alphaonex86/FPGAmotherboard/i386/fpga-ep4ce22/3dmodels/Intel_PQFP-100_19.05x19.05mm_P0.635mm.step

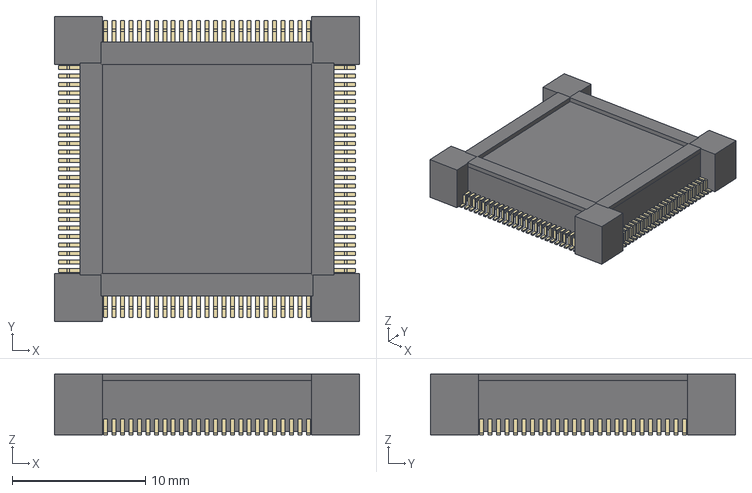
[picture p1: CAD file, 2026-10-18]
i386/fpga-ep4ce22/3dmodels/Intel_PQFP-100_19.05x19.05mm_P0.635mm.step
22.9 x 22.9 x 4.57 mm
