alphaonex86/FPGAmotherboard/i386/fpga-gw2ar18/hw/3dmodels/Oscillator_SMD_Abracon_ASE-4Pin_3.2x2.5mm.step

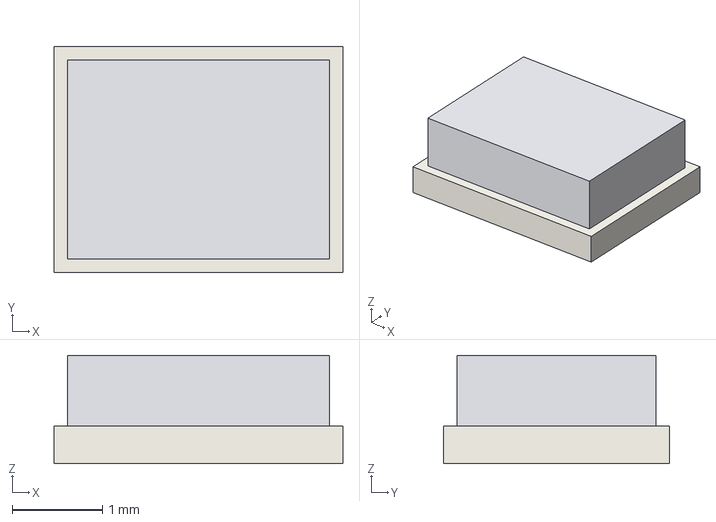
[picture p2: CAD file, 2026-10-18]
i386/fpga-gw2ar18/hw/3dmodels/Oscillator_SMD_Abracon_ASE-4Pin_3.2x2.5mm.step
3.20 x 2.50 x 1.20 mm
