alphaonex86/FPGAmotherboard/socket3/fpga-xc7a50t-csg324/hw/3dmodels/L_7.3x7.3_H4.5.step

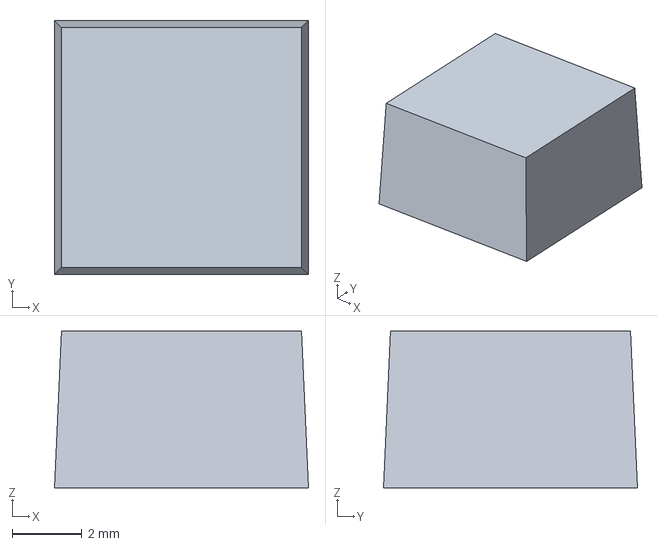
[picture p3: CAD file, 2026-10-29]
socket3/fpga-xc7a50t-csg324/hw/3dmodels/L_7.3x7.3_H4.5.step
7.30 x 7.30 x 4.50 mm
