alphaonex86/FPGAmotherboard/socket3/hw/3dmodels/Socket3_Am5x86_237.step

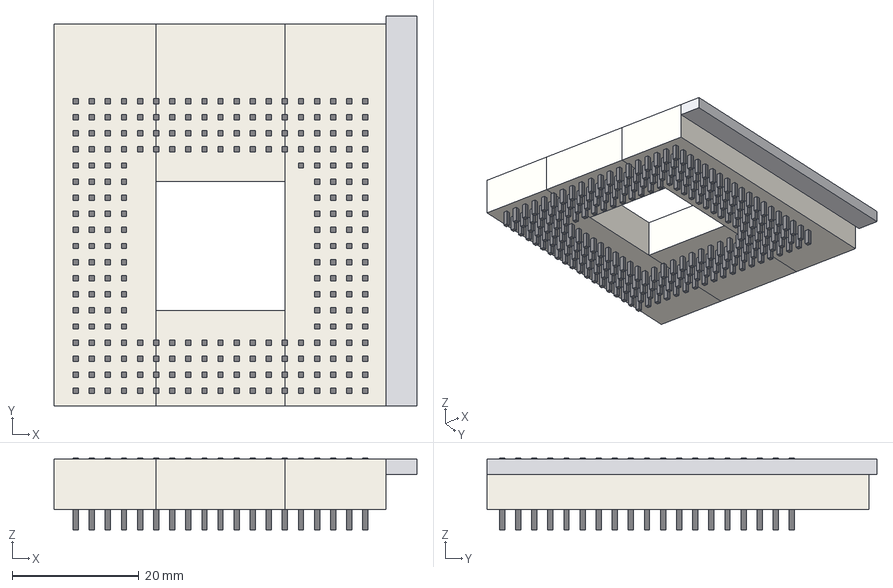
[picture p4: CAD file, 2026-10-29]
socket3/hw/3dmodels/Socket3_Am5x86_237.step
57.3 x 61.5 x 11.3 mm
