alphaonex86/FPGAmotherboard/socket370/fpga-ti180/hw/3dmodels/PGA370_Socket_ZIF.step

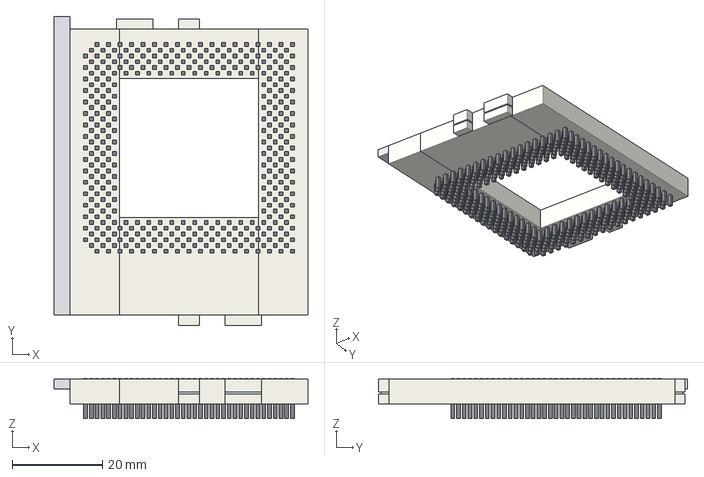
[picture p5: CAD file, 2026-10-18]
socket370/fpga-ti180/hw/3dmodels/PGA370_Socket_ZIF.step
56.1 x 68.3 x 8.89 mm
