alphaonex86/FPGAmotherboard/socket7/fpga-ti180/hw/3dmodels/Texas_RVF0040A_LQFN-CLIP-40_5x7mm_P0.5mm.step

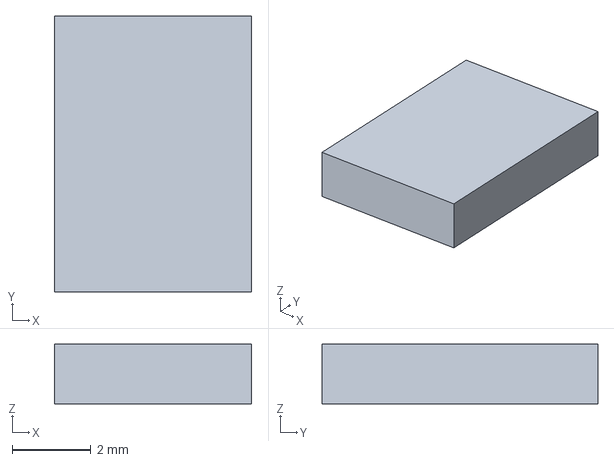
[picture p6: CAD file, 2026-10-18]
socket7/fpga-ti180/hw/3dmodels/Texas_RVF0040A_LQFN-CLIP-40_5x7mm_P0.5mm.step
5.00 x 7.00 x 1.52 mm
