alphaonex86/FPGAmotherboard/socket7/fpga-xc7a100t/3dmodels/Texas_RWW0021A_VQFN-HR-21_3x4mm.step

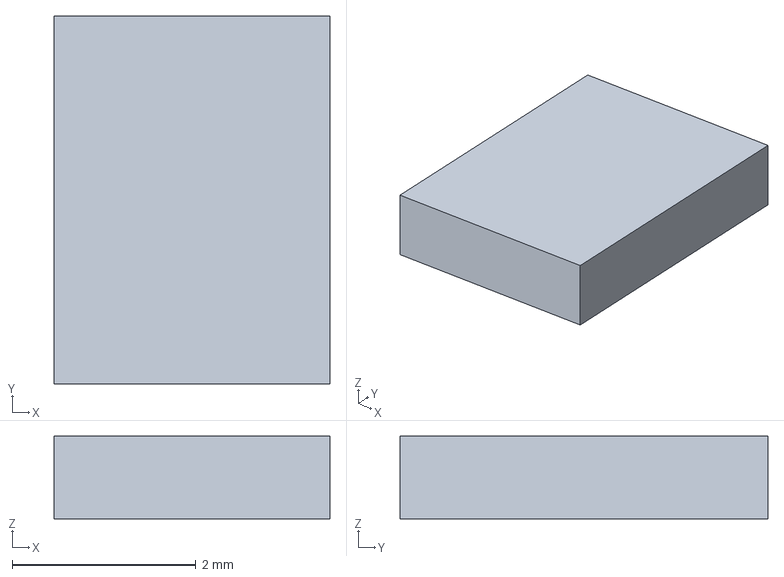
[picture p7: CAD file, 2026-10-18]
socket7/fpga-xc7a100t/3dmodels/Texas_RWW0021A_VQFN-HR-21_3x4mm.step
3.00 x 4.00 x 0.9 mm
