alphaonex86/FPGAmotherboard/i386/fpga-ep4ce22/3dmodels/L_6.3x6.3_H3.step

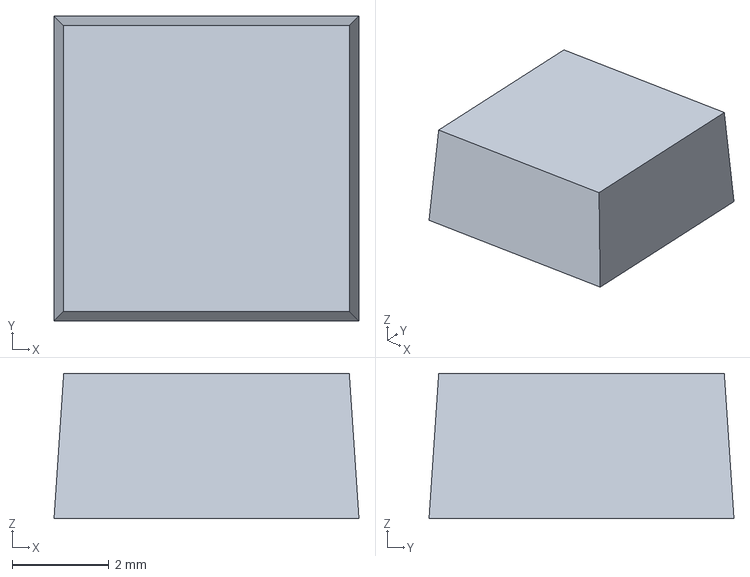
[picture p8: CAD file, 2026-10-18]
i386/fpga-ep4ce22/3dmodels/L_6.3x6.3_H3.step
6.30 x 6.30 x 3.00 mm
