alphaonex86/FPGAmotherboard/socket370/fpga-ti180/hw/3dmodels/Efinix_Ti180_J484_15x15mm.step

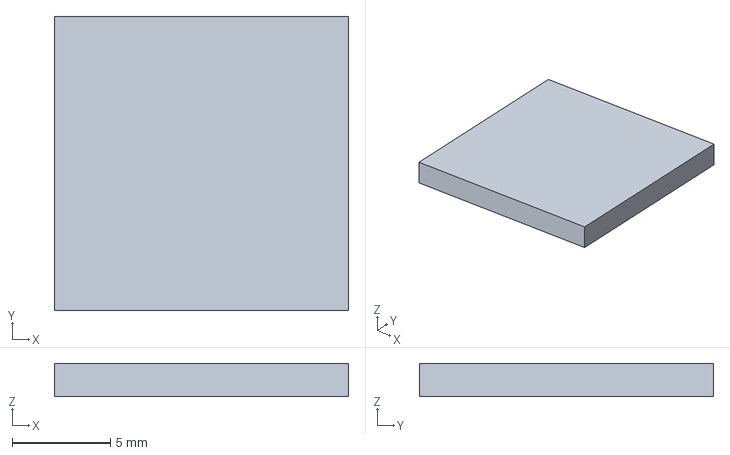
[picture p9: CAD file, 2026-10-18]
socket370/fpga-ti180/hw/3dmodels/Efinix_Ti180_J484_15x15mm.step
15.0 x 15.0 x 1.70 mm
