alphaonex86/FPGAmotherboard/socket7/fpga-ti180/hw/3dmodels/Socket7_P55C_296.step

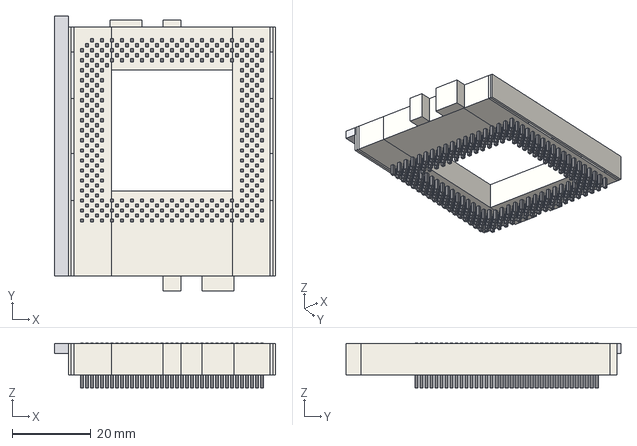
[picture p10: CAD file, 2026-10-18]
socket7/fpga-ti180/hw/3dmodels/Socket7_P55C_296.step
56.1 x 69.8 x 11.3 mm
