alphaonex86/FPGAmotherboard/socket3/fpga-xc7a50t-csg324/hw/3dmodels/RJ45_Hanrun_HR911105A_Horizontal.step

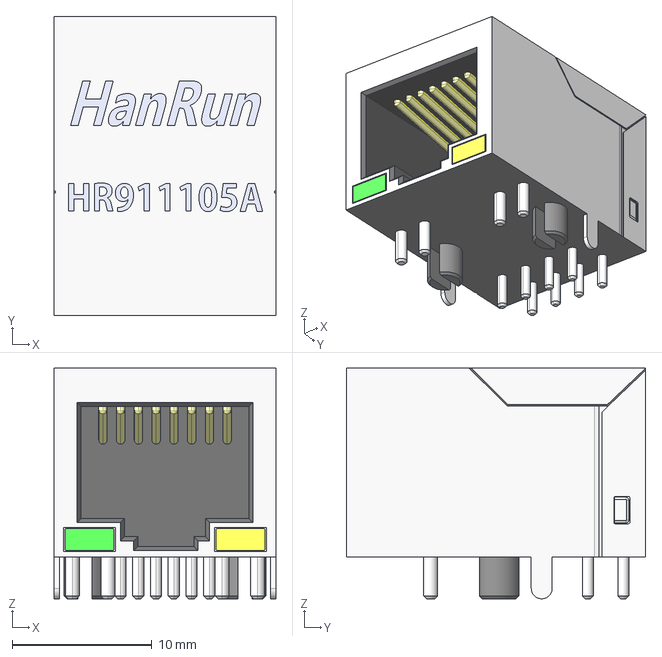
[picture p11: CAD file, 2026-10-18]
socket3/fpga-xc7a50t-csg324/hw/3dmodels/RJ45_Hanrun_HR911105A_Horizontal.step
15.9 x 21.4 x 16.5 mm
