alphaonex86/FPGAmotherboard/(list of files, cad)

Other CAD files:
socket370/fpga-xc7a100t/3dmodels/L_7.3x7.3_H4.5.step
i386/fpga-gw2ar18/hw/3dmodels/Intel_PQFP-100_19.05x19.05mm_P0.635mm.step
socket3/fpga-xc7a50t-csg324/hw/3dmodels/L_6.3x6.3_H3.step
socket3/hw/3dmodels/L_6.3x6.3_H3.step
i386/fpga-ep4ce22/3dmodels/Oscillator_SMD_Abracon_ASE-4Pin_3.2x2.5mm.step
i386/fpga-gw2ar18/hw/3dmodels/L_6.3x6.3_H3.step
socket3/hw/3dmodels/L_7.3x7.3_H4.5.step
socket370/fpga-xc7a100t/3dmodels/Texas_RVF0040A_LQFN-CLIP-40_5x7mm_P0.5mm.step
socket7/fpga-xc7a100t/3dmodels/L_7.3x7.3_H4.5.step
socket3/fpga-xc7a50t-csg324/hw/3dmodels/Texas_RVF0040A_LQFN-CLIP-40_5x7mm_P0.5mm.step
socket3/hw/3dmodels/Texas_RVF0040A_LQFN-CLIP-40_5x7mm_P0.5mm.step
socket370/fpga-ti180/hw/3dmodels/L_7.3x7.3_H4.5.step
socket370/fpga-xc7a100t/3dmodels/PGA370_Socket_ZIF.step
socket7/fpga-ti180/hw/3dmodels/L_7.3x7.3_H4.5.step
socket7/fpga-xc7a100t/3dmodels/Texas_RVF0040A_LQFN-CLIP-40_5x7mm_P0.5mm.step
socket370/fpga-ti180/hw/3dmodels/L_6.3x6.3_H3.step
socket7/fpga-ti180/hw/3dmodels/L_6.3x6.3_H3.step
socket7/fpga-xc7a100t/3dmodels/Socket7_P55C_296.step
