alphaonex86/FPGAmotherboard/socket3/fpga-xc7a50t-csg324/hw/socket3-csg324.kicad_pcb

## KiCad design socket3/fpga-xc7a50t-csg324/hw/socket3-csg324.kicad_pcb (2026-10-29)

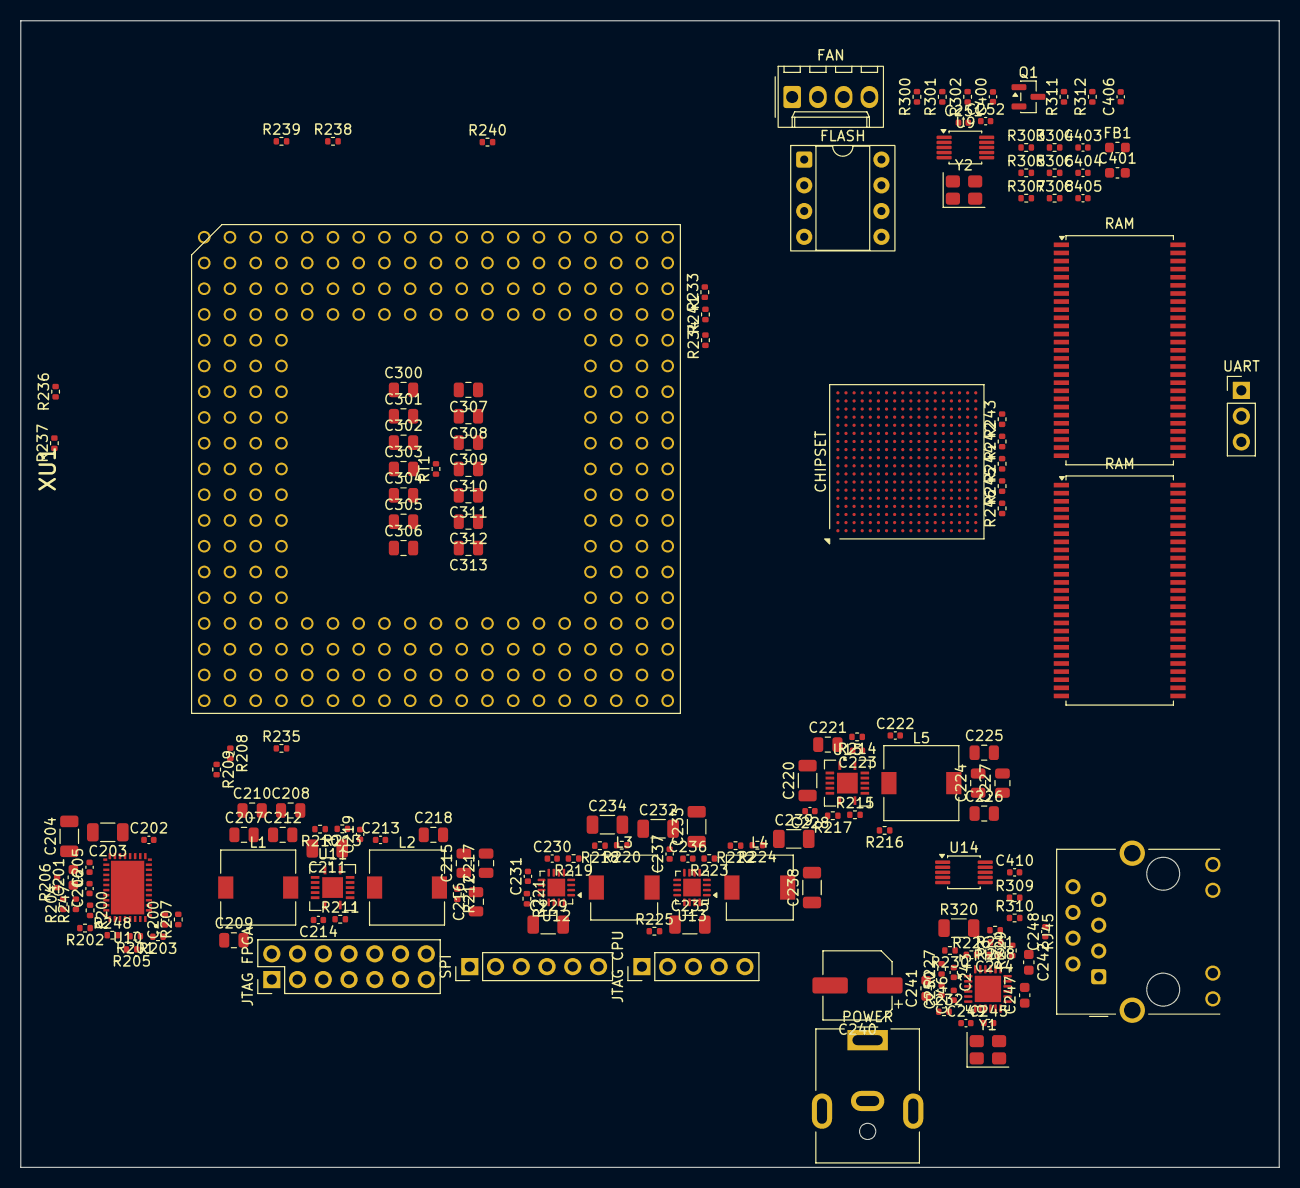
[picture p12: board socket3-csg324.kicad_pcb from above]

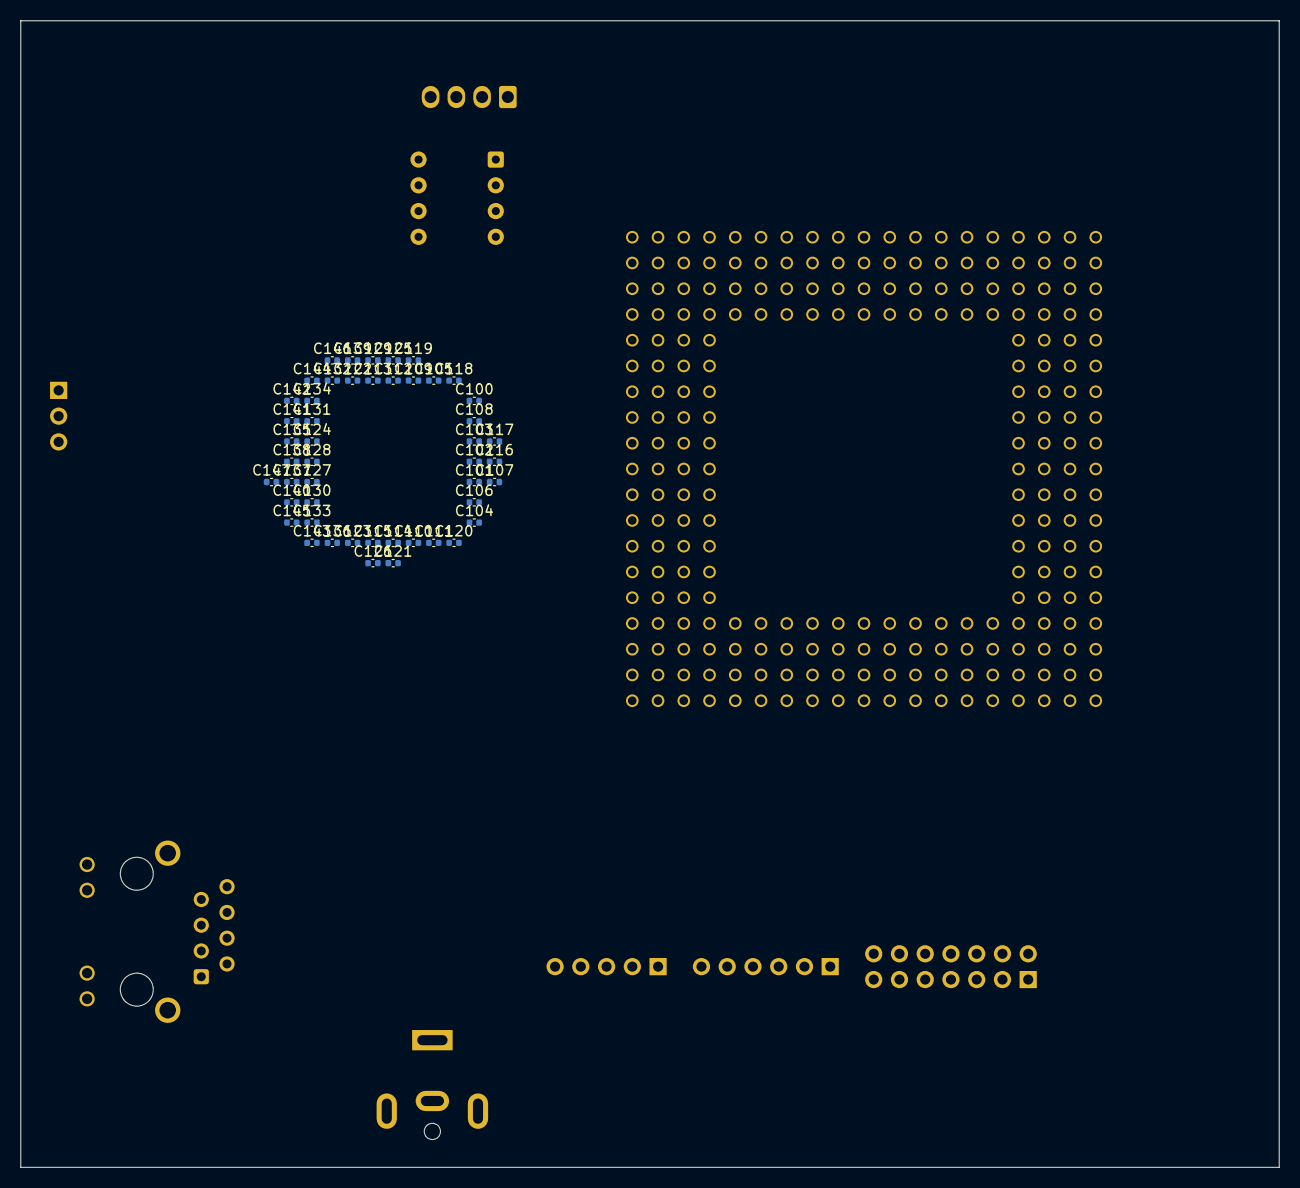
[picture p13: board socket3-csg324.kicad_pcb from below]

Board: 6 copper layers, 124.1 x 113.1 mm, 215 parts (48 on the bottom side), 267 nets, no tracks yet.

Parts:
C100, C101, C102, C103, C104, C105, C106, C107, C108, C109, C110, C111, C112, C113, C114, C115, C116, C117, C118, C119, C120, C121, C122, C123, C124, C125, C126, C127, C128, C129, C130, C131, C132, C133, C134, C135, C136, C137, C138, C139, C140, C141, C142, C143, C144, C145, C146, C147: 470nF; C_0402_1005Metric
C200: 1uF 16V X6S; C_0402_1005Metric
C201: 4.7uF 16V X5R; C_0603_1608Metric
C202: 100nF 16V X5R; C_0402_1005Metric
C203, C204, C211, C220, C229, C232, C233, C234, C235, C238, C239: 22uF 25V X5R; C_1206_3216Metric
C205, C214, C223, C403, C404, C405, C406: 10nF 50V X7R; C_0402_1005Metric
C206: 1uF 25V X5R; C_0402_1005Metric
C207, C208, C209, C210, C215, C216, C217, C218: 47uF 6.3V X5R; C_0805_2012Metric
C212, C221: 4.7uF 25V X7R; C_0805_2012Metric
C213, C222, C230, C236, C243, C244, C245, C248, C410: 100nF 16V X7R; C_0402_1005Metric
C219, C228: 8.2nF 50V X7R; C_0402_1005Metric
C224, C225, C226, C227: 47uF 10V X5R; C_0805_2012Metric
C231, C237: 3.3nF 50V X7R; C_0402_1005Metric
C240: 100uF 25V; CP_Elec_6.3x7.7
C241: 600R@100MHz bead; L_0603_1608Metric
C242: 10uF 10V X5R; C_0603_1608Metric
C246: 470pF 50V C0G; C_0402_1005Metric
C247: 1uF 16V X7R; C_0603_1608Metric
C249, C250: 15pF 50V C0G; C_0402_1005Metric
C251, C252: 4pF 50V C0G; C_0402_1005Metric
C300, C301, C302, C303, C304, C305, C306, C307, C308, C309, C310, C311, C312, C313: 22uF; C_0805_2012Metric
C400: 1nF 50V C0G; C_0402_1005Metric
C401: 470nF 50V X7R; C_0603_1608Metric
FB1: 600R@100MHz bead; L_0603_1608Metric
J1: HR911105A; RJ45_Hanrun_HR911105A_Horizontal
J2: SPI ISP; PinHeader_1x06_P2.54mm_Vertical
J3: PJ-063AH 12V; BarrelJack_CUI_PJ-063AH_Horizontal
J4: UART; PinHeader_1x03_P2.54mm_Vertical
J5: FPGA JTAG; PinHeader_2x07_P2.54mm_Vertical
J6: CPU JTAG; PinHeader_1x05_P2.54mm_Vertical
J7: fan 4-pin 1GND 2+12V 3TACH 4PWM; Molex_KK-254_AE-6410-04A_1x04_P2.54mm_Vertical
L1: VCORE out; L_7.3x7.3_H4.5
L2: 3V3 out; L_7.3x7.3_H4.5
L3: 1V0 out; L_6.3x6.3_H3
L4: 1V8 out; L_6.3x6.3_H3
L5: 5V out; L_7.3x7.3_H4.5
Q1: BSS138; SOT-23
R200: 10R 1%; R_0402_1005Metric
R201, R202, R205: 21.5k 1%; R_0402_1005Metric
R203: 90.9k 1%; R_0402_1005Metric
R204: 46.4k 1%; R_0402_1005Metric
R206: 4.64k 1%; R_0402_1005Metric
R207, R213, R217, R219, R223, R227, R233, R234, R235, R236, R237, R238, R239, R240, R301, R302, R303, R305, R309, R310, R311: 10k 1%; R_0402_1005Metric
R208: 1.33k 1%; R_0402_1005Metric
R209: 0R; R_0402_1005Metric
R210, R214, R220, R221, R224, R225: 100k 1%; R_0402_1005Metric
R211, R215, R300: 1.69k 1%; R_0402_1005Metric
R212: 31.6k 1%; R_0402_1005Metric
R216: 52.3k 1%; R_0402_1005Metric
R218, R308: 2.49k 1%; R_0402_1005Metric
R222: 12.4k 1%; R_0402_1005Metric
R226: 12.1k 1%; R_0402_1005Metric
R228, R229, R230, R231: 49.9 1%; R_0402_1005Metric
R232, R247: 500R 1%; R_0402_1005Metric
R241: 8.2k 1%; R_0402_1005Metric
R242, R243, R244, R248: 1k 1%; R_0402_1005Metric
R245, R246, R304, R306, R312: 4.02k 1%; R_0402_1005Metric
R307: 30.9k 1%; R_0402_1005Metric
R320: 10mR 1% 1W; R_1206_3216Metric
RT1: 10k NTC 1% B3380; R_0402_1005Metric
U2: XC7A50T-2CSG324I; Xilinx_CSG324
U3, U4: W9825G6KH-6I; TSOP-II-54_22.2x10.16mm_P0.8mm
U7: LAN8720A-CP-TR; QFN-24-1EP_4x4mm_P0.5mm_EP2.6x2.6mm
U8: W25Q64JVDAIQ (DIP-8, socketed); DIP-8_W7.62mm_Socket
U9: SI5351A-B-GTR; MSOP-10_3x3mm_P0.5mm
U10: TPS546B24ARVFR VCORE; Texas_RVF0040A_LQFN-CLIP-40_5x7mm_P0.5mm
U11: TPS54620RGYR 3V3; Texas_S-PVQFN-N14
U12: TPS62130RGTR 1V0; QFN-16-1EP_3x3mm_P0.5mm_EP1.75x1.75mm
U13: TPS62130RGTR 1V8; QFN-16-1EP_3x3mm_P0.5mm_EP1.75x1.75mm
U14: INA226AIDGSR; MSOP-10_3x3mm_P0.5mm
U15: TPS54620RGYR 5V; Texas_S-PVQFN-N14
XU1: Socket 3 ZIF 237p; Socket3_Am5x86_237
Y1, Y2: 25MHz; Crystal_SMD_3225-4Pin_3.2x2.5mm

Connections:
+1V0: C108.1, C111.1, C112.1, C115.1, C116.1, C120.1, C122.1, C123.1, C127.1, C128.1, C130.1, C131.1, C133.1, C134.1, C137.1, C138.1, C232.1, C233.1, C234.1, L3.2, R218.1, R220.1, U2.F8, U2.F10, U2.G7, U2.G9, U2.G11, U2.H8, U2.J7, U2.J11, U2.K8, U2.L7, U2.L11, U2.M8, U2.M10, U2.N7, U2.N9, U2.N11, U12.14
+1V8: C107.1, C109.1, C118.1, C124.1, C132.1, C238.1, C239.1, FB1.1, L4.2, R222.1, R224.1, U2.E8, U2.F12, U2.H12, U2.K12, U2.M12, U13.14
+1V8_ADC: C117.1, C401.1, FB1.2, U2.H10
+3V3: C100.1, C101.1, C102.1, C103.1, C104.1, C105.1, C106.1, C110.1, C113.1, C114.1, C119.1, C121.1, C125.1, C126.1, C129.1, C135.1, C136.1, C139.1, C140.1, C141.1, C142.1, C143.1, C144.1, C145.1, C146.1, C147.1, C215.1, C216.1, C217.1, C218.1, C241.1, C245.1, C410.1, J2.1, J5.2, L2.2, R207.1, R212.1, R242.2, R245.2, R246.2, R301.2, R305.1, R309.2, R310.2, R311.1, U2.A7, U2.A17, U2.B10, U2.C3, U2.C13, U2.D6, U2.D16, U2.F2, U2.G5, U2.G15, U2.H18, U2.J1, U2.K4, U2.K14, U2.L15, U2.L17, U2.N3, U2.N13, U2.P6, U2.P8, U2.P16, U2.R9, U2.T2, U2.T12, U2.U5, U2.U15, U2.V8, U2.V18, U3.1, U3.3, U3.9, U3.14, U3.27, U3.43, U3.49, U4.1, U4.3, U4.9, U4.14, U4.27, U4.43, U4.49, U7.9, U8.8, U9.1, U9.7, U14.6
+5V: C224.1, C225.1, C226.1, C227.1, C229.1, C230.1, C235.1, C236.1, L5.2, R216.1, R221.1, R225.1, U12.10, U12.11, U12.12, U13.10, U13.11, U13.12
+12V: C203.1, C204.1, C205.1, C211.1, C212.1, C220.1, C221.1, C240.1, J7.2, R200.1, R307.1, R320.2, U10.22, U10.23, U10.24, U10.25, U11.4, U11.5, U11.6, U14.8, U14.9, U15.4, U15.5, U15.6
+12V_IN: J3.1, R320.1, U14.10
GND: C100.2, C101.2, C102.2, C103.2, C104.2, C105.2, C106.2, C107.2, C108.2, C109.2, C110.2, C111.2, C112.2, C113.2, C114.2, C115.2, C116.2, C117.2, C118.2, C119.2, C120.2, C121.2, C122.2, C123.2, C124.2, C125.2, C126.2, C127.2, C128.2, C129.2, C130.2, C131.2, C132.2, C133.2, C134.2, C135.2, C136.2, C137.2, C138.2, C139.2, C140.2, C141.2, C142.2, C143.2, C144.2, C145.2, C146.2, C147.2, C201.2, C203.2, C204.2, C205.2, C206.2, C207.2, C208.2, C209.2, C210.2, C211.2, C212.2, C214.2, C215.2, C216.2, C217.2, C218.2, C219.2, C220.2, C221.2, C223.2, C224.2, C225.2, C226.2, C227.2, C228.2, C229.2, C230.2, C231.2, C232.2, C233.2, C234.2, C235.2, C236.2, C237.2, C238.2, C239.2, C240.2, C242.2, C243.2, C244.2, C245.2, C246.2, C247.2, C248.2, C249.2, C250.2, C251.2, C252.2, C300.2, C301.2, C302.2, C303.2, C304.2, C305.2, C306.2, C307.2, C308.2, C309.2, C310.2, C311.2, C312.2, C313.2, C400.2, C401.2, C403.2, C404.2, C405.2, C406.2, C410.2, J1.8, J1.SH, J2.2, J3.2, J4.1, J5.1, J5.3, J5.5, J5.7, J5.9, J5.11, J5.13, J6.5, J7.1, Q1.2, R202.2, R204.2, R206.2, R209.1, R210.2, R213.2, R214.2, R217.2, R219.2, R223.2, R226.2, R227.2, R239.2, R243.2, R244.2, R247.2, R302.2, R304.2, R306.2, R308.2, R312.2, RT1.2, U2.A2, U2.A12, U2.A18, U2.B5, U2.B12, U2.B14, U2.B15, U2.C8, U2.C14, U2.C18, U2.D1, U2.D11, U2.E4, U2.E14, U2.F7, U2.F9, U2.F11, U2.F17, U2.G8, U2.G10, U2.G12, U2.H3, U2.H7, U2.H9, U2.H11, U2.H13, U2.J6, U2.J8, U2.J9, U2.J10, U2.J12, U2.J16, U2.K7, U2.K9, U2.K10, U2.K11, U2.L2, U2.L8, U2.L12, U2.M5, U2.M7, U2.M9, U2.M11, U2.M15, U2.N8, U2.N10, U2.N12, U2.N18, U2.P1, U2.R4, U2.R14, U2.T7, U2.T17, U2.U10, U2.V3, U2.V13, U3.6, U3.12, U3.28, U3.41, U3.46, U3.52, U3.54, U4.6, U4.12, U4.28, U4.41, U4.46, U4.52, U4.54, U7.25, U8.4, U9.8, U10.6, U10.13, U10.14, U10.15, U10.16, U10.17, U10.18, U10.19, U10.20, U10.21, U10.36, U10.37, U10.41, U11.2, U11.3, U11.15, U12.6, U12.15, U12.16, U12.17, U13.6, U13.15, U13.16, U13.17, U14.1, U14.2, U14.7, U15.2, U15.3, U15.15, XU1.A7 (VSS), XU1.A9 (VSS), XU1.A11 (VSS), XU1.B3 (VSS), XU1.B4 (VSS), XU1.B5 (VSS), XU1.E1 (VSS), XU1.E17 (VSS), XU1.G1 (VSS), XU1.G17 (VSS), XU1.H1 (VSS), XU1.H17 (VSS), XU1.K1 (VSS), XU1.K17 (VSS), XU1.L1 (VSS), XU1.L17 (VSS), XU1.M1 (VSS), XU1.M17 (VSS), XU1.P17 (VSS), XU1.Q2 (VSS), XU1.R4 (VSS), XU1.R17 (CLKMUL), XU1.S6 (VSS), XU1.S8 (VSS), XU1.S9 (VSS), XU1.S10 (VSS), XU1.S11 (VSS), XU1.S12 (VSS), XU1.S14 (VSS), Y1.2, Y1.4, Y2.2, Y2.4
VCORE: C207.1, C208.1, C209.1, C210.1, C300.1, C301.1, C302.1, C303.1, C304.1, C305.1, C306.1, C307.1, C308.1, C309.1, C310.1, C311.1, C312.1, C313.1, L1.2, R208.1, R233.2, R234.2, R235.2, R236.2, R237.2, R238.2, R240.2, R241.2, R303.1, XU1.B7 (VCC), XU1.B9 (VCC), XU1.B11 (VCC), XU1.C4 (VCC), XU1.C5 (VCC), XU1.E2 (VCC), XU1.E16 (VCC), XU1.G2 (VCC), XU1.G16 (VCC), XU1.H16 (VCC), XU1.K2 (VCC), XU1.K16 (VCC), XU1.L16 (VCC), XU1.M2 (VCC), XU1.M16 (VCC), XU1.P16 (VCC), XU1.R3 (VCC), XU1.R6 (VCC), XU1.R8 (VCC), XU1.R9 (VCC), XU1.R10 (VCC), XU1.R11 (VCC), XU1.R14 (VCC)
cpu_a20m_n: U2.A13, XU1.D15 (A20M)
cpu_a[2]: U2.A3, XU1.Q14 (A2)
cpu_a[3]: U2.D2, XU1.R15 (A3)
cpu_a[4]: U2.H1, XU1.S16 (A4)
cpu_a[5]: U2.H4, XU1.Q12 (A5)
cpu_a[6]: U2.G1, XU1.S15 (A6)
cpu_a[7]: U2.J4, XU1.Q13 (A7)
cpu_a[8]: U2.C2, XU1.R13 (A8)
cpu_a[9]: U2.G4, XU1.Q11 (A9)
cpu_a[10]: U2.F1, XU1.S13 (A10)
cpu_a[11]: U2.B2, XU1.R12 (A11)
cpu_a[12]: U2.E1, XU1.S7 (A12)
cpu_a[13]: U2.F4, XU1.Q10 (A13)
cpu_a[14]: U2.C1, XU1.S5 (A14)
cpu_a[15]: U2.J3, XU1.R7 (A15)
cpu_a[16]: U2.D4, XU1.Q9 (A16)
cpu_a[17]: U2.F5, XU1.Q3 (A17)
cpu_a[18]: U2.G3, XU1.R5 (A18)
cpu_a[19]: U2.H5, XU1.Q4 (A19)
cpu_a[20]: U2.C4, XU1.Q8 (A20)
cpu_a[21]: U2.J5, XU1.Q5 (A21)
cpu_a[22]: U2.B4, XU1.Q7 (A22)
cpu_a[23]: U2.J2, XU1.S3 (A23)
cpu_a[24]: U2.A4, XU1.Q6 (A24)
cpu_a[25]: U2.F3, XU1.R2 (A25)
cpu_a[26]: U2.H2, XU1.S2 (A26)
cpu_a[27]: U2.G2, XU1.S1 (A27)
cpu_a[28]: U2.E3, XU1.R1 (A28)
cpu_a[29]: U2.A5, XU1.P2 (A29)
cpu_a[30]: U2.C5, XU1.P3 (A30)
cpu_a[31]: U2.E5, XU1.Q1 (A31)
cpu_ads_n: U2.K1, XU1.S17 (ADS)
cpu_ahold: U2.G17, XU1.A17 (AHOLD)
cpu_be_n[0]: U2.D8, XU1.K15 (BE0)
cpu_be_n[1]: U2.D9, XU1.J16 (BE1)
cpu_be_n[2]: U2.C9, XU1.J15 (BE2)
cpu_be_n[3]: U2.B11, XU1.F17 (BE3)
cpu_blast_n: U2.E2, XU1.R16 (BLAST)
cpu_boff_n: U2.D13, XU1.D17 (BOFF)
cpu_brdy_n: U2.D10, XU1.H15 (BRDY)
cpu_breq: U2.B3, XU1.Q15 (BREQ)
cpu_bs8_n: R234.1, XU1.D16 (BS8)
cpu_bs16_n: R233.1, XU1.C17 (BS16)
cpu_cache_n: U2.E16, XU1.B12 (CACHE)
cpu_clk: U9.10, XU1.C3 (CLK)
cpu_d[0]: U2.H6, XU1.P1 (D0)
cpu_d[1]: U2.C6, XU1.N2 (D1)
cpu_d[2]: U2.B6, XU1.N1 (D2)
cpu_d[3]: U2.C10, XU1.H2 (D3)
cpu_d[4]: U2.E7, XU1.M3 (D4)
cpu_d[5]: U2.A9, XU1.J2 (D5)
cpu_d[6]: U2.B7, XU1.L2 (D6)
cpu_d[7]: U2.C7, XU1.L3 (D7)
cpu_d[8]: U2.J13, XU1.F2 (D8)
cpu_d[9]: U2.G14, XU1.D1 (D9)
cpu_d[10]: U2.F13, XU1.E3 (D10)
cpu_d[11]: U2.K16, XU1.C1 (D11)
cpu_d[12]: U2.C11, XU1.G3 (D12)
cpu_d[13]: U2.H14, XU1.D2 (D13)
cpu_d[14]: U2.B8, XU1.K3 (D14)
cpu_d[15]: U2.K13, XU1.F3 (D15)
cpu_d[16]: U2.B9, XU1.J3 (D16)
cpu_d[17]: U2.J14, XU1.D3 (D17)
cpu_d[18]: U2.A15, XU1.C2 (D18)
cpu_d[19]: U2.H17, XU1.B1 (D19)
cpu_d[20]: U2.D18, XU1.A1 (D20)
cpu_d[21]: U2.J17, XU1.B2 (D21)
cpu_d[22]: U2.E18, XU1.A2 (D22)
cpu_d[23]: U2.F18, XU1.A4 (D23)
cpu_d[24]: U2.G18, XU1.A6 (D24)
cpu_d[25]: U2.A16, XU1.B6 (D25)
cpu_d[26]: U2.D15, XU1.C7 (D26)
cpu_d[27]: U2.C15, XU1.C6 (D27)
cpu_d[28]: U2.E15, XU1.C8 (D28)
cpu_d[29]: U2.J18, XU1.A8 (D29)
cpu_d[30]: U2.F15, XU1.C9 (D30)
cpu_d[31]: U2.B16, XU1.B8 (D31)
cpu_dc_n: U2.A6, XU1.M15 (D_C)
cpu_dp[0]: R235.1, XU1.N3 (DP0)
cpu_dp[1]: R236.1, XU1.F1 (DP1)
cpu_dp[2]: R237.1, XU1.H3 (DP2)
cpu_dp[3]: R238.1, XU1.A5 (DP3)
cpu_eads_n: U2.H16, XU1.B17 (EADS)
cpu_ferr_n: U2.K15, XU1.C14 (FERR)
cpu_flush_n: U2.A14, XU1.C15 (FLUSH)
cpu_hitm_n: U2.C17, XU1.A12 (HITM)
cpu_hlda: U2.D5, XU1.P15 (HLDA)
cpu_hold: U2.G13, XU1.E15 (HOLD)
cpu_ignne_n: U2.D17, XU1.A15 (IGNNE)
cpu_intr: U2.E17, XU1.A16 (INTR)
cpu_inv: U2.B17, XU1.A10 (INV)
cpu_ken_n: U2.D12, XU1.F15 (KEN)
cpu_lock_n: U2.E6, XU1.N15 (LOCK)
cpu_mio_n: U2.F6, XU1.N16 (M_IO)
cpu_nmi: U2.G16, XU1.B15 (NMI)
cpu_pcd: U2.A8, XU1.J17 (PCD)
cpu_plock_n: U2.D3, XU1.Q16 (PLOCK)
cpu_pwt: U2.D7, XU1.L15 (PWT)
cpu_rdy_n: U2.A11, XU1.F16 (RDY)
cpu_reset: R241.1, U2.F14, XU1.C16 (RESET)
cpu_smi_n: U2.C16, XU1.B10 (SMI)
cpu_smiact_n: U2.J15, XU1.C12 (SMIACT)
cpu_sreset: U2.H15, XU1.C10 (SRESET)
cpu_stpclk_n: U2.A10, XU1.G15 (STPCLK)
cpu_tck: J6.1, R239.1, XU1.A3 (TCK)
cpu_tdi: J6.3, XU1.A14 (TDI)
cpu_tdo: J6.4, XU1.B16 (TDO)
cpu_tms: J6.2, XU1.B14 (TMS)
cpu_up_n: R240.1, XU1.C11 (UP)
cpu_voldet: U2.B1, XU1.S4 (VOLDET)
cpu_wbwt_n: U2.F16, XU1.B13 (WB_WT)
cpu_wr_n: U2.G6, XU1.N17 (W_R)
en_vcore: R247.1, U2.A1, U10.27
eth_mdc: U2.L4, U7.13
eth_mdi_rxn: J1.6, R231.1, U7.22
eth_mdi_rxp: J1.3, R230.1, U7.23
eth_mdi_txn: J1.2, R229.1, U7.20
eth_mdi_txp: J1.1, R228.1, U7.21
eth_mdio: U2.L1, U7.12
eth_nintsel: R227.1, U7.2
eth_rbias: R226.1, U7.24
eth_ref_clk: U2.N5, U7.14
eth_rmii_crs_dv: U2.M3, U7.11
eth_rmii_rx_er: U2.L3, U7.10
eth_rmii_rxd[0]: U2.K3, U7.8
eth_rmii_rxd[1]: U2.M4, U7.7
eth_rmii_tx_en: U2.M6, U7.16
eth_rmii_txd[0]: U2.L6, U7.17
eth_rmii_txd[1]: U2.K6, U7.18
eth_rst_n: U2.K5, U7.15
eth_vdda: C241.2, C242.1, C243.1, C244.1, C248.1, J1.4, J1.5, R228.2, R229.2, R230.2, R231.2, U7.1, U7.19
eth_vddcr: C246.1, C247.1, U7.6
eth_xtal1: C249.1, U7.5, Y1.1
eth_xtal2: C250.1, R232.1, Y1.3
eth_xtal2_drv: R232.2, U7.4
fan_pwm: J7.4, Q1.3
fan_pwm_g: Q1.1, R302.1, U2.V17
fan_tach: J7.3, R300.1, R301.1
fan_tach_f: C400.1, R300.2, U2.V16
fpga_init_b: R246.1, U2.P7
fpga_m0: R242.1, U2.P12
fpga_m1: R243.1, U2.P13
fpga_m2: R244.1, U2.P11
fpga_program_b: R245.1, U2.P9
fpga_refclk: U2.P15, U9.9
i2c_scl: R309.1, U2.V14, U9.4, U10.3, U14.5
i2c_sda: R310.1, U2.V12, U9.5, U10.2, U14.4
jtag_tck: J5.6, U2.E10
jtag_tdi: J5.10, U2.E11
jtag_tdo: J5.8, U2.E13
jtag_tms: J5.4, U2.E12
sdram_a[0]: U2.R3, U3.23, U4.23
sdram_a[1]: U2.N2, U3.24, U4.24
sdram_a[2]: U2.R2, U3.25, U4.25
sdram_a[3]: U2.R1, U3.26, U4.26
sdram_a[4]: U2.T1, U3.29, U4.29
sdram_a[5]: U2.N1, U3.30, U4.30
sdram_a[6]: U2.P2, U3.31, U4.31
sdram_a[7]: U2.T3, U3.32, U4.32
sdram_a[8]: U2.P3, U3.33, U4.33
sdram_a[9]: U2.P4, U3.34, U4.34
sdram_a[10]: U2.T4, U3.22, U4.22
sdram_a[11]: U2.T5, U3.35, U4.35
sdram_a[12]: U2.P5, U3.36, U4.36
sdram_ba[0]: U2.R5, U3.20, U4.20
sdram_ba[1]: U2.N4, U3.21, U4.21
sdram_cas_n: U2.T8, U3.17, U4.17
sdram_cke: U2.T6, U3.37, U4.37
sdram_clk: U2.R7, U3.38, U4.38
sdram_cs_n: U2.L5, U3.19, U4.19
sdram_dq[0]: U2.R18, U3.2
sdram_dq[1]: U2.U18, U3.4
sdram_dq[2]: U2.T16, U3.5
sdram_dq[3]: U2.T15, U3.7
sdram_dq[4]: U2.U14, U3.8
sdram_dq[5]: U2.U13, U3.10
sdram_dq[6]: U2.T11, U3.11
sdram_dq[7]: U2.V11, U3.13
sdram_dq[8]: U2.T10, U3.42
sdram_dq[9]: U2.U11, U3.44
sdram_dq[10]: U2.U12, U3.45
sdram_dq[11]: U2.T13, U3.47
sdram_dq[12]: U2.T14, U3.48
sdram_dq[13]: U2.U16, U3.50
sdram_dq[14]: U2.U17, U3.51
sdram_dq[15]: U2.T18, U3.53
sdram_dq[16]: U2.U9, U4.2
sdram_dq[17]: U2.U8, U4.4
sdram_dq[18]: U2.V7, U4.5
sdram_dq[19]: U2.U6, U4.7
sdram_dq[20]: U2.V5, U4.8
sdram_dq[21]: U2.V4, U4.10
sdram_dq[22]: U2.M2, U4.11
sdram_dq[23]: U2.V2, U4.13
sdram_dq[24]: U2.M1, U4.42
sdram_dq[25]: U2.U2, U4.44
sdram_dq[26]: U2.U3, U4.45
sdram_dq[27]: U2.U4, U4.47
sdram_dq[28]: U2.V6, U4.48
sdram_dq[29]: U2.N6, U4.50
sdram_dq[30]: U2.U7, U4.51
sdram_dq[31]: U2.V9, U4.53
sdram_dqm[0]: U2.V10, U3.15
sdram_dqm[1]: U2.T9, U3.39
sdram_dqm[2]: U2.U1, U4.15
sdram_dqm[3]: U2.V1, U4.39
sdram_ras_n: U2.R6, U3.18, U4.18
sdram_we_n: U2.R8, U3.16, U4.16
spi_clk: J2.4, U2.E9, U8.6
spi_cs_n: J2.3, U2.L13, U8.1
spi_dq0: J2.6, U2.K17, U8.5
spi_dq1: J2.5, U2.K18, U8.2
spi_dq2: U2.L14, U8.3
spi_dq3: U2.M14, U8.7
sw_1v0: L3.1, U12.1, U12.2, U12.3
sw_1v8: L4.1, U13.1, U13.2, U13.3
sw_3v3: C213.2, L2.1, U11.11, U11.12
sw_5v: C222.2, L5.1, U15.11, U15.12
sw_vcore: C202.2, L1.1, U10.8, U10.9, U10.10, U10.11, U10.12
tsen_socket: C406.1, R311.2, R312.1, RT1.1, U2.B13
u9_xa: C251.1, U9.2, Y2.1
u9_xb: C252.1, U9.3, Y2.3
u10_avin: C206.1, R200.2, U10.26
u10_boot: C202.1, U10.7
u10_bp1v5: C200.1, R201.1, R203.1, R205.1, U10.4
u10_drtn: C200.2, U10.5
u10_msel1: R201.2, R202.1, U10.32
u10_msel2: R203.2, R204.1, U10.29
u10_pgood: R207.2, U10.1
u10_vdd5: C201.1, U10.28
u10_vsel: R205.2, R206.1, U10.30
u11_boot: C213.1, U11.13
u11_comp: R211.1, U11.8
u11_compz: C219.1, R211.2
u11_fb: R212.2, R213.1, U11.7
u11_rt: R210.1, U11.1
u11_ss: C214.1, U11.9
u12_en: R221.2, U12.13
u12_fb: R218.2, R219.1, U12.5
u12_pg: R220.2, U12.4
u12_ss: C231.1, U12.9
u13_en: R225.2, U13.13
u13_fb: R222.2, R223.1, U13.5
u13_pg: R224.2, U13.4
u13_ss: C237.1, U13.9
u15_boot: C222.1, U15.13
u15_comp: R215.1, U15.8
u15_compz: C228.1, R215.2
u15_fb: R216.2, R217.1, U15.7
u15_rt: R214.1, U15.1
u15_ss: C223.1, U15.9
uart_rx: J4.2, U2.R15
uart_tx: J4.3, U2.R13
vcore_gsense: R209.2, R248.2, U10.34
vcore_sense: R208.2, R248.1, U10.33
vsen_3v3: C404.1, R305.2, R306.1, U2.C12
vsen_12v: C405.1, R307.2, R308.1, U2.B18
vsen_vcore: C403.1, R303.2, R304.1, U2.D14
