alphaonex86/FPGAmotherboard/socket7/fpga-xc7a100t/socket7-motherboard.kicad_pcb

## KiCad design socket7/fpga-xc7a100t/socket7-motherboard.kicad_pcb (2026-10-29)

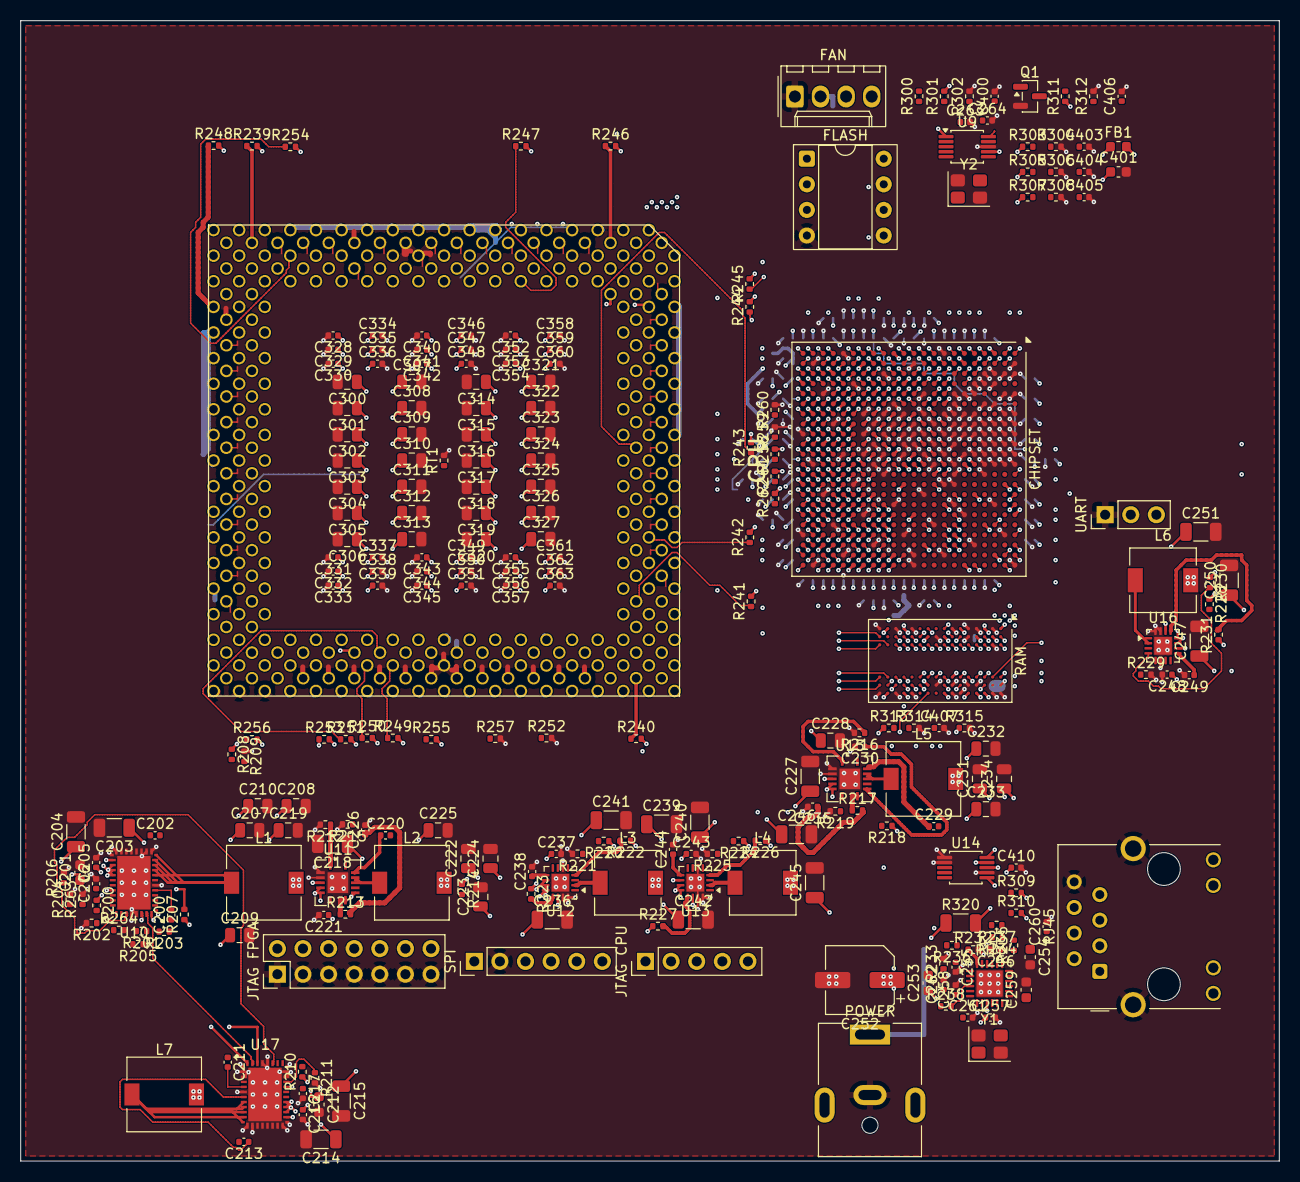
[picture p14: board socket7-motherboard.kicad_pcb from above]

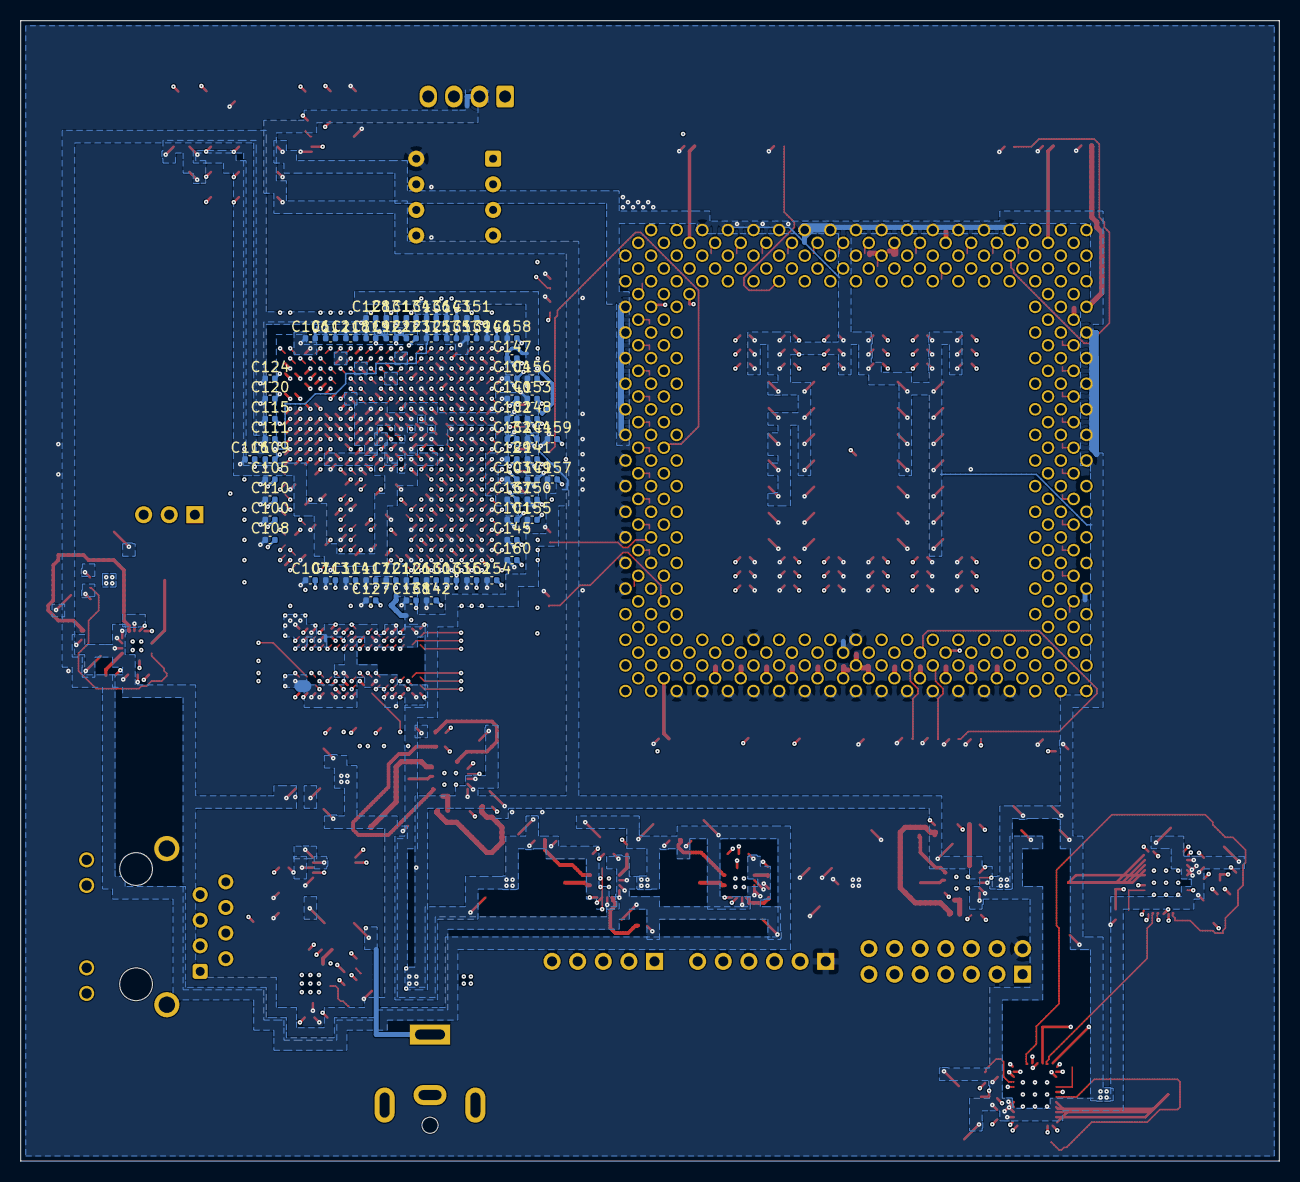
[picture p15: board socket7-motherboard.kicad_pcb from below]

Board: 8 copper layers, 124.8 x 113.1 mm, 313 parts (61 on the bottom side), 311 nets.

Parts:
C100, C101, C102, C103, C104, C105, C106, C107, C108, C109, C110, C111, C112, C113, C114, C115, C116, C117, C118, C119, C120, C121, C122, C123, C124, C125, C126, C127, C128, C129, C130, C131, C132, C133, C134, C135, C136, C137, C138, C139, C140, C141, C142, C143, C144, C145, C146, C147, C148, C149, C150, C151, C152, C153, C154, C155, C156, C157, C158, C159, C160: 470nF; C_0402_1005Metric
C200, C211: 1uF 16V X6S; C_0402_1005Metric
C201, C212: 4.7uF 16V X5R; C_0603_1608Metric
C202, C213: 100nF 16V X5R; C_0402_1005Metric
C203, C204, C214, C215, C218, C227, C236, C239, C240, C241, C242, C245, C246, C247, C250, C251: 22uF 25V X5R; C_1206_3216Metric
C205, C216, C221, C230, C403, C404, C405, C406: 10nF 50V X7R; C_0402_1005Metric
C206, C217: 1uF 25V X5R; C_0402_1005Metric
C207, C208, C209, C210, C222, C223, C224, C225: 47uF 6.3V X5R; C_0805_2012Metric
C219, C228: 4.7uF 25V X7R; C_0805_2012Metric
C220, C229, C237, C243, C248, C255, C256, C257, C260, C407, C410: 100nF 16V X7R; C_0402_1005Metric
C226, C235: 8.2nF 50V X7R; C_0402_1005Metric
C231, C232, C233, C234: 47uF 10V X5R; C_0805_2012Metric
C238, C244, C249: 3.3nF 50V X7R; C_0402_1005Metric
C252: 100uF 25V; CP_Elec_6.3x7.7
C253: 600R@100MHz bead; L_0603_1608Metric
C254: 10uF 10V X5R; C_0603_1608Metric
C258: 470pF 50V C0G; C_0402_1005Metric
C259: 1uF 16V X7R; C_0603_1608Metric
C261, C262: 15pF 50V C0G; C_0402_1005Metric
C263, C264: 4pF 50V C0G; C_0402_1005Metric
C300, C301, C302, C303, C304, C305, C306, C307, C308, C309, C310, C311, C312, C313, C314, C315, C316, C317, C318, C319, C320, C321, C322, C323, C324, C325, C326, C327: 22uF; C_0805_2012Metric
C328, C329, C330, C331, C332, C333, C334, C335, C336, C337, C338, C339, C340, C341, C342, C343, C344, C345, C346, C347, C348, C349, C350, C351, C352, C353, C354, C355, C356, C357, C358, C359, C360, C361, C362, C363: 100nF; C_0402_1005Metric
C400: 1nF 50V C0G; C_0402_1005Metric
C401: 470nF 50V X7R; C_0603_1608Metric
FB1: 600R@100MHz bead; L_0603_1608Metric
J1: HR911105A; RJ45_Hanrun_HR911105A_Horizontal
J2: SPI ISP; PinHeader_1x06_P2.54mm_Vertical
J3: PJ-063AH 12V; BarrelJack_CUI_PJ-063AH_Horizontal
J4: UART; PinHeader_1x03_P2.54mm_Vertical
J5: FPGA JTAG; PinHeader_2x07_P2.54mm_Vertical
J6: CPU JTAG; PinHeader_1x05_P2.54mm_Vertical
J7: fan 4-pin 1GND 2+12V 3TACH 4PWM; Molex_KK-254_AE-6410-04A_1x04_P2.54mm_Vertical
L1: VCC2 out; L_7.3x7.3_H4.5
L2: 3V3 out; L_7.3x7.3_H4.5
L3: 1V0 out; L_6.3x6.3_H3
L4: 1V8 out; L_6.3x6.3_H3
L5: 5V out; L_7.3x7.3_H4.5
L6: 1V35 out; L_6.3x6.3_H3
L7: VCC2 ph2 out; L_7.3x7.3_H4.5
Q1: BSS138; SOT-23
R200, R210: 10R 1%; R_0402_1005Metric
R201, R202, R205: 21.5k 1%; R_0402_1005Metric
R203: 110k 1%; R_0402_1005Metric
R204: 56.2k 1%; R_0402_1005Metric
R206: 4.64k 1%; R_0402_1005Metric
R207, R215, R219, R221, R225, R229, R233, R252, R257, R301, R302, R303, R305, R309, R310, R311: 10k 1%; R_0402_1005Metric
R208: 866R 1%; R_0402_1005Metric
R209: 0R; R_0402_1005Metric
R211: 17.8k 1%; R_0402_1005Metric
R212, R216, R222, R223, R226, R227, R230, R231: 100k 1%; R_0402_1005Metric
R213, R217, R300: 1.69k 1%; R_0402_1005Metric
R214: 31.6k 1%; R_0402_1005Metric
R218: 52.3k 1%; R_0402_1005Metric
R220, R308: 2.49k 1%; R_0402_1005Metric
R224: 12.4k 1%; R_0402_1005Metric
R228: 6.81k 1%; R_0402_1005Metric
R232: 12.1k 1%; R_0402_1005Metric
R234, R235, R236, R237: 49.9 1%; R_0402_1005Metric
R238, R263: 500R 1%; R_0402_1005Metric
R239, R248, R249, R251, R256: 8.2k 1%; R_0402_1005Metric
R240, R241, R242, R243, R244, R245, R246, R247, R250, R253, R254, R255: 4.7k 1%; R_0402_1005Metric
R258, R259, R260, R264, R313, R314: 1k 1%; R_0402_1005Metric
R261, R262, R304, R306, R312: 4.02k 1%; R_0402_1005Metric
R307: 30.9k 1%; R_0402_1005Metric
R315: 240R 1%; R_0402_1005Metric
R320: 10mR 1% 1W; R_1206_3216Metric
RT1: 10k NTC 1% B3380; R_0402_1005Metric
U2: XC7A100T-2FGG484I; Xilinx_FGG484
U3: MT41K128M16JT-125; FBGA-96_8x14mm_Layout9x16_P0.8mm
U7: LAN8720A-CP-TR; QFN-24-1EP_4x4mm_P0.5mm_EP2.6x2.6mm
U8: W25Q64JVDAIQ (DIP-8, socketed); DIP-8_W7.62mm_Socket
U9: SI5351A-B-GTR; MSOP-10_3x3mm_P0.5mm
U10: TPS546B24ARVFR VCC2; Texas_RVF0040A_LQFN-CLIP-40_5x7mm_P0.5mm
U11: TPS54620RGYR 3V3; Texas_S-PVQFN-N14
U12: TPS62130RGTR 1V0; QFN-16-1EP_3x3mm_P0.5mm_EP1.75x1.75mm
U13: TPS62130RGTR 1V8; QFN-16-1EP_3x3mm_P0.5mm_EP1.75x1.75mm
U14: INA226AIDGSR; MSOP-10_3x3mm_P0.5mm
U15: TPS54620RGYR 5V; Texas_S-PVQFN-N14
U16: TPS62130RGTR 1V35; QFN-16-1EP_3x3mm_P0.5mm_EP1.75x1.75mm
U17: TPS546B24ARVFR VCC2 ph2; Texas_RVF0040A_LQFN-CLIP-40_5x7mm_P0.5mm
XU1: Socket 7 ZIF 321p; Socket7_P55C_296
Y1, Y2: 25MHz; Crystal_SMD_3225-4Pin_3.2x2.5mm

Connections:
+1V0: C115.1, C119.1, C120.1, C123.1, C124.1, C128.1, C129.1, C131.1, C135.1, C137.1, C139.1, C140.1, C143.1, C147.1, C148.1, C149.1, C153.1, C239.1, C240.1, C241.1, L3.2, R220.1, R222.1, U2.H8, U2.H10, U2.J7, U2.J9, U2.J11, U2.K8, U2.L7, U2.L11, U2.M8, U2.N7, U2.N11, U2.P8, U2.P10, U2.R7, U2.R9, U2.T8, U2.T10, U12.14
+1V8: C109.1, C116.1, C126.1, C132.1, C141.1, C144.1, C245.1, C246.1, FB1.1, L4.2, R224.1, R226.1, U2.E12, U2.H12, U2.K12, U2.M12, U2.P12, U2.R11, U13.14
+1V8_ADC: C125.1, C401.1, FB1.2, U2.K10
+1V35: C106.1, C112.1, C118.1, C122.1, C134.1, C136.1, C250.1, C251.1, L6.2, R228.1, R230.1, R313.1, U2.C1, U2.F2, U2.H6, U2.J3, U2.M4, U2.N1, U3.A1, U3.A8, U3.B2, U3.C1, U3.C9, U3.D2, U3.D9, U3.E9, U3.F1, U3.G7, U3.H2, U3.H9, U3.K2, U3.K8, U3.N1, U3.N9, U3.R1, U3.R9, U16.14
+3V3: C100.1, C101.1, C102.1, C103.1, C104.1, C105.1, C107.1, C108.1, C110.1, C111.1, C113.1, C114.1, C117.1, C121.1, C127.1, C130.1, C133.1, C138.1, C142.1, C145.1, C146.1, C150.1, C151.1, C152.1, C154.1, C155.1, C156.1, C157.1, C158.1, C159.1, C160.1, C222.1, C223.1, C224.1, C225.1, C253.1, C257.1, C311.1, C312.1, C313.1, C318.1, C319.1, C320.1, C326.1, C327.1, C331.1, C332.1, C333.1, C337.1, C338.1, C339.1, C343.1, C344.1, C345.1, C349.1, C350.1, C351.1, C355.1, C356.1, C357.1, C361.1, C362.1, C363.1, C410.1, J2.1, J5.2, L2.2, R207.1, R214.1, R239.2, R240.2, R241.2, R242.2, R243.2, R244.2, R245.2, R246.2, R247.2, R248.2, R249.2, R250.2, R251.2, R253.2, R254.2, R255.2, R256.2, R258.2, R261.2, R262.2, R301.2, R305.1, R309.2, R310.2, R311.1, U2.A17, U2.AA7, U2.AA17, U2.AB4, U2.AB14, U2.B14, U2.C21, U2.D18, U2.E15, U2.F12, U2.F22, U2.G19, U2.H16, U2.J13, U2.K20, U2.L17, U2.M14, U2.N21, U2.P18, U2.R5, U2.R15, U2.T2, U2.T12, U2.T22, U2.U8, U2.U19, U2.U22, U2.V6, U2.V16, U2.W3, U2.W13, U2.Y10, U2.Y20, U7.9, U8.8, U9.1, U9.7, U14.6, XU1.A19 (VCC3), XU1.A21 (VCC3), XU1.A23 (VCC3), XU1.A25 (VCC3), XU1.A27 (VCC3), XU1.A29 (VCC3), XU1.AA37 (VCC3), XU1.AC37 (VCC3), XU1.AE37 (VCC3), XU1.AG37 (VCC3), XU1.AN21 (VCC3), XU1.AN23 (VCC3), XU1.AN25 (VCC3), XU1.AN27 (VCC3), XU1.AN29 (VCC3), XU1.E37 (VCC3), XU1.G37 (VCC3), XU1.J37 (VCC3), XU1.L33 (VCC3), XU1.L37 (VCC3), XU1.N37 (VCC3), XU1.Q37 (VCC3), XU1.S37 (VCC3), XU1.T34 (VCC3), XU1.U33 (VCC3), XU1.U37 (VCC3), XU1.W37 (VCC3), XU1.Y37 (VCC3)
+5V: C231.1, C232.1, C233.1, C234.1, C236.1, C237.1, C242.1, C243.1, C247.1, C248.1, L5.2, R218.1, R223.1, R227.1, R231.1, U12.10, U12.11, U12.12, U13.10, U13.11, U13.12, U16.10, U16.11, U16.12
+12V: C203.1, C204.1, C205.1, C214.1, C215.1, C216.1, C218.1, C219.1, C227.1, C228.1, C252.1, J7.2, R200.1, R210.1, R307.1, R320.2, U10.22, U10.23, U10.24, U10.25, U11.4, U11.5, U11.6, U14.8, U14.9, U15.4, U15.5, U15.6, U17.22, U17.23, U17.24, U17.25
+12V_IN: J3.1, R320.1, U14.10
GND: C100.2, C101.2, C102.2, C103.2, C104.2, C105.2, C106.2, C107.2, C108.2, C109.2, C110.2, C111.2, C112.2, C113.2, C114.2, C115.2, C116.2, C117.2, C118.2, C119.2, C120.2, C121.2, C122.2, C123.2, C124.2, C125.2, C126.2, C127.2, C128.2, C129.2, C130.2, C131.2, C132.2, C133.2, C134.2, C135.2, C136.2, C137.2, C138.2, C139.2, C140.2, C141.2, C142.2, C143.2, C144.2, C145.2, C146.2, C147.2, C148.2, C149.2, C150.2, C151.2, C152.2, C153.2, C154.2, C155.2, C156.2, C157.2, C158.2, C159.2, C160.2, C201.2, C203.2, C204.2, C205.2, C206.2, C207.2, C208.2, C209.2, C210.2, C212.2, C214.2, C215.2, C216.2, C217.2, C218.2, C219.2, C221.2, C222.2, C223.2, C224.2, C225.2, C226.2, C227.2, C228.2, C230.2, C231.2, C232.2, C233.2, C234.2, C235.2, C236.2, C237.2, C238.2, C239.2, C240.2, C241.2, C242.2, C243.2, C244.2, C245.2, C246.2, C247.2, C248.2, C249.2, C250.2, C251.2, C252.2, C254.2, C255.2, C256.2, C257.2, C258.2, C259.2, C260.2, C261.2, C262.2, C263.2, C264.2, C300.2, C301.2, C302.2, C303.2, C304.2, C305.2, C306.2, C307.2, C308.2, C309.2, C310.2, C311.2, C312.2, C313.2, C314.2, C315.2, C316.2, C317.2, C318.2, C319.2, C320.2, C321.2, C322.2, C323.2, C324.2, C325.2, C326.2, C327.2, C328.2, C329.2, C330.2, C331.2, C332.2, C333.2, C334.2, C335.2, C336.2, C337.2, C338.2, C339.2, C340.2, C341.2, C342.2, C343.2, C344.2, C345.2, C346.2, C347.2, C348.2, C349.2, C350.2, C351.2, C352.2, C353.2, C354.2, C355.2, C356.2, C357.2, C358.2, C359.2, C360.2, C361.2, C362.2, C363.2, C400.2, C401.2, C403.2, C404.2, C405.2, C406.2, C407.2, C410.2, J1.8, J1.SH, J2.2, J3.2, J4.1, J5.1, J5.3, J5.5, J5.7, J5.9, J5.11, J5.13, J7.1, Q1.2, R202.2, R204.2, R206.2, R209.1, R211.2, R212.2, R215.2, R216.2, R219.2, R221.2, R225.2, R229.2, R232.2, R233.2, R252.2, R257.2, R259.2, R260.2, R263.2, R302.2, R304.2, R306.2, R308.2, R312.2, R314.2, R315.2, RT1.2, U2.A2, U2.A3, U2.A5, U2.A7, U2.A8, U2.A9, U2.A10, U2.A11, U2.A12, U2.A22, U2.AA2, U2.AA12, U2.AA22, U2.AB9, U2.AB19, U2.B3, U2.B5, U2.B7, U2.B8, U2.B9, U2.B10, U2.B11, U2.B12, U2.B19, U2.C3, U2.C4, U2.C6, U2.C8, U2.C9, U2.C10, U2.C11, U2.C12, U2.C16, U2.D3, U2.D4, U2.D6, U2.D8, U2.D9, U2.D10, U2.D11, U2.D12, U2.D13, U2.E4, U2.E5, U2.E7, U2.E8, U2.E9, U2.E11, U2.E20, U2.F5, U2.F7, U2.F8, U2.F9, U2.F11, U2.F17, U2.G5, U2.G6, U2.G7, U2.G8, U2.G9, U2.G10, U2.G12, U2.G13, U2.G14, U2.G16, U2.H1, U2.H7, U2.H9, U2.H11, U2.H14, U2.H21, U2.J8, U2.J10, U2.J12, U2.J18, U2.K5, U2.K7, U2.K9, U2.K11, U2.K15, U2.L2, U2.L8, U2.L9, U2.L10, U2.L21, U2.L22, U2.M7, U2.M9, U2.M10, U2.M11, U2.M19, U2.N6, U2.N8, U2.N16, U2.P3, U2.P7, U2.P9, U2.P11, U2.P13, U2.R8, U2.R10, U2.R12, U2.R20, U2.T7, U2.T9, U2.T11, U2.T17, U2.U4, U2.U14, U2.V1, U2.V11, U2.V21, U2.W8, U2.W18, U2.Y5, U2.Y15, U3.A9, U3.B1, U3.B3, U3.B9, U3.D1, U3.D8, U3.E1, U3.E2, U3.E8, U3.F9, U3.G1, U3.G8, U3.G9, U3.J2, U3.J8, U3.M1, U3.M9, U3.P1, U3.P9, U3.T1, U3.T9, U7.25, U8.4, U9.8, U10.6, U10.13, U10.14, U10.15, U10.16, U10.17, U10.18, U10.19, U10.20, U10.21, U10.36, U10.37, U10.41, U11.2, U11.3, U11.15, U12.6, U12.15, U12.16, U12.17, U13.6, U13.15, U13.16, U13.17, U14.1, U14.2, U14.7, U15.2, U15.3, U15.15, U16.6, U16.15, U16.16, U16.17, U17.1, U17.2, U17.3, U17.6, U17.13, U17.14, U17.15, U17.16, U17.17, U17.18, U17.19, U17.20, U17.21, U17.30, U17.31, U17.32, U17.36, U17.37, U17.41, XU1.AB02 (VSS), XU1.AB04 (HOLD), XU1.AB36 (VSS), XU1.AD02 (VSS), XU1.AD36 (VSS), XU1.AF02 (VSS), XU1.AF36 (VSS), XU1.AH02 (VSS), XU1.AJ37 (VSS), XU1.AL37 (VSS), XU1.AM08 (VSS), XU1.AM10 (VSS), XU1.AM12 (VSS), XU1.AM14 (VSS), XU1.AM16 (VSS), XU1.AM18 (VSS), XU1.AM20 (VSS), XU1.AM22 (VSS), XU1.AM24 (VSS), XU1.AM26 (VSS), XU1.AM28 (VSS), XU1.AM30 (VSS), XU1.AN37 (VSS), XU1.B06 (VSS), XU1.B08 (VSS), XU1.B10 (VSS), XU1.B12 (VSS), XU1.B14 (VSS), XU1.B16 (VSS), XU1.B18 (VSS), XU1.B20 (VSS), XU1.B22 (VSS), XU1.B24 (VSS), XU1.B26 (VSS), XU1.B28 (VSS), XU1.H02 (VSS), XU1.H36 (VSS), XU1.K02 (VSS), XU1.K36 (VSS), XU1.M02 (VSS), XU1.M36 (VSS), XU1.P02 (VSS), XU1.P36 (VSS), XU1.R02 (VSS), XU1.R36 (VSS), XU1.T02 (VSS), XU1.T36 (VSS), XU1.U35 (VSS), XU1.V02 (VSS), XU1.V36 (VSS), XU1.W03 (EWBE#), XU1.X02 (VSS), XU1.X36 (VSS), XU1.Z02 (VSS), XU1.Z36 (VSS), Y1.2, Y1.4, Y2.2, Y2.4
VCC2: C207.1, C208.1, C209.1, C210.1, C300.1, C301.1, C302.1, C303.1, C304.1, C305.1, C306.1, C307.1, C308.1, C309.1, C310.1, C314.1, C315.1, C316.1, C317.1, C321.1, C322.1, C323.1, C324.1, C325.1, C328.1, C329.1, C330.1, C334.1, C335.1, C336.1, C340.1, C341.1, C342.1, C346.1, C347.1, C348.1, C352.1, C353.1, C354.1, C358.1, C359.1, C360.1, L1.2, L7.2, R208.1, R303.1, XU1.A07 (VCC2), XU1.A09 (VCC2), XU1.A11 (VCC2), XU1.A13 (VCC2), XU1.A15 (VCC2), XU1.A17 (VCC2), XU1.AA01 (VCC2), XU1.AC01 (VCC2), XU1.AE01 (VCC2), XU1.AG01 (VCC2), XU1.AN09 (VCC2), XU1.AN11 (VCC2), XU1.AN13 (VCC2), XU1.AN15 (VCC2), XU1.AN17 (VCC2), XU1.AN19 (VCC2), XU1.G01 (VCC2), XU1.J01 (VCC2), XU1.L01 (VCC2), XU1.N01 (VCC2), XU1.Q01 (VCC2), XU1.S01 (VCC2), XU1.U01 (VCC2), XU1.W01 (VCC2), XU1.Y01 (VCC2)
cpu_a20m_n: U2.U6, XU1.AK08 (A20M#)
cpu_a[3]: U2.W19, XU1.AL35 (A3)
cpu_a[4]: U2.Y18, XU1.AM34 (A4)
cpu_a[5]: U2.T16, XU1.AK32 (A5)
cpu_a[6]: U2.AB17, XU1.AN33 (A6)
cpu_a[7]: U2.Y17, XU1.AL33 (A7)
cpu_a[8]: U2.U16, XU1.AM32 (A8)
cpu_a[9]: U2.T15, XU1.AK30 (A9)
cpu_a[10]: U2.AA16, XU1.AN31 (A10)
cpu_a[11]: U2.Y16, XU1.AL31 (A11)
cpu_a[12]: U2.V15, XU1.AL29 (A12)
cpu_a[13]: U2.AA15, XU1.AK28 (A13)
cpu_a[14]: U2.V14, XU1.AL27 (A14)
cpu_a[15]: U2.W14, XU1.AK26 (A15)
cpu_a[16]: U2.AA14, XU1.AL25 (A16)
cpu_a[17]: U2.Y13, XU1.AK24 (A17)
cpu_a[18]: U2.AB13, XU1.AL23 (A18)
cpu_a[19]: U2.Y12, XU1.AK22 (A19)
cpu_a[20]: U2.W11, XU1.AL21 (A20)
cpu_a[21]: U2.T18, XU1.AF34 (A21)
cpu_a[22]: U2.AA21, XU1.AH36 (A22)
cpu_a[23]: U2.U17, XU1.AE33 (A23)
cpu_a[24]: U2.AA20, XU1.AG35 (A24)
cpu_a[25]: U2.AB20, XU1.AJ35 (A25)
cpu_a[26]: U2.U18, XU1.AH34 (A26)
cpu_a[27]: U2.V17, XU1.AG33 (A27)
cpu_a[28]: U2.AB21, XU1.AK36 (A28)
cpu_a[29]: U2.V18, XU1.AK34 (A29)
cpu_a[30]: U2.AB11, XU1.AM36 (A30)
cpu_a[31]: U2.W17, XU1.AJ33 (A31)
cpu_ads_n: U2.AB12, XU1.AJ05 (ADS#)
cpu_ahold: U2.Y3, XU1.V04 (AHOLD)
cpu_ap: R239.1, XU1.AK02 (AP)
cpu_be[0]: U2.AA3, XU1.AL09 (BE0#)
cpu_be[1]: U2.Y7, XU1.AK10 (BE1#)
cpu_be[2]: U2.U7, XU1.AL11 (BE2#)
cpu_be[3]: U2.V4, XU1.AK12 (BE3#)
cpu_be[4]: U2.V8, XU1.AL13 (BE4#)
cpu_be[5]: U2.Y19, XU1.AK14 (BE5#)
cpu_be[6]: U2.V9, XU1.AL15 (BE6#)
cpu_be[7]: U2.AA10, XU1.AK16 (BE7#)
cpu_bf[0]: U2.AB18, XU1.Y33 ([BF0])
cpu_bf[1]: U2.V19, XU1.X34 ([BF1])
cpu_boff_n: U2.R2, XU1.Z04 (BOFF#)
cpu_brdy_n: U2.R6, XU1.X04 (BRDY#)
cpu_cache_n: U2.Y1, XU1.U03 (CACHE#)
cpu_clk: U9.10, XU1.AK18 (CLK)
cpu_d[0]: U2.W20, XU1.K34 (D0)
cpu_d[1]: U2.R18, XU1.G35 (D1)
cpu_d[2]: U2.Y21, XU1.J35 (D2)
cpu_d[3]: U2.AA19, XU1.G33 (D3)
cpu_d[4]: U2.W22, XU1.F36 (D4)
cpu_d[5]: U2.V20, XU1.F34 (D5)
cpu_d[6]: U2.U21, XU1.E35 (D6)
cpu_d[7]: U2.R16, XU1.E33 (D7)
cpu_d[8]: U2.U20, XU1.D34 (D8)
cpu_d[9]: U2.N22, XU1.C37 (D9)
cpu_d[10]: U2.T21, XU1.C35 (D10)
cpu_d[11]: U2.V22, XU1.B36 (D11)
cpu_d[12]: U2.N17, XU1.D32 (D12)
cpu_d[13]: U2.T20, XU1.B34 (D13)
cpu_d[14]: U2.P19, XU1.C33 (D14)
cpu_d[15]: U2.Y22, XU1.A35 (D15)
cpu_d[16]: U2.AA18, XU1.B32 (D16)
cpu_d[17]: U2.Y9, XU1.C31 (D17)
cpu_d[18]: U2.R19, XU1.A33 (D18)
cpu_d[19]: U2.U15, XU1.D28 (D19)
cpu_d[20]: U2.W16, XU1.B30 (D20)
cpu_d[21]: U2.AB16, XU1.C29 (D21)
cpu_d[22]: U2.P16, XU1.A31 (D22)
cpu_d[23]: U2.AB15, XU1.D26 (D23)
cpu_d[24]: U2.W15, XU1.C27 (D24)
cpu_d[25]: U2.V13, XU1.C23 (D25)
cpu_d[26]: U2.Y14, XU1.D24 (D26)
cpu_d[27]: U2.W12, XU1.C21 (D27)
cpu_d[28]: U2.AA13, XU1.D22 (D28)
cpu_d[29]: U2.Y11, XU1.C19 (D29)
cpu_d[30]: U2.T3, XU1.D20 (D30)
cpu_d[31]: U2.P20, XU1.C17 (D31)
cpu_d[32]: U2.W10, XU1.C15 (D32)
cpu_d[33]: U2.V10, XU1.D16 (D33)
cpu_d[34]: U2.W9, XU1.C13 (D34)
cpu_d[35]: U2.AB10, XU1.D14 (D35)
cpu_d[36]: U2.Y8, XU1.C11 (D36)
cpu_d[37]: U2.AA9, XU1.D12 (D37)
cpu_d[38]: U2.V7, XU1.C09 (D38)
cpu_d[39]: U2.AB8, XU1.D10 (D39)
cpu_d[40]: U2.AB7, XU1.D08 (D40)
cpu_d[41]: U2.T1, XU1.A05 (D41)
cpu_d[42]: U2.W7, XU1.E09 (D42)
cpu_d[43]: U2.R17, XU1.B04 (D43)
cpu_d[44]: U2.W6, XU1.D06 (D44)
cpu_d[45]: U2.AA6, XU1.C05 (D45)
cpu_d[46]: U2.T6, XU1.E07 (D46)
cpu_d[47]: U2.AB3, XU1.C03 (D47)
cpu_d[48]: U2.T4, XU1.D04 (D48)
cpu_d[49]: U2.AB6, XU1.E05 (D49)
cpu_d[50]: U2.AA1, XU1.D02 (D50)
cpu_d[51]: U2.W4, XU1.F04 (D51)
cpu_d[52]: U2.U2, XU1.E03 (D52)
cpu_d[53]: U2.T5, XU1.G05 (D53)
cpu_d[54]: U2.AB1, XU1.E01 (D54)
cpu_d[55]: U2.V2, XU1.G03 (D55)
cpu_d[56]: U2.Y4, XU1.H04 (D56)
cpu_d[57]: U2.W2, XU1.J03 (D57)
cpu_d[58]: U2.U5, XU1.J05 (D58)
cpu_d[59]: U2.AA4, XU1.K04 (D59)
cpu_d[60]: U2.U3, XU1.L05 (D60)
cpu_d[61]: U2.Y2, XU1.L03 (D61)
cpu_d[62]: U2.R3, XU1.M04 (D62)
cpu_d[63]: U2.Y6, XU1.N03 (D63)
cpu_dc_n: U2.U1, XU1.AK04 (D/C#)
cpu_dp[0]: R240.1, XU1.D36 (DP0)
cpu_dp[1]: R241.1, XU1.D30 (DP1)
cpu_dp[2]: R242.1, XU1.C25 (DP2)
cpu_dp[3]: R243.1, XU1.D18 (DP3)
cpu_dp[4]: R244.1, XU1.C07 (DP4)
cpu_dp[5]: R245.1, XU1.F06 (DP5)
cpu_dp[6]: R246.1, XU1.F02 (DP6)
cpu_dp[7]: R247.1, XU1.N05 (DP7)
cpu_eads_n: U2.W1, XU1.AM04 (EADS#)
cpu_flush_n: R248.1, XU1.AN07 (FLUSH#)
cpu_frcmc_n: R249.1, XU1.Y35 (FRCMC#1)
cpu_hitm_n: U2.V5, XU1.AL05 (HITM#)
cpu_ignne_n: R250.1, XU1.AA35 (IGNNE#)
cpu_init: U2.P17, XU1.AA33 (INIT)
cpu_intr: U2.W21, XU1.AD34 (INTR/LINT0)
cpu_ken_inv_n: U2.AA5, XU1.U05 (INV), XU1.W05 (KEN#)
cpu_lock_n: U2.AB2, XU1.AH04 (LOCK#)
cpu_mio_n: U2.V3, XU1.T04 (M/IO#)
cpu_na_n: U2.R4, XU1.Y05 (NA#)
cpu_nmi: U2.AB5, XU1.AC33 (NMI/LINT1)
cpu_pen_n: R251.1, XU1.Z34 (PEN#)
cpu_picd1: R252.1, XU1.L35 (PICD1)
cpu_reset: R256.1, U2.AA11, XU1.AK20 (RESET)
cpu_smi_n: R253.1, XU1.AB34 (SMI#)
cpu_smiact_n: R254.1, XU1.AG03 (SMIACT#)
cpu_stpclk_n: R255.1, U2.T14, XU1.V34 (STPCLK#)
cpu_tck: J6.1, XU1.M34 (TCK)
cpu_tdi: J6.3, XU1.N35 (TDI)
cpu_tdo: J6.4, XU1.N33 (TDO)
cpu_tms: J6.2, XU1.P34 (TMS)
cpu_trst_n: J6.5, R257.1, XU1.Q33 (TRST#)
cpu_wbwt_n: U2.AA8, XU1.AA05 (WB/WT#)
cpu_wr_n: U2.W5, XU1.AM06 (W/R#)
ddr3_a[0]: U2.M2, U3.N3
ddr3_a[1]: U2.M5, U3.P7
ddr3_a[2]: U2.M3, U3.P3
ddr3_a[3]: U2.M1, U3.N2
ddr3_a[4]: U2.L6, U3.P8
ddr3_a[5]: U2.P1, U3.P2
ddr3_a[6]: U2.N3, U3.R8
ddr3_a[7]: U2.N2, U3.R2
ddr3_a[8]: U2.M6, U3.T8
ddr3_a[9]: U2.R1, U3.R3
ddr3_a[10]: U2.L5, U3.L7
ddr3_a[11]: U2.N5, U3.R7
ddr3_a[12]: U2.N4, U3.N7
ddr3_a[13]: U2.P2, U3.T3
ddr3_a[14]: U2.P6, U3.T7
ddr3_ba[0]: U2.L3, U3.M2
ddr3_ba[1]: U2.K6, U3.N8
ddr3_ba[2]: U2.L4, U3.M3
ddr3_cas_n: U2.K3, U3.K3
ddr3_ck_n: U2.P4, U3.K7
ddr3_ck_p: U2.P5, U3.J7
ddr3_cke: U2.J6, U3.K9
ddr3_cs_n: U2.F4, U3.L2
ddr3_dm[0]: U2.G3, U3.E7
ddr3_dm[1]: U2.F1, U3.D3
ddr3_dq[0]: U2.G2, U3.E3
ddr3_dq[1]: U2.H4, U3.F7
ddr3_dq[2]: U2.H5, U3.F2
ddr3_dq[3]: U2.J1, U3.F8
ddr3_dq[4]: U2.K1, U3.H3
ddr3_dq[5]: U2.H3, U3.H8
ddr3_dq[6]: U2.H2, U3.G2
ddr3_dq[7]: U2.J5, U3.H7
ddr3_dq[8]: U2.E3, U3.D7
ddr3_dq[9]: U2.B2, U3.C3
ddr3_dq[10]: U2.F3, U3.C8
ddr3_dq[11]: U2.D2, U3.C2
ddr3_dq[12]: U2.C2, U3.A7
ddr3_dq[13]: U2.A1, U3.A2
ddr3_dq[14]: U2.E2, U3.B8
ddr3_dq[15]: U2.B1, U3.A3
ddr3_dqs_n[0]: U2.J2, U3.G3
ddr3_dqs_n[1]: U2.D1, U3.B7
ddr3_dqs_p[0]: U2.K2, U3.F3
ddr3_dqs_p[1]: U2.E1, U3.C7
ddr3_odt: U2.K4, U3.K1
ddr3_ras_n: U2.J4, U3.J3
ddr3_reset_n: U2.G1, U3.T2
ddr3_vref: C407.1, R313.2, R314.1, U3.H1, U3.M8
ddr3_we_n: U2.L1, U3.L3
ddr3_zq: R315.1, U3.L8
en_vcc2: R263.1, U2.AB22, U10.27, U17.27
eth_mdc: U2.A19, U7.13
eth_mdi_rxn: J1.6, R237.1, U7.22
eth_mdi_rxp: J1.3, R236.1, U7.23
eth_mdi_txn: J1.2, R235.1, U7.20
eth_mdi_txp: J1.1, R234.1, U7.21
eth_mdio: U2.B22, U7.12
eth_nintsel: R233.1, U7.2
eth_rbias: R232.1, U7.24
eth_ref_clk: U2.C18, U7.14
eth_rmii_crs_dv: U2.A21, U7.11
eth_rmii_rx_er: U2.B21, U7.10
eth_rmii_rxd[0]: U2.A20, U7.8
eth_rmii_rxd[1]: U2.E22, U7.7
eth_rmii_tx_en: U2.A15, U7.16
eth_rmii_txd[0]: U2.A14, U7.17
eth_rmii_txd[1]: U2.A13, U7.18
eth_rst_n: U2.A16, U7.15
eth_vdda: C253.2, C254.1, C255.1, C256.1, C260.1, J1.4, J1.5, R234.2, R235.2, R236.2, R237.2, U7.1, U7.19
eth_vddcr: C258.1, C259.1, U7.6
eth_xtal1: C261.1, U7.5, Y1.1
eth_xtal2: C262.1, R238.1, Y1.3
eth_xtal2_drv: R238.2, U7.4
fan_pwm: J7.4, Q1.3
fan_pwm_g: Q1.1, R302.1, U2.G17
fan_tach: J7.3, R300.1, R301.1
fan_tach_f: C400.1, R300.2, U2.G18
fpga_init_b: R262.1, U2.U12
fpga_m0: R258.1, U2.U11
fpga_m1: R259.1, U2.U10
fpga_m2: R260.1, U2.U9
fpga_program_b: R261.1, U2.N12
fpga_refclk: U2.K18, U9.9
i2c_scl: R309.1, U2.H18, U9.4, U10.3, U14.5
i2c_sda: R310.1, U2.G20, U9.5, U10.2, U14.4
jtag_tck: J5.6, U2.V12
jtag_tdi: J5.10, U2.R13
jtag_tdo: J5.8, U2.U13
jtag_tms: J5.4, U2.T13
spi_clk: J2.4, U2.L12, U8.6
spi_cs_n: J2.3, U2.T19, U8.1
spi_dq0: J2.6, U2.P22, U8.5
spi_dq1: J2.5, U2.R22, U8.2
spi_dq2: U2.P21, U8.3
spi_dq3: U2.R21, U8.7
sw_1v0: L3.1, U12.1, U12.2, U12.3
sw_1v8: L4.1, U13.1, U13.2, U13.3
sw_1v35: L6.1, U16.1, U16.2, U16.3
sw_3v3: C220.2, L2.1, U11.11, U11.12
sw_5v: C229.2, L5.1, U15.11, U15.12
sw_vcc2: C202.2, L1.1, U10.8, U10.9, U10.10, U10.11, U10.12
sw_vcc2_b: C213.2, L7.1, U17.8, U17.9, U17.10, U17.11, U17.12
tsen_socket: C406.1, R311.2, R312.1, RT1.1, U2.G15
u9_xa: C263.1, U9.2, Y2.1
u9_xb: C264.1, U9.3, Y2.3
u10_avin: C206.1, R200.2, U10.26
u10_boot: C202.1, U10.7
u10_bp1v5: C200.1, R201.1, R203.1, R205.1, U10.4
u10_drtn: C200.2, U10.5
u10_msel1: R201.2, R202.1, U10.32
u10_msel2: R203.2, R204.1, U10.29
u10_pgood: R207.2, U10.1
u10_vdd5: C201.1, U10.28
u10_vsel: R205.2, R206.1, U10.30
u11_boot: C220.1, U11.13
u11_comp: R213.1, U11.8
u11_compz: C226.1, R213.2
u11_fb: R214.2, R215.1, U11.7
u11_rt: R212.1, U11.1
u11_ss: C221.1, U11.9
u12_en: R223.2, U12.13
u12_fb: R220.2, R221.1, U12.5
u12_pg: R222.2, U12.4
u12_ss: C238.1, U12.9
u13_en: R227.2, U13.13
u13_fb: R224.2, R225.1, U13.5
u13_pg: R226.2, U13.4
u13_ss: C244.1, U13.9
u15_boot: C229.1, U15.13
u15_comp: R217.1, U15.8
u15_compz: C235.1, R217.2
u15_fb: R218.2, R219.1, U15.7
u15_rt: R216.1, U15.1
u15_ss: C230.1, U15.9
u16_en: R231.2, U16.13
u16_fb: R228.2, R229.1, U16.5
u16_pg: R230.2, U16.4
u16_ss: C249.1, U16.9
u17_avin: C217.1, R210.2, U17.26
u17_boot: C213.1, U17.7
u17_bp1v5: C211.1, U17.4, U17.34
u17_drtn: C211.2, U17.5
u17_msel2: R211.1, U17.29
u17_vdd5: C212.1, U17.28
uart_rx: J4.2, U2.H19
uart_tx: J4.3, U2.H20
vcc2_bcx_clk: U10.39, U17.39
vcc2_bcx_dat: U10.40, U17.40
vcc2_gsense: R209.2, R264.2, U10.34
vcc2_sense: R208.2, R264.1, U10.33
vcc2_sync: U10.38, U17.38
vcc2_vshare: U10.35, U17.35
vsen_3v3: C404.1, R305.2, R306.1, U2.J14
vsen_12v: C405.1, R307.2, R308.1, U2.M21
vsen_vcc2: C403.1, R303.2, R304.1, U2.H13
