alphaonex86/FPGAmotherboard/socket370/fpga-xc7a100t/socket370-motherboard.kicad_pcb

## KiCad design socket370/fpga-xc7a100t/socket370-motherboard.kicad_pcb (2026-10-29)

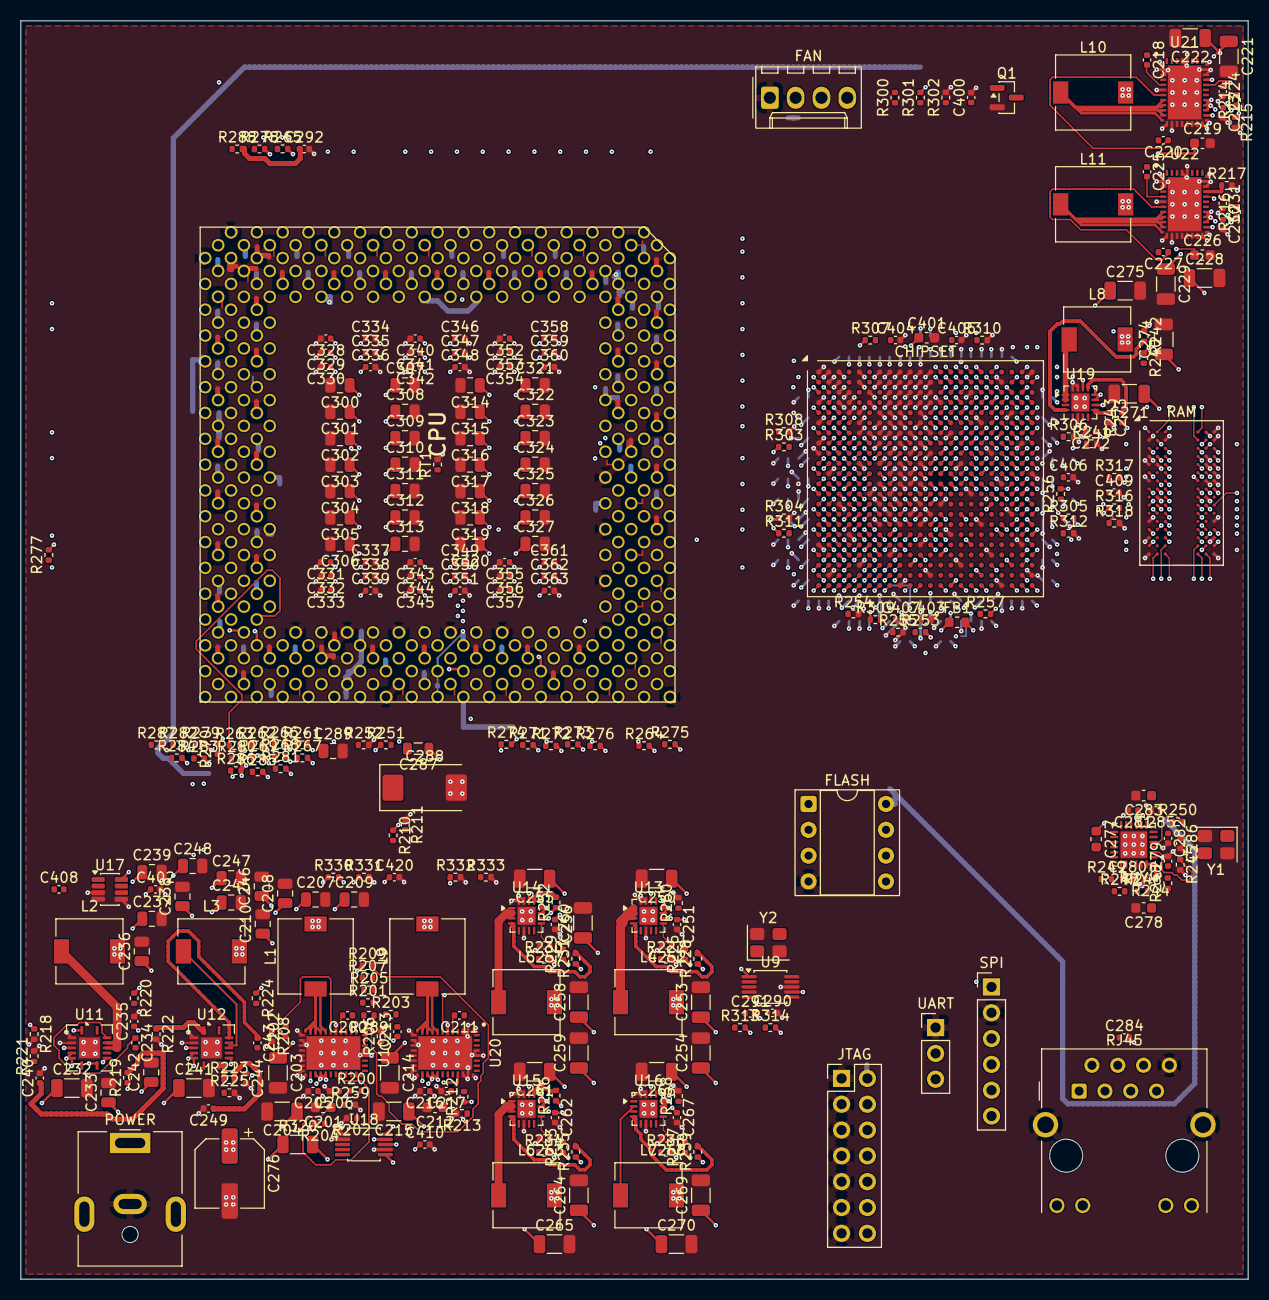
[picture p16: board socket370-motherboard.kicad_pcb from above]

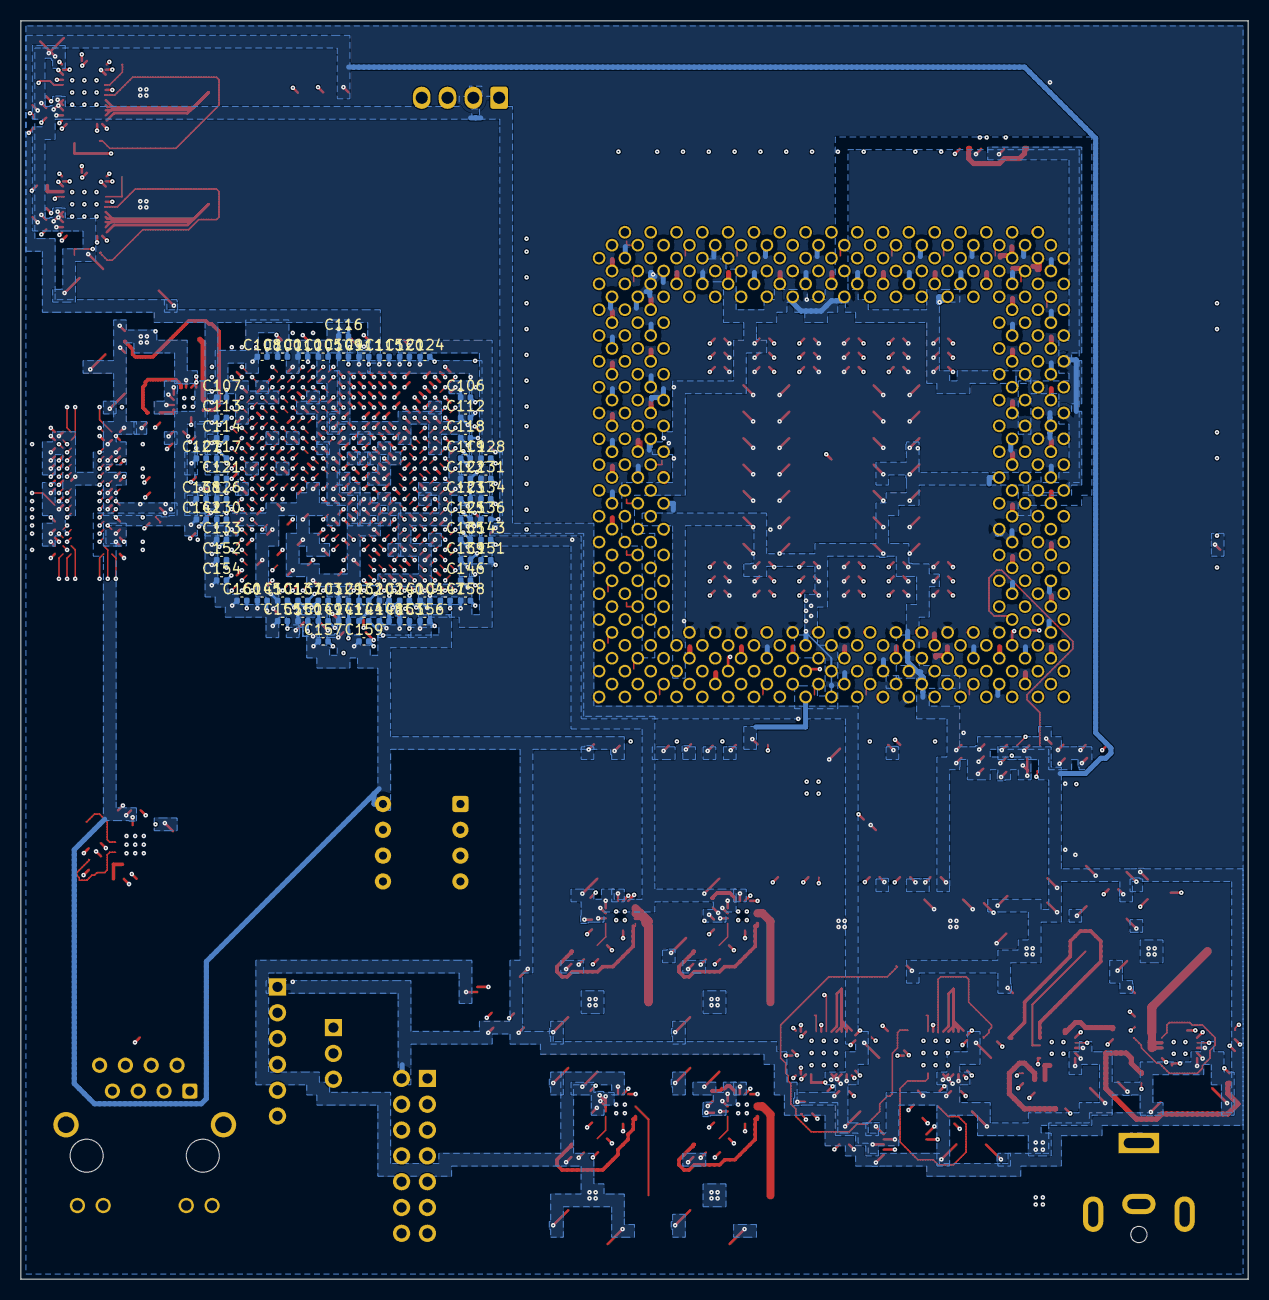
[picture p17: board socket370-motherboard.kicad_pcb from below]

Board: 8 copper layers, 120.8 x 123.8 mm, 384 parts (61 on the bottom side), 348 nets.

Parts:
C100, C101, C102, C103, C104, C105, C106, C107, C108, C109, C110, C111, C112, C113, C114, C115, C116, C117, C118, C119, C120, C121, C122, C123, C124, C125, C126, C127, C128, C129, C130, C131, C132, C133, C134, C135, C136, C137, C138, C139, C140, C141, C142, C143, C144, C145, C146, C147, C148, C149, C150, C151, C152, C153, C154, C155, C156, C157, C158, C159, C160: 470nF; C_0402_1005Metric
C200, C211, C218, C225: 1uF 16V X6S; C_0402_1005Metric
C201, C212, C219, C226: 4.7uF 16V X5R; C_0603_1608Metric
C202, C213, C220, C227: 100nF 16V X5R; C_0402_1005Metric
C203, C204, C214, C215, C221, C222, C228, C229, C232, C241, C250, C253, C254, C255, C258, C259, C260, C261, C264, C265, C266, C269, C270, C271, C274, C275: 22uF 25V X5R; C_1206_3216Metric
C205, C216, C223, C230, C235, C244, C403, C404, C405, C406, C407: 10nF 50V X7R; C_0402_1005Metric
C206, C217, C224, C231: 1uF 25V X5R; C_0402_1005Metric
C207, C208, C209, C210, C245, C246, C247, C248: 47uF 6.3V X5R; C_0805_2012Metric
C233, C242: 4.7uF 25V X7R; C_0805_2012Metric
C234, C243, C251, C256, C262, C267, C272, C279, C280, C281, C284, C402, C409, C410, C420: 100nF 16V X7R; C_0402_1005Metric
C236, C237, C238, C239: 47uF 10V X5R; C_0805_2012Metric
C240, C249: 8.2nF 50V X7R; C_0402_1005Metric
C252, C257, C263, C268, C273: 3.3nF 50V X7R; C_0402_1005Metric
C276: 100uF 25V; CP_Elec_6.3x7.7
C277: 600R@100MHz bead; L_0603_1608Metric
C278: 10uF 10V X5R; C_0603_1608Metric
C282: 470pF 50V C0G; C_0402_1005Metric
C283: 1uF 16V X7R; C_0603_1608Metric
C285, C286: 15pF 50V C0G; C_0402_1005Metric
C287: 4.7uH 30mA shielded; L_0805_2012Metric
C288: 33uF 20V tantalum; CP_EIA-7343-31_Kemet-D
C289: 4.7uF 16V X7R; C_0805_2012Metric
C290, C291: 4pF 50V C0G; C_0402_1005Metric
C292: 10pF 50V C0G; C_0402_1005Metric
C300, C301, C302, C303, C304, C305, C306, C307, C308, C309, C310, C311, C312, C313, C314, C315, C316, C317, C318, C319, C320, C321, C322, C323, C324, C325, C326, C327: 22uF; C_0805_2012Metric
C328, C329, C330, C331, C332, C333, C334, C335, C336, C337, C338, C339, C340, C341, C342, C343, C344, C345, C346, C347, C348, C349, C350, C351, C352, C353, C354, C355, C356, C357, C358, C359, C360, C361, C362, C363: 100nF; C_0402_1005Metric
C400: 1nF 50V C0G; C_0402_1005Metric
C401: 470nF 50V X7R; C_0603_1608Metric
C408: 100pF 50V C0G; C_0402_1005Metric
FB1: 600R@100MHz bead; L_0603_1608Metric
J1: HR911105A; RJ45_Hanrun_HR911105A_Horizontal
J2: PJ-063AH; BarrelJack_CUI_PJ-063AH_Horizontal
J3: JTAG; PinHeader_2x07_P2.54mm_Vertical
J4: UART; PinHeader_1x03_P2.54mm_Vertical
J5: SPI ISP; PinHeader_1x06_P2.54mm_Vertical
J6: fan 4-pin 1GND 2+12V 3TACH 4PWM; Molex_KK-254_AE-6410-04A_1x04_P2.54mm_Vertical
L1: VCORE ph1; L_7.3x7.3_H4.5
L2: 5V 6A; L_6.3x6.3_H3
L3: 3V3; L_6.3x6.3_H3
L4: VTT1V5; L_6.3x6.3_H3
L5: VCCINT1V0; L_6.3x6.3_H3
L6: VCCIO1V8; L_6.3x6.3_H3
L7: VCC2V5; L_6.3x6.3_H3
L8: 1V35 out; L_6.3x6.3_H3
L9: VCORE ph2; L_7.3x7.3_H4.5
L10: VCORE ph3; L_7.3x7.3_H4.5
L11: VCORE ph4; L_7.3x7.3_H4.5
Q1: BSS138; SOT-23
R200, R212, R214, R216: 10R 1%; R_0402_1005Metric
R201, R202: 17.8k 1%; R_0402_1005Metric
R203: 162k 1%; R_0402_1005Metric
R204, R215: 82.5k 1%; R_0402_1005Metric
R205, R237: 21.5k 1%; R_0402_1005Metric
R206, R208: 4.64k 1%; R_0402_1005Metric
R207: 1.27k 1%; R_0402_1005Metric
R209, R221, R225, R227, R230, R234, R238, R241, R245, R264, R301, R302, R305, R309, R313, R314: 10k 1%; R_0402_1005Metric
R210: 140R 1%; R_0402_1005Metric
R211: 0R; R_0402_1005Metric
R213: 8.25k 1%; R_0402_1005Metric
R217: 38.3k 1%; R_0402_1005Metric
R218, R222, R228, R231, R232, R235, R236, R239, R242, R243: 100k 1%; R_0402_1005Metric
R219, R223, R300: 1.69k 1%; R_0402_1005Metric
R220: 52.3k 1%; R_0402_1005Metric
R224: 31.6k 1%; R_0402_1005Metric
R226: 8.66k 1%; R_0402_1005Metric
R229, R308, R312: 2.49k 1%; R_0402_1005Metric
R233, R307: 12.4k 1%; R_0402_1005Metric
R240: 6.81k 1%; R_0402_1005Metric
R244: 12.1k 1%; R_0402_1005Metric
R246, R247, R248, R249: 49.9 1%; R_0402_1005Metric
R250, R258, R259, R260: 500R 1%; R_0402_1005Metric
R251, R252, R261, R266, R267, R268, R269, R270, R271, R272, R273, R274, R275, R279, R280, R281, R284, R285, R331: 150R 1%; R_0402_1005Metric
R253, R254, R255, R262, R263, R282, R286, R289, R316, R317: 1k 1%; R_0402_1005Metric
R256, R257, R303, R304, R306, R310: 4.02k 1%; R_0402_1005Metric
R265: 51R 1%; R_0402_1005Metric
R276, R283, R318: 240R 1%; R_0402_1005Metric
R277: 330R 1%; R_0402_1005Metric
R278: 91R 1%; R_0402_1005Metric
R287: 680R 1%; R_0402_1005Metric
R288: 22R 1%; R_0402_1005Metric
R311: 30.9k 1%; R_0402_1005Metric
R320: 10mR 1% 1W; R_1206_3216Metric
R330: 75R 1%; R_0402_1005Metric
R332, R333: 110R 1%; R_0402_1005Metric
RT1: 10k NTC 1% B3380; R_0402_1005Metric
U2: XC7A100T-2FGG484I; Xilinx_FGG484
U3: MT41K128M16JT-125; FBGA-96_8x14mm_Layout9x16_P0.8mm
U7: W25Q64JVDAIQ (DIP-8, socketed); DIP-8_W7.62mm_Socket
U8: LAN8720A-CP-TR; QFN-24-1EP_4x4mm_P0.5mm_EP2.6x2.6mm
U9: SI5351A-B-GTR; MSOP-10_3x3mm_P0.5mm
U10, U20, U21, U22: TPS546B24ARVFR; Texas_RVF0040A_LQFN-CLIP-40_5x7mm_P0.5mm
U11, U12: TPS54620RGYR; Texas_S-PVQFN-N14
U13, U14, U15, U16: TPS62130RGTR; QFN-16-1EP_3x3mm_P0.5mm_EP1.75x1.75mm
U17: TMP421AIDCNR; SOT-23-8
U18: INA226AIDGSR; MSOP-10_3x3mm_P0.5mm
U19: TPS62130RGTR 1V35; QFN-16-1EP_3x3mm_P0.5mm_EP1.75x1.75mm
XU1: PGA370 ZIF; PGA370_Socket_ZIF
Y1, Y2: 25MHz; Crystal_SMD_3225-4Pin_3.2x2.5mm

Connections:
+1V0: C115.1, C119.1, C120.1, C123.1, C124.1, C128.1, C129.1, C131.1, C135.1, C137.1, C139.1, C140.1, C143.1, C147.1, C148.1, C149.1, C153.1, C258.1, C259.1, C260.1, L5.2, R229.1, R231.1, U2.H8, U2.H10, U2.J7, U2.J9, U2.J11, U2.K8, U2.L7, U2.L11, U2.M8, U2.N7, U2.N11, U2.P8, U2.P10, U2.R7, U2.R9, U2.T8, U2.T10, U14.14
+1V8: C100.1, C102.1, C104.1, C105.1, C106.1, C107.1, C108.1, C109.1, C110.1, C112.1, C113.1, C116.1, C118.1, C122.1, C126.1, C132.1, C134.1, C136.1, C141.1, C144.1, C146.1, C151.1, C156.1, C158.1, C264.1, C265.1, FB1.1, L6.2, R233.1, R235.1, U2.A17, U2.AA7, U2.AB4, U2.B14, U2.C1, U2.C21, U2.D18, U2.E12, U2.E15, U2.F2, U2.F22, U2.H6, U2.H12, U2.J3, U2.K12, U2.M4, U2.M12, U2.N1, U2.P12, U2.R5, U2.R11, U2.T2, U2.V6, U2.W3, U15.14
+1V8_ADC: C125.1, C401.1, FB1.2, U2.K10
+1V35: C114.1, C117.1, C121.1, C127.1, C130.1, C138.1, C274.1, C275.1, L8.2, R240.1, R242.1, R316.1, U2.G19, U2.H16, U2.J13, U2.K20, U2.L17, U2.N21, U3.A1, U3.A8, U3.B2, U3.C1, U3.C9, U3.D2, U3.D9, U3.E9, U3.F1, U3.G7, U3.H2, U3.H9, U3.K2, U3.K8, U3.N1, U3.N9, U3.R1, U3.R9, U19.14
+2V5: C269.1, C270.1, L7.2, R237.1, R239.1, R251.1, R277.2, U9.7, U16.14, XU1.Z36 (VCC2.5)
+3V3: C101.1, C103.1, C111.1, C133.1, C142.1, C145.1, C150.1, C152.1, C154.1, C155.1, C157.1, C159.1, C160.1, C245.1, C246.1, C247.1, C248.1, C277.1, C281.1, C402.1, C410.1, J3.2, J5.1, L3.2, R209.1, R224.1, R253.2, R256.2, R257.2, R262.2, R263.2, R264.2, R301.2, R305.1, R309.1, R313.2, R314.2, U2.AA17, U2.AB14, U2.F12, U2.M14, U2.P18, U2.R15, U2.T12, U2.T22, U2.U8, U2.U19, U2.U22, U2.V16, U2.W13, U2.Y10, U2.Y20, U7.8, U8.9, U9.1, U17.8, U18.6
+5V: C236.1, C237.1, C238.1, C239.1, C250.1, C251.1, C255.1, C256.1, C261.1, C262.1, C266.1, C267.1, C271.1, C272.1, L2.2, R220.1, R232.1, R236.1, R243.1, R307.1, U13.10, U13.11, U13.12, U14.10, U14.11, U14.12, U15.10, U15.11, U15.12, U16.10, U16.11, U16.12, U19.10, U19.11, U19.12
+12V: C203.1, C204.1, C205.1, C214.1, C215.1, C216.1, C221.1, C222.1, C223.1, C228.1, C229.1, C230.1, C232.1, C233.1, C241.1, C242.1, C276.1, J6.2, R200.1, R212.1, R214.1, R216.1, R311.1, R320.2, U10.22, U10.23, U10.24, U10.25, U11.4, U11.5, U11.6, U12.4, U12.5, U12.6, U18.8, U18.9, U20.22, U20.23, U20.24, U20.25, U21.22, U21.23, U21.24, U21.25, U22.22, U22.23, U22.24, U22.25
+12V_IN: J2.1, R320.1, U18.10
GND: C100.2, C101.2, C102.2, C103.2, C104.2, C105.2, C106.2, C107.2, C108.2, C109.2, C110.2, C111.2, C112.2, C113.2, C114.2, C115.2, C116.2, C117.2, C118.2, C119.2, C120.2, C121.2, C122.2, C123.2, C124.2, C125.2, C126.2, C127.2, C128.2, C129.2, C130.2, C131.2, C132.2, C133.2, C134.2, C135.2, C136.2, C137.2, C138.2, C139.2, C140.2, C141.2, C142.2, C143.2, C144.2, C145.2, C146.2, C147.2, C148.2, C149.2, C150.2, C151.2, C152.2, C153.2, C154.2, C155.2, C156.2, C157.2, C158.2, C159.2, C160.2, C201.2, C203.2, C204.2, C205.2, C206.2, C207.2, C208.2, C209.2, C210.2, C212.2, C214.2, C215.2, C216.2, C217.2, C219.2, C221.2, C222.2, C223.2, C224.2, C226.2, C228.2, C229.2, C230.2, C231.2, C232.2, C233.2, C235.2, C236.2, C237.2, C238.2, C239.2, C240.2, C241.2, C242.2, C244.2, C245.2, C246.2, C247.2, C248.2, C249.2, C250.2, C251.2, C252.2, C253.2, C254.2, C255.2, C256.2, C257.2, C258.2, C259.2, C260.2, C261.2, C262.2, C263.2, C264.2, C265.2, C266.2, C267.2, C268.2, C269.2, C270.2, C271.2, C272.2, C273.2, C274.2, C275.2, C276.2, C278.2, C279.2, C280.2, C281.2, C282.2, C283.2, C284.2, C285.2, C286.2, C288.2, C289.2, C290.2, C291.2, C292.2, C300.2, C301.2, C302.2, C303.2, C304.2, C305.2, C306.2, C307.2, C308.2, C309.2, C310.2, C311.2, C312.2, C313.2, C314.2, C315.2, C316.2, C317.2, C318.2, C319.2, C320.2, C321.2, C322.2, C323.2, C324.2, C325.2, C326.2, C327.2, C328.2, C329.2, C330.2, C331.2, C332.2, C333.2, C334.2, C335.2, C336.2, C337.2, C338.2, C339.2, C340.2, C341.2, C342.2, C343.2, C344.2, C345.2, C346.2, C347.2, C348.2, C349.2, C350.2, C351.2, C352.2, C353.2, C354.2, C355.2, C356.2, C357.2, C358.2, C359.2, C360.2, C361.2, C362.2, C363.2, C400.2, C401.2, C402.2, C403.2, C404.2, C405.2, C406.2, C407.2, C409.2, C410.2, C420.2, J1.8, J1.SH, J2.2, J3.1, J3.3, J3.5, J3.7, J3.9, J3.11, J3.13, J4.1, J5.2, J6.1, Q1.2, R202.2, R204.2, R206.2, R208.2, R211.1, R213.2, R215.2, R217.2, R218.2, R221.2, R222.2, R225.2, R227.2, R230.2, R234.2, R238.2, R241.2, R244.2, R245.2, R252.2, R254.2, R255.2, R258.2, R259.2, R260.2, R287.2, R302.2, R304.2, R306.2, R308.2, R310.2, R312.2, R317.2, R318.2, R331.2, R332.2, R333.2, RT1.2, U2.A1, U2.A2, U2.A3, U2.A5, U2.A7, U2.A8, U2.A9, U2.A10, U2.A11, U2.A12, U2.A22, U2.AA2, U2.AA12, U2.AA22, U2.AB9, U2.AB19, U2.B2, U2.B3, U2.B5, U2.B7, U2.B8, U2.B9, U2.B10, U2.B11, U2.B12, U2.B19, U2.C3, U2.C4, U2.C6, U2.C8, U2.C9, U2.C10, U2.C11, U2.C12, U2.C16, U2.D1, U2.D3, U2.D4, U2.D6, U2.D8, U2.D9, U2.D10, U2.D11, U2.D12, U2.D13, U2.E4, U2.E5, U2.E7, U2.E8, U2.E9, U2.E11, U2.E20, U2.F1, U2.F5, U2.F7, U2.F8, U2.F9, U2.F11, U2.F17, U2.G5, U2.G6, U2.G7, U2.G8, U2.G9, U2.G10, U2.G12, U2.G14, U2.H1, U2.H7, U2.H9, U2.H11, U2.H21, U2.J1, U2.J8, U2.J10, U2.J12, U2.J18, U2.K5, U2.K7, U2.K9, U2.K11, U2.K15, U2.L2, U2.L8, U2.L9, U2.L10, U2.L22, U2.M7, U2.M9, U2.M10, U2.M11, U2.M19, U2.N6, U2.N8, U2.N16, U2.P3, U2.P7, U2.P9, U2.P11, U2.P13, U2.R8, U2.R10, U2.R12, U2.R20, U2.T7, U2.T9, U2.T11, U2.T17, U2.U4, U2.U14, U2.V1, U2.V11, U2.V21, U2.W8, U2.W18, U2.Y5, U2.Y15, U3.A9, U3.B1, U3.B3, U3.B9, U3.D1, U3.D8, U3.E1, U3.E2, U3.E8, U3.F9, U3.G1, U3.G8, U3.G9, U3.J2, U3.J8, U3.M1, U3.M9, U3.P1, U3.P9, U3.T1, U3.T9, U7.4, U8.25, U9.8, U10.6, U10.13, U10.14, U10.15, U10.16, U10.17, U10.18, U10.19, U10.20, U10.21, U10.36, U10.37, U10.41, U11.2, U11.3, U11.15, U12.2, U12.3, U12.15, U13.6, U13.15, U13.16, U13.17, U14.6, U14.15, U14.16, U14.17, U15.6, U15.15, U15.16, U15.17, U16.6, U16.15, U16.16, U16.17, U17.3, U17.4, U17.5, U18.1, U18.2, U18.7, U19.6, U19.15, U19.16, U19.17, U20.1, U20.2, U20.3, U20.6, U20.13, U20.14, U20.15, U20.16, U20.17, U20.18, U20.19, U20.20, U20.21, U20.30, U20.31, U20.32, U20.36, U20.37, U20.41, U21.1, U21.2, U21.3, U21.6, U21.13, U21.14, U21.15, U21.16, U21.17, U21.18, U21.19, U21.20, U21.21, U21.30, U21.31, U21.32, U21.36, U21.37, U21.41, U22.1, U22.2, U22.3, U22.6, U22.13, U22.14, U22.15, U22.16, U22.17, U22.18, U22.19, U22.20, U22.21, U22.30, U22.31, U22.32, U22.36, U22.37, U22.41, XU1.A37 (GND), XU1.AB32 (GND), XU1.AC5 (GND), XU1.AC33 (GND), XU1.AD2 (GND), XU1.AD34 (GND), XU1.AF32 (GND), XU1.AF36 (GND), XU1.AG5 (GND), XU1.AH2 (GND), XU1.AH34 (GND), XU1.AJ3 (GND), XU1.AJ7 (GND), XU1.AJ11 (GND), XU1.AJ15 (GND), XU1.AJ19 (GND), XU1.AJ23 (GND), XU1.AJ27 (GND), XU1.AK4 (GND), XU1.AK36 (GND), XU1.AL1 (GND), XU1.AL3 (GND), XU1.AM6 (GND), XU1.AM10 (GND), XU1.AM14 (GND), XU1.AM18 (GND), XU1.AM22 (GND), XU1.AM26 (GND), XU1.AM30 (GND), XU1.AM34 (GND), XU1.AN3 (GND), XU1.B4 (GND), XU1.B8 (GND), XU1.B12 (GND), XU1.B16 (GND), XU1.B20 (GND), XU1.B24 (GND), XU1.B28 (GND), XU1.B32 (GND), XU1.D2 (GND), XU1.D4 (GND), XU1.D18 (GND), XU1.D22 (GND), XU1.D26 (GND), XU1.D30 (GND), XU1.D34 (GND), XU1.E7 (GND), XU1.E11 (GND), XU1.E15 (GND), XU1.E19 (GND), XU1.F20 (GND), XU1.F24 (GND), XU1.F28 (GND), XU1.F32 (GND), XU1.F36 (GND), XU1.G5 (GND), XU1.H2 (GND), XU1.H34 (GND), XU1.K36 (GND), XU1.L5 (GND), XU1.M2 (GND), XU1.M34 (GND), XU1.P32 (GND), XU1.P36 (GND), XU1.Q5 (GND), XU1.R34 (GND), XU1.T32 (GND), XU1.T36 (GND), XU1.U5 (GND), XU1.V2 (GND), XU1.V34 (GND), XU1.X32 (GND), XU1.X36 (GND), XU1.Y5 (GND), XU1.Y37 (GND), XU1.Z2 (GND), XU1.Z34 (GND), Y1.2, Y1.4, Y2.2, Y2.4
VCORE: C207.1, C208.1, C209.1, C210.1, C287.1, C300.1, C301.1, C305.1, C306.1, C307.1, C308.1, C309.1, C311.1, C314.1, C315.1, C316.1, C317.1, C318.1, C319.1, C320.1, C321.1, C322.1, C323.1, C324.1, C325.1, C326.1, C327.1, C331.1, C333.1, C334.1, C335.1, C336.1, C338.1, C339.1, C340.1, C341.1, C342.1, C343.1, C344.1, C345.1, C346.1, C347.1, C348.1, C353.1, C354.1, C356.1, C357.1, C358.1, C359.1, C360.1, C361.1, C362.1, C363.1, L1.2, L9.2, L10.2, L11.2, R210.1, R265.2, R303.1, XU1.AA5 (VCCCORE), XU1.AA37 (VCCCORE), XU1.AB2 (VCCCORE), XU1.AB34 (VCCCORE), XU1.AD32 (VCCCORE), XU1.AE5 (VCCCORE), XU1.AF2 (VCCCORE), XU1.AF34 (VCCCORE), XU1.AH24 (VCCCORE), XU1.AH32 (VCCCORE), XU1.AH36 (VCCCORE), XU1.AJ5 (VCCCORE), XU1.AJ9 (VCCCORE), XU1.AJ13 (VCCCORE), XU1.AJ17 (VCCCORE), XU1.AJ21 (VCCCORE), XU1.AJ25 (VCCCORE), XU1.AJ29 (VCCCORE), XU1.AK2 (VCCCORE), XU1.AK34 (VCCCORE), XU1.AM4 (VCCCORE), XU1.AM8 (VCCCORE), XU1.AM12 (VCCCORE), XU1.AM16 (VCCCORE), XU1.AM20 (VCCCORE), XU1.AM24 (VCCCORE), XU1.AM28 (VCCCORE), XU1.AM32 (VCCCORE), XU1.B6 (VCCCORE), XU1.B10 (VCCCORE), XU1.B14 (VCCCORE), XU1.B18 (VCCCORE), XU1.B22 (VCCCORE), XU1.B26 (VCCCORE), XU1.B30 (VCCCORE), XU1.B34 (VCCCORE), XU1.C3 (VCCCORE), XU1.D6 (VCCCORE), XU1.D20 (VCCCORE), XU1.D24 (VCCCORE), XU1.D28 (VCCCORE), XU1.D32 (VCCCORE), XU1.D36 (VCCCORE), XU1.E5 (VCCCORE), XU1.E9 (VCCCORE), XU1.E13 (VCCCORE), XU1.E17 (VCCCORE), XU1.F2 (VCCCORE), XU1.F4 (VCCCORE), XU1.F14 (VCCCORE), XU1.F22 (VCCCORE), XU1.F26 (VCCCORE), XU1.F30 (VCCCORE), XU1.F34 (VCCCORE), XU1.H32 (VCCCORE), XU1.H36 (VCCCORE), XU1.J5 (VCCCORE), XU1.K2 (VCCCORE), XU1.K32 (VCCCORE), XU1.K34 (VCCCORE), XU1.M32 (VCCCORE), XU1.N5 (VCCCORE), XU1.P2 (VCCCORE), XU1.P34 (VCCCORE), XU1.R32 (VCCCORE), XU1.R36 (VCCCORE), XU1.S5 (VCCCORE), XU1.T2 (VCCCORE), XU1.T34 (VCCCORE), XU1.V32 (VCCCORE), XU1.V36 (VCCCORE), XU1.W5 (VCCCORE), XU1.Y35 (VCCCORE), XU1.Z32 (VCCCORE)
VREF1V0: C328.1, C329.1, C330.1, C352.1, C420.1, R330.2, R331.1, U2.C20, U2.D15, U2.E3, U2.N3, U2.V3, U2.W7, XU1.AD6 (VREF), XU1.AK12 (VREF), XU1.AK22 (VREF), XU1.E33 (VREF), XU1.F18 (VREF), XU1.K4 (VREF), XU1.R6 (VREF), XU1.V6 (VREF)
VTT1V5: C253.1, C254.1, C302.1, C303.1, C304.1, C310.1, C312.1, C313.1, C332.1, C337.1, C349.1, C350.1, C351.1, C355.1, L4.2, R226.1, R228.1, R261.2, R266.2, R267.2, R268.2, R269.2, R270.2, R271.2, R272.2, R273.2, R274.2, R275.2, R276.2, R278.2, R279.2, R280.2, R281.2, R282.2, R283.2, R284.2, R285.2, R286.2, R330.1, U13.14, XU1.AA33 (VTT), XU1.AA35 (VTT), XU1.AB36 (VCCCMOS), XU1.AD36 (VCC1), XU1.AH20 (VTT), XU1.AK16 (VTT), XU1.AL13 (VTT), XU1.AL21 (VTT), XU1.AN11 (VTT), XU1.AN15 (VTT), XU1.AN21 (VTT), XU1.E23 (VTT), XU1.G35 (VTT), XU1.S33 (VTT), XU1.S37 (VTT), XU1.U35 (VTT), XU1.U37 (VTT)
cpu_a20m_n: R261.1, U2.A21, XU1.AE33 (A20M#)
cpu_a[3]: U2.AA6, XU1.AK8 (A3#)
cpu_a[4]: U2.Y9, XU1.AH12 (A4#)
cpu_a[5]: U2.Y6, XU1.AH8 (A5#)
cpu_a[6]: U2.AB7, XU1.AN9 (A6#)
cpu_a[7]: U2.T6, XU1.AL15 (A7#)
cpu_a[8]: U2.V8, XU1.AH10 (A8#)
cpu_a[9]: U2.V7, XU1.AL9 (A9#)
cpu_a[10]: U2.V5, XU1.AH6 (A10#)
cpu_a[11]: U2.Y8, XU1.AK10 (A11#)
cpu_a[12]: U2.M6, XU1.AN5 (A12#)
cpu_a[13]: U2.AB5, XU1.AL7 (A13#)
cpu_a[14]: U2.E13, XU1.AK14 (A14#)
cpu_a[15]: U2.T5, XU1.AL5 (A15#)
cpu_a[16]: U2.W6, XU1.AN7 (A16#)
cpu_a[17]: U2.F4, XU1.AE1 (A17#)
cpu_a[18]: U2.J6, XU1.Z6 (A18#)
cpu_a[19]: U2.R4, XU1.AG3 (A19#)
cpu_a[20]: U2.U3, XU1.AC3 (A20#)
cpu_a[21]: U2.H4, XU1.AJ1 (A21#)
cpu_a[22]: U2.P4, XU1.AE3 (A22#)
cpu_a[23]: U2.K6, XU1.AB6 (A23#)
cpu_a[24]: U2.T4, XU1.AB4 (A24#)
cpu_a[25]: U2.L6, XU1.AF6 (A25#)
cpu_a[26]: U2.Y2, XU1.Y3 (A26#)
cpu_a[27]: U2.R2, XU1.AA1 (A27#)
cpu_a[28]: U2.W5, XU1.AK6 (A28#)
cpu_a[29]: U2.J5, XU1.Z4 (A29#)
cpu_a[30]: U2.L4, XU1.AA3 (A30#)
cpu_a[31]: U2.AB3, XU1.AD4 (A31#)
cpu_a[32]: U2.P5, XU1.X6 (A32#)
cpu_a[33]: U2.AA1, XU1.AC1 (A33#)
cpu_a[34]: U2.G4, XU1.W3 (A34#)
cpu_a[35]: U2.N5, XU1.AF4 (A35#)
cpu_ads_n: U2.E22, XU1.AN31 (ADS#)
cpu_bclk: U9.10, XU1.W37 (BCLK)
cpu_binit_n: U2.G21, XU1.B36 (BINIT#)
cpu_bnr_n: U2.C13, XU1.AH14 (BNR#)
cpu_bpri_n: U2.F15, XU1.AN17 (BPRI#)
cpu_br0_n: U2.F20, XU1.AN29 (BR0#)
cpu_bsel[0]: R262.1, XU1.AJ33 (BSEL)
cpu_bsel[1]: R263.1, XU1.AJ31 (BSEL)
cpu_clkref: C289.1, R251.2, R252.1, XU1.Y33 (CLKREF)
cpu_d[0]: U2.R1, XU1.W1 (D0#)
cpu_d[1]: U2.R3, XU1.T4 (D1#)
cpu_d[2]: U2.J2, XU1.N1 (D2#)
cpu_d[3]: U2.H5, XU1.M6 (D3#)
cpu_d[4]: U2.U1, XU1.U1 (D4#)
cpu_d[5]: U2.L3, XU1.S3 (D5#)
cpu_d[6]: U2.V4, XU1.T6 (D6#)
cpu_d[7]: U2.G2, XU1.J1 (D7#)
cpu_d[8]: U2.T1, XU1.S1 (D8#)
cpu_d[9]: U2.Y3, XU1.P6 (D9#)
cpu_d[10]: U2.K3, XU1.Q3 (D10#)
cpu_d[11]: U2.AB1, XU1.M4 (D11#)
cpu_d[12]: U2.G3, XU1.Q1 (D12#)
cpu_d[13]: U2.H2, XU1.L1 (D13#)
cpu_d[14]: U2.W1, XU1.N3 (D14#)
cpu_d[15]: U2.U2, XU1.U3 (D15#)
cpu_d[16]: U2.P2, XU1.H4 (D16#)
cpu_d[17]: U2.V2, XU1.R4 (D17#)
cpu_d[18]: U2.M3, XU1.P4 (D18#)
cpu_d[19]: U2.K4, XU1.H6 (D19#)
cpu_d[20]: U2.N2, XU1.L3 (D20#)
cpu_d[21]: U2.L1, XU1.G1 (D21#)
cpu_d[22]: U2.L5, XU1.F8 (D22#)
cpu_d[23]: U2.F3, XU1.G3 (D23#)
cpu_d[24]: U2.AB2, XU1.K6 (D24#)
cpu_d[25]: U2.K2, XU1.E3 (D25#)
cpu_d[26]: U2.E2, XU1.E1 (D26#)
cpu_d[27]: U2.R6, XU1.F12 (D27#)
cpu_d[28]: U2.H3, XU1.A5 (D28#)
cpu_d[29]: U2.P1, XU1.A3 (D29#)
cpu_d[30]: U2.M2, XU1.J3 (D30#)
cpu_d[31]: U2.Y1, XU1.C5 (D31#)
cpu_d[32]: U2.W2, XU1.F6 (D32#)
cpu_d[33]: U2.D2, XU1.C1 (D33#)
cpu_d[34]: U2.T3, XU1.C7 (D34#)
cpu_d[35]: U2.M1, XU1.B2 (D35#)
cpu_d[36]: U2.W4, XU1.C9 (D36#)
cpu_d[37]: U2.M5, XU1.A9 (D37#)
cpu_d[38]: U2.AA3, XU1.D8 (D38#)
cpu_d[39]: U2.Y4, XU1.D10 (D39#)
cpu_d[40]: U2.Y7, XU1.C15 (D40#)
cpu_d[41]: U2.AB6, XU1.D14 (D41#)
cpu_d[42]: U2.P6, XU1.D12 (D42#)
cpu_d[43]: U2.J4, XU1.A7 (D43#)
cpu_d[44]: U2.AA4, XU1.A11 (D44#)
cpu_d[45]: U2.U5, XU1.C11 (D45#)
cpu_d[46]: U2.A14, XU1.A21 (D46#)
cpu_d[47]: U2.U7, XU1.A15 (D47#)
cpu_d[48]: U2.V9, XU1.A17 (D48#)
cpu_d[49]: U2.U6, XU1.C13 (D49#)
cpu_d[50]: U2.F16, XU1.C25 (D50#)
cpu_d[51]: U2.B17, XU1.A13 (D51#)
cpu_d[52]: U2.AA8, XU1.D16 (D52#)
cpu_d[53]: U2.A15, XU1.A23 (D53#)
cpu_d[54]: U2.D14, XU1.C21 (D54#)
cpu_d[55]: U2.B13, XU1.C19 (D55#)
cpu_d[56]: U2.A18, XU1.C27 (D56#)
cpu_d[57]: U2.A13, XU1.A19 (D57#)
cpu_d[58]: U2.C15, XU1.C23 (D58#)
cpu_d[59]: U2.W9, XU1.C17 (D59#)
cpu_d[60]: U2.D16, XU1.A25 (D60#)
cpu_d[61]: U2.E17, XU1.A27 (D61#)
cpu_d[62]: U2.C17, XU1.E25 (D62#)
cpu_d[63]: U2.AB8, XU1.F16 (D63#)
cpu_dbsy_n: U2.E19, XU1.AL27 (DBSY#)
cpu_defer_n: U2.AA5, XU1.AN19 (DEFER#)
cpu_drdy_n: U2.F19, XU1.AN27 (DRDY#)
cpu_edgctrl: R265.1, XU1.AG1 (EDGCTRL)
cpu_ferr_n: R266.1, U2.F21, XU1.AC35 (FERR#)
cpu_flush_n: R267.1, U2.B22, XU1.AE37 (FLUSH#)
cpu_hit_n: U2.F18, XU1.AL25 (HIT#)
cpu_hitm_n: U2.E18, XU1.AL23 (HITM#)
cpu_ierr_n: R268.1, U2.D22, XU1.AE35 (IERR#)
cpu_ignne_n: R269.1, U2.G22, XU1.AG37 (IGNNE#)
cpu_init_n: R270.1, U2.B20, XU1.AG33 (INIT#)
cpu_lint0: R271.1, U2.F14, XU1.M36 (LINT0/INTR)
cpu_lint1: R272.1, XU1.L37 (LINT1/NMI)
cpu_lock_n: U2.D17, XU1.AK20 (LOCK#)
cpu_picclk: U9.6, XU1.J33 (PICCLK)
cpu_picd[0]: R273.1, XU1.J35 (PICD)
cpu_picd[1]: R274.1, XU1.L35 (PICD)
cpu_pll: C287.2, C288.1, XU1.U33 (PLL), XU1.W33 (PLL)
cpu_prdy_n: R275.1, XU1.A35 (PRDY#)
cpu_preq_n: R276.1, XU1.J37 (PREQ#)
cpu_pres_n: R264.1, XU1.C37 (CPUPRES#)
cpu_pwrgood: R277.1, U2.F13, XU1.AK26 (PWRGOOD)
cpu_req[0]: U2.B16, XU1.AK18 (REQ0#)
cpu_req[1]: U2.E14, XU1.AH16 (REQ1#)
cpu_req[2]: U2.A16, XU1.AH18 (REQ2#)
cpu_req[3]: U2.E16, XU1.AL19 (REQ3#)
cpu_req[4]: U2.B15, XU1.AL17 (REQ4#)
cpu_reset_n: R278.1, R288.1, U2.N4, XU1.AH4 (RESET#), XU1.X4 (RESET2#)
cpu_reset_rc: C292.1, R288.2
cpu_rs[0]: U2.D19, XU1.AH26 (RS0#)
cpu_rs[1]: U2.B18, XU1.AH22 (RS1#)
cpu_rs[2]: U2.D20, XU1.AK28 (RS2#)
cpu_rttctrl: R332.1, XU1.S35 (RTTCTRL)
cpu_slewctrl: R333.1, XU1.E27 (SLEWCTRL)
cpu_slp_n: R279.1, U2.C14, XU1.AH30 (SLP#)
cpu_smi_n: R280.1, U2.D21, XU1.AJ35 (SMI#)
cpu_stpclk_n: R281.1, U2.E21, XU1.AG35 (STPCLK#)
cpu_tck: R282.1, XU1.AL33 (TCK)
cpu_tdi: R283.1, XU1.AN35 (TDI)
cpu_tdo: R284.1, XU1.AN37 (TDO)
cpu_thermdn: C408.2, U17.2, XU1.AL29 (THERMDN)
cpu_thermdp: C408.1, U17.1, XU1.AL31 (THERMDP)
cpu_thermtrip_n: R285.1, U2.C18, XU1.AH28 (THERMTRIP#)
cpu_tms: R286.1, XU1.AK32 (TMS)
cpu_trdy_n: U2.C19, XU1.AN25 (TRDY#)
cpu_trst_n: R287.1, XU1.AN33 (TRST#)
ddr3_a[0]: U2.J17, U3.N3
ddr3_a[1]: U2.L16, U3.P7
ddr3_a[2]: U2.K16, U3.P3
ddr3_a[3]: U2.L13, U3.N2
ddr3_a[4]: U2.M16, U3.P8
ddr3_a[5]: U2.J16, U3.P2
ddr3_a[6]: U2.K14, U3.R8
ddr3_a[7]: U2.J15, U3.R2
ddr3_a[8]: U2.M13, U3.T8
ddr3_a[9]: U2.L15, U3.R3
ddr3_a[10]: U2.N19, U3.L7
ddr3_a[11]: U2.L19, U3.R7
ddr3_a[12]: U2.K17, U3.N7
ddr3_a[13]: U2.K13, U3.T3
ddr3_a[14]: U2.N18, U3.T7
ddr3_ba[0]: U2.L18, U3.M2
ddr3_ba[1]: U2.N20, U3.N8
ddr3_ba[2]: U2.M18, U3.M3
ddr3_cas_n: U2.L20, U3.K3
ddr3_ck_n: U2.K19, U3.K7
ddr3_ck_p: U2.K18, U3.J7
ddr3_cke: U2.M20, U3.K9
ddr3_cs_n: U2.M17, U3.L2
ddr3_dm[0]: U2.H15, U3.E7
ddr3_dm[1]: U2.G20, U3.D3
ddr3_dq[0]: U2.G18, U3.E3
ddr3_dq[1]: U2.H17, U3.F7
ddr3_dq[2]: U2.G17, U3.F2
ddr3_dq[3]: U2.G16, U3.F8
ddr3_dq[4]: U2.H18, U3.H3
ddr3_dq[5]: U2.H13, U3.H8
ddr3_dq[6]: U2.G15, U3.G2
ddr3_dq[7]: U2.G13, U3.H7
ddr3_dq[8]: U2.J19, U3.D7
ddr3_dq[9]: U2.H22, U3.C3
ddr3_dq[10]: U2.J22, U3.C8
ddr3_dq[11]: U2.H19, U3.C2
ddr3_dq[12]: U2.J21, U3.A7
ddr3_dq[13]: U2.H20, U3.A2
ddr3_dq[14]: U2.L21, U3.B8
ddr3_dq[15]: U2.J20, U3.A3
ddr3_dqs_n[0]: U2.H14, U3.G3
ddr3_dqs_n[1]: U2.K22, U3.B7
ddr3_dqs_p[0]: U2.J14, U3.F3
ddr3_dqs_p[1]: U2.K21, U3.C7
ddr3_odt: U2.M21, U3.K1
ddr3_ras_n: U2.M22, U3.J3
ddr3_reset_n: U2.L14, U3.T2
ddr3_vref: C409.1, R316.2, R317.1, U3.H1, U3.M8
ddr3_we_n: U2.M15, U3.L3
ddr3_zq: R318.1, U3.L8
en_vcc2v5: R258.1, U2.AA9, U16.13
en_vcore: R259.1, U2.AB16, U10.27, U20.27, U21.27, U22.27
en_vtt1v5: R260.1, U2.AB17, U13.13
eth_mdc: U2.Y21, U8.13
eth_mdi_rxn: J1.6, R249.1, U8.22
eth_mdi_rxp: J1.3, R248.1, U8.23
eth_mdi_txn: J1.2, R247.1, U8.20
eth_mdi_txp: J1.1, R246.1, U8.21
eth_mdio: U2.T21, U8.12
eth_nintsel: R245.1, U8.2
eth_rbias: R244.1, U8.24
eth_ref_clk: U2.Y18, U8.14
eth_rmii_crs_dv: U2.U21, U8.11
eth_rmii_rx_er: U2.V22, U8.10
eth_rmii_rxd[0]: U2.W21, U8.8
eth_rmii_rxd[1]: U2.W22, U8.7
eth_rmii_tx_en: U2.AB20, U8.16
eth_rmii_txd[0]: U2.AB21, U8.17
eth_rmii_txd[1]: U2.AB22, U8.18
eth_rst_n: U2.AA21, U8.15
eth_vdda: C277.2, C278.1, C279.1, C280.1, C284.1, J1.4, J1.5, R246.2, R247.2, R248.2, R249.2, U8.1, U8.19
eth_vddcr: C282.1, C283.1, U8.6
eth_xtal1: C285.1, U8.5, Y1.1
eth_xtal2: C286.1, R250.1, Y1.3
eth_xtal2_drv: R250.2, U8.4
fan_pwm: J6.4, Q1.3
fan_pwm_g: Q1.1, R302.1, U2.P20
fan_tach: J6.3, R300.1, R301.1
fan_tach_f: C400.1, R300.2, U2.T20
fpga_init_b: R257.1, U2.U12
fpga_m0: R253.1, U2.U11
fpga_m1: R254.1, U2.U10
fpga_m2: R255.1, U2.U9
fpga_program_b: R256.1, U2.N12
fpga_refclk: U2.W11, U9.9
i2c_scl: R313.1, U2.AB10, U9.4, U10.3, U17.7, U18.5
i2c_sda: R314.1, U2.AB11, U9.5, U10.2, U17.6, U18.4
jtag_tck: J3.6, U2.V12
jtag_tdi: J3.10, U2.R13
jtag_tdo: J3.8, U2.U13
jtag_tms: J3.4, U2.T13
spi_clk: J5.4, U2.L12, U7.6
spi_cs_n: J5.3, U2.T19, U7.1
spi_dq0: J5.6, U2.P22, U7.5
spi_dq1: J5.5, U2.R22, U7.2
spi_dq2: U2.P21, U7.3
spi_dq3: U2.R21, U7.7
sw_1v0: L5.1, U14.1, U14.2, U14.3
sw_1v8: L6.1, U15.1, U15.2, U15.3
sw_1v35: L8.1, U19.1, U19.2, U19.3
sw_2v5: L7.1, U16.1, U16.2, U16.3
sw_3v3: C243.2, L3.1, U12.11, U12.12
sw_5v: C234.2, L2.1, U11.11, U11.12
sw_vcore: C202.2, L1.1, U10.8, U10.9, U10.10, U10.11, U10.12
sw_vcore_b: C213.2, L9.1, U20.8, U20.9, U20.10, U20.11, U20.12
sw_vcore_c: C220.2, L10.1, U21.8, U21.9, U21.10, U21.11, U21.12
sw_vcore_d: C227.2, L11.1, U22.8, U22.9, U22.10, U22.11, U22.12
sw_vtt1v5: L4.1, U13.1, U13.2, U13.3
tsen_socket: C404.1, R305.2, R306.1, RT1.1, U2.G1
u9_xa: C290.1, U9.2, Y2.1
u9_xb: C291.1, U9.3, Y2.3
u10_adrsel: R207.2, R208.1, U10.31
u10_avin: C206.1, R200.2, U10.26
u10_boot: C202.1, U10.7
u10_bp1v5: C200.1, R201.1, R203.1, R205.1, R207.1, U10.4
u10_drtn: C200.2, U10.5
u10_msel1: R201.2, R202.1, U10.32
u10_msel2: R203.2, R204.1, U10.29
u10_pgood: R209.2, U10.1
u10_vdd5: C201.1, U10.28
u10_vsel: R205.2, R206.1, U10.30
u11_boot: C234.1, U11.13
u11_comp: R219.1, U11.8
u11_compz: C240.1, R219.2
u11_fb: R220.2, R221.1, U11.7
u11_rt: R218.1, U11.1
u11_ss: C235.1, U11.9
u12_boot: C243.1, U12.13
u12_comp: R223.1, U12.8
u12_compz: C249.1, R223.2
u12_fb: R224.2, R225.1, U12.7
u12_rt: R222.1, U12.1
u12_ss: C244.1, U12.9
u13_fb: R226.2, R227.1, U13.5
u13_pg: R228.2, U13.4
u13_ss: C252.1, U13.9
u14_en: R232.2, U14.13
u14_fb: R229.2, R230.1, U14.5
u14_pg: R231.2, U14.4
u14_ss: C257.1, U14.9
u15_en: R236.2, U15.13
u15_fb: R233.2, R234.1, U15.5
u15_pg: R235.2, U15.4
u15_ss: C263.1, U15.9
u16_fb: R237.2, R238.1, U16.5
u16_pg: R239.2, U16.4
u16_ss: C268.1, U16.9
u19_en: R243.2, U19.13
u19_fb: R240.2, R241.1, U19.5
u19_pg: R242.2, U19.4
u19_ss: C273.1, U19.9
u20_avin: C217.1, R212.2, U20.26
u20_boot: C213.1, U20.7
u20_bp1v5: C211.1, U20.4, U20.34
u20_drtn: C211.2, U20.5
u20_msel2: R213.1, U20.29
u20_vdd5: C212.1, U20.28
u21_avin: C224.1, R214.2, U21.26
u21_boot: C220.1, U21.7
u21_bp1v5: C218.1, U21.4, U21.34
u21_drtn: C218.2, U21.5
u21_msel2: R215.1, U21.29
u21_vdd5: C219.1, U21.28
u22_avin: C231.1, R216.2, U22.26
u22_boot: C227.1, U22.7
u22_bp1v5: C225.1, U22.4, U22.34
u22_drtn: C225.2, U22.5
u22_msel2: R217.1, U22.29
u22_vdd5: C226.1, U22.28
uart_rx: J4.2, U2.AB13
uart_tx: J4.3, U2.AB15
vcore_bcx_clk: U10.39, U20.39, U21.39, U22.39
vcore_bcx_dat: U10.40, U20.40, U21.40, U22.40
vcore_gsense: R211.2, R289.2, U10.34
vcore_sense: R210.2, R289.1, U10.33
vcore_sync: U10.38, U20.38, U21.38, U22.38
vcore_vshare: U10.35, U20.35, U21.35, U22.35
vsen_3v3: C406.1, R309.2, R310.1, U2.K1
vsen_5v: C405.1, R307.2, R308.1, U2.E1
vsen_12v: C407.1, R311.2, R312.1, U2.C2
vsen_vcore: C403.1, R303.2, R304.1, U2.B1
