alphaonex86/FPGAmotherboard/i386/fpga-ep4ce22/i386sx-motherboard.kicad_pcb

## KiCad design i386/fpga-ep4ce22/i386sx-motherboard.kicad_pcb (2026-10-29)

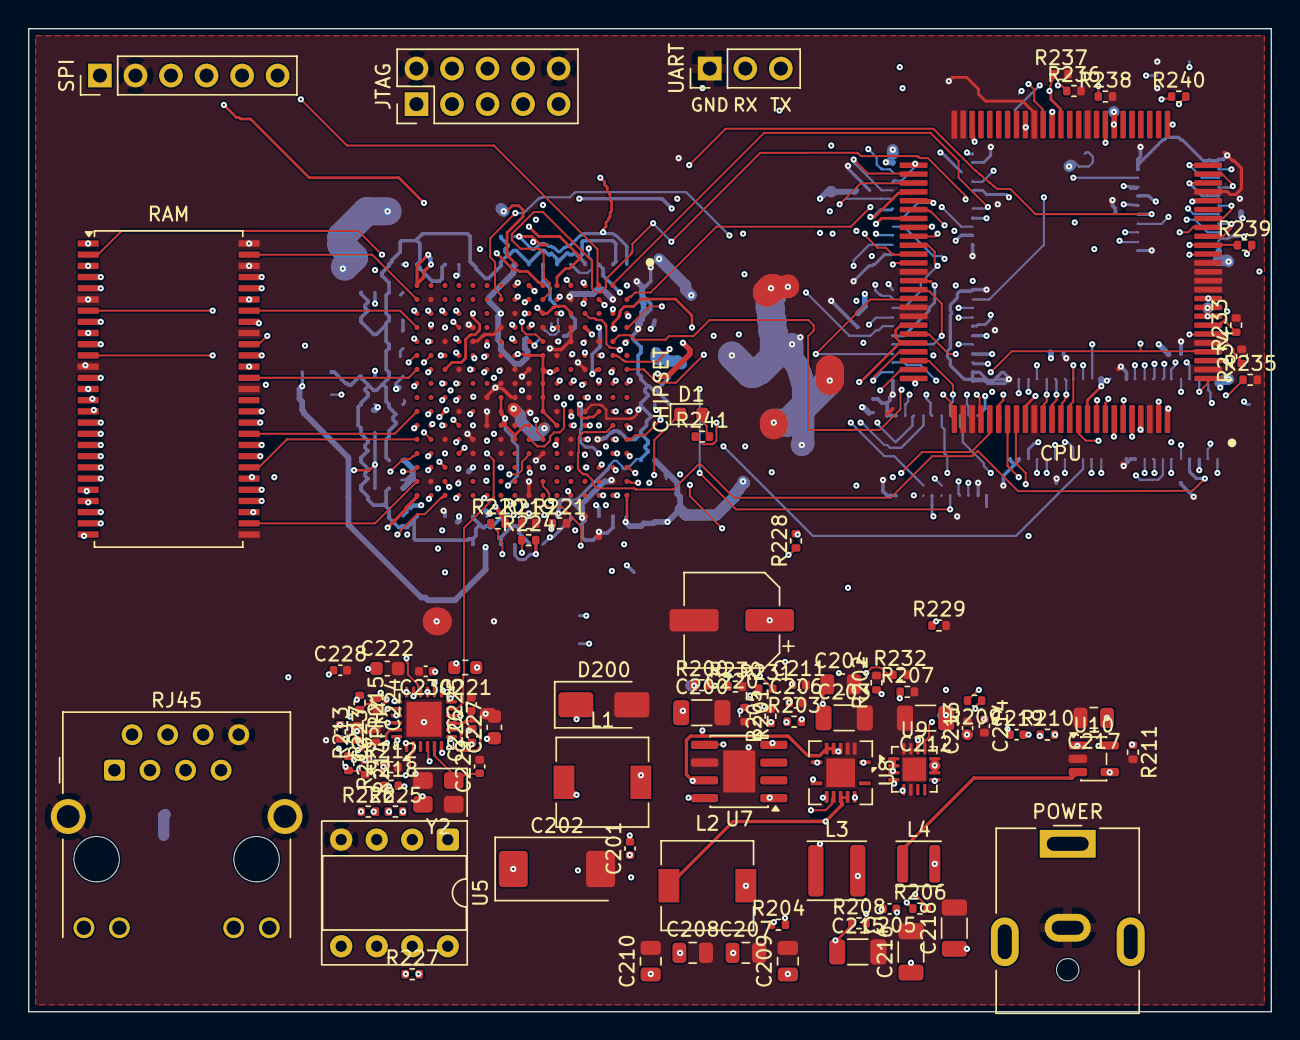
[picture p18: board i386sx-motherboard.kicad_pcb from above]

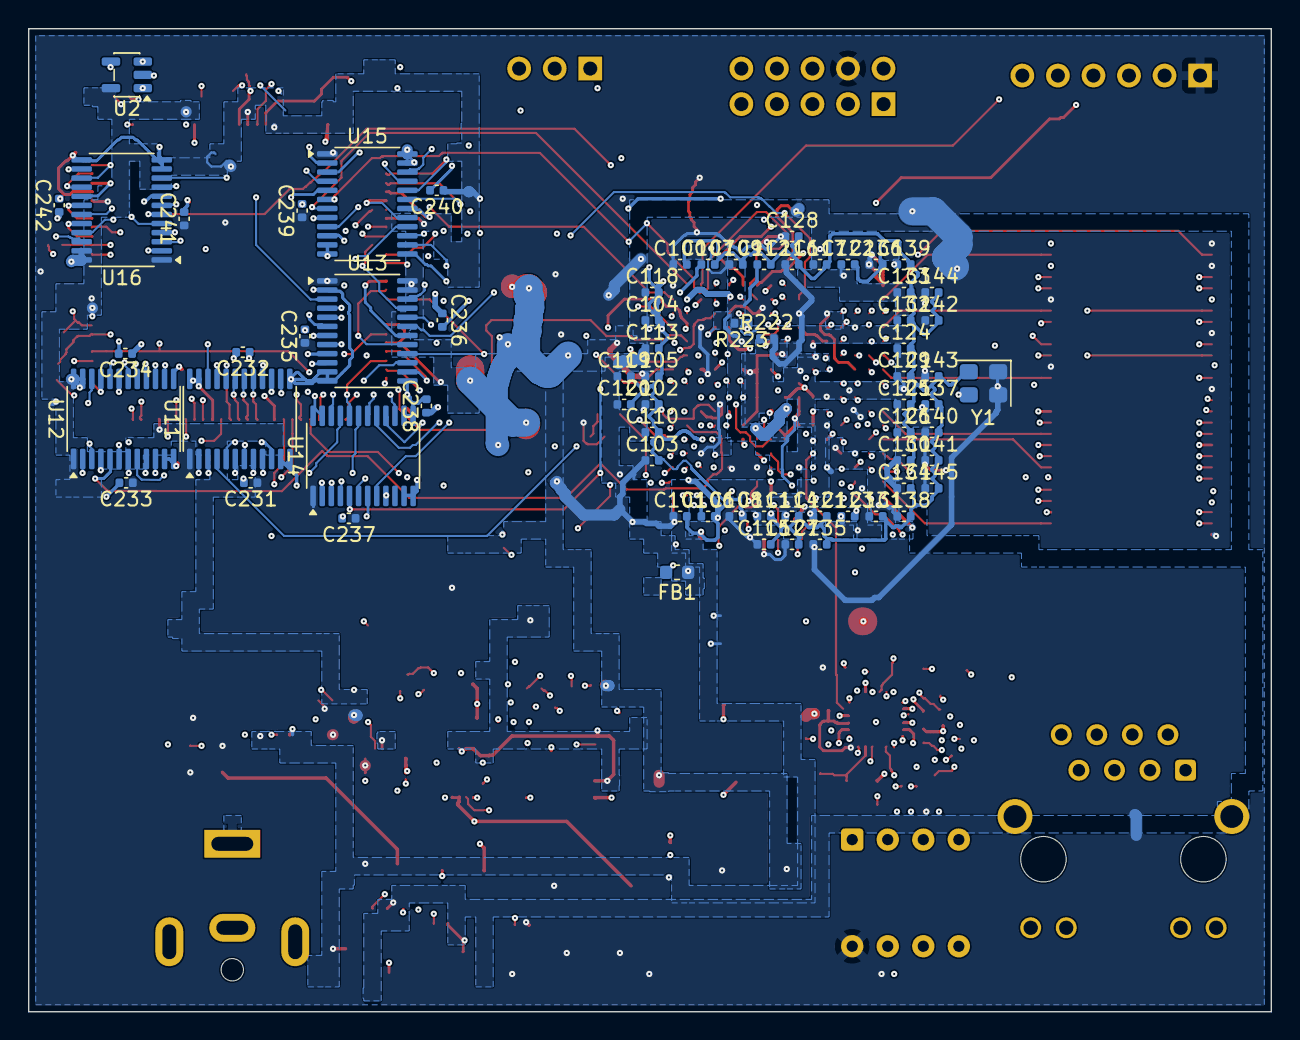
[picture p19: board i386sx-motherboard.kicad_pcb from below]

Board: 6 copper layers, 88.8 x 70.2 mm, 161 parts (69 on the bottom side), 213 nets.

Parts:
C100, C101, C102, C103, C104, C105, C106, C107, C108, C109, C110, C111, C112, C113, C114, C115, C116, C117, C118, C119, C120, C121, C122, C123, C124, C125, C126, C127, C128, C129, C130, C131, C132, C133, C134, C135, C136, C137, C138, C139, C140, C141, C142, C143, C144, C145: 100nF; C_0402_1005Metric
C200, C203, C212, C215, C216, C218: 22uF 25V X5R; C_1206_3216Metric
C201, C206: 10nF 50V X7R; C_0402_1005Metric
C202: 220uF 10V ESR<=40mR; CP_EIA-7343-31_Kemet-D
C204: 4.7uF 25V X7R; C_0805_2012Metric
C205, C213, C223, C224, C225, C228, C231, C232, C233, C234, C235, C236, C237, C238, C239, C240, C241, C242: 100nF 16V X7R; C_0402_1005Metric
C207, C208, C209, C210: 47uF 6.3V X5R; C_0805_2012Metric
C211: 8.2nF 50V X7R; C_0402_1005Metric
C214: 3.3nF 50V X7R; C_0402_1005Metric
C217: 10uF 16V X5R; C_0805_2012Metric
C219: 6.8pF 50V C0G; C_0402_1005Metric
C220: 100uF 25V; CP_Elec_6.3x7.7
C221: 600R@100MHz bead; L_0603_1608Metric
C222: 10uF 10V X5R; C_0603_1608Metric
C226: 470pF 50V C0G; C_0402_1005Metric
C227: 1uF 16V X7R; C_0603_1608Metric
C229, C230: 15pF 50V C0G; C_0402_1005Metric
D1: red LED KT-0603R; LED_0603_1608Metric
D200: B340A 40V 3A; D_SMA
FB1: 600R@100MHz bead; L_0603_1608Metric
J1: HR911105A; RJ45_Hanrun_HR911105A_Horizontal
J2: PJ-063AH 12V; BarrelJack_CUI_PJ-063AH_Horizontal
J3: JTAG; PinHeader_2x05_P2.54mm_Vertical
J4: SPI ISP; PinHeader_1x06_P2.54mm_Vertical
J5: UART; PinHeader_1x03_P2.54mm_Vertical
L1: 10uH ETQP4M100YFN; L_6.3x6.3_H3
L2: 2.2uH SRN6045TA-2R2Y; L_6.3x6.3_H3
L3: 2.2uH SLW4020P2R2MST; L_APV_ANR4020
L4: 1.0uH VLS3012HBX-1R0M; L_APV_ANR3012
R200: 30.9k 1%; R_0402_1005Metric
R201, R205, R207, R213, R222, R223, R224, R226, R227, R228, R229: 10k 1%; R_0402_1005Metric
R202, R208, R209, R211: 100k 1%; R_0402_1005Metric
R203: 1.69k 1%; R_0402_1005Metric
R204: 31.6k 1%; R_0402_1005Metric
R206: 4.99k 1%; R_0402_1005Metric
R210, R231: 316k 1%; R_0402_1005Metric
R212: 12.1k 1%; R_0402_1005Metric
R214, R215, R216, R217: 49.9 1%; R_0402_1005Metric
R218: 500R 1%; R_0402_1005Metric
R219, R220, R221: 0R; R_0402_1005Metric
R225: 24.9R 1%; R_0402_1005Metric
R230, R233, R234, R235, R236, R237, R238: 1k 1%; R_0402_1005Metric
R232: 46.4k 1%; R_0402_1005Metric
R239, R240: 21.5k 1%; R_0402_1005Metric
R241: 330R 1%; R_0402_1005Metric
U1: NG80386SX-20; Intel_PQFP-100_19.05x19.05mm_P0.635mm
U2: SN74AHCT1G125DBVR; SOT-23-5
U3: EP4CE22F17C8N; Altera_FBGA-256_F256_17x17mm_Layout16x16_P1.0mm
U4: W9825G6KH-6I; TSOP-II-54_22.2x10.16mm_P0.8mm
U5: W25Q64FVDAIG (DIP-8, socketed); DIP-8_W7.62mm_Socket
U6: LAN8720A-CP-TR; QFN-24-1EP_4x4mm_P0.5mm_EP2.5x2.5mm
U7: TPS5430DDAR 12->5V; SOIC-8-1EP_3.9x4.9mm_P1.27mm_EP2.29x3mm
U8: TPS54620RGYR 12->3V3; Texas_S-PVQFN-N14
U9: TPS62130RGTR VCCINT; VQFN-16-1EP_3x3mm_P0.5mm_EP1.68x1.68mm
U10: TLV62569DBVR VCCAUX; SOT-23-5
U11, U12, U13, U14, U15, U16: SN74LVC8T245PWR; TSSOP-24_4.4x7.8mm_P0.65mm
Y1: 25MHz XO; Oscillator_SMD_Abracon_ASE-4Pin_3.2x2.5mm
Y2: 25MHz; Crystal_SMD_3225-4Pin_3.2x2.5mm

Connections:
+3V3: C100.1, C101.1, C102.1, C103.1, C104.1, C105.1, C108.1, C109.1, C115.1, C116.1, C127.1, C128.1, C135.1, C136.1, C140.1, C141.1, C142.1, C143.1, C144.1, C145.1, C207.1, C208.1, C209.1, C210.1, C212.1, C213.1, C217.1, C221.1, C225.1, C231.1, C233.1, C235.1, C237.1, C239.1, C241.1, J3.4, J4.1, L2.2, R204.1, R209.1, R222.2, R223.2, R224.2, R226.2, R227.2, R228.2, R241.1, U3.A1 (VCCIO8), U3.A16 (VCCIO7), U3.C4 (VCCIO8), U3.C7 (VCCIO8), U3.C10 (VCCIO7), U3.C13 (VCCIO7), U3.E3 (VCCIO1), U3.E14 (VCCIO6), U3.G3 (VCCIO1), U3.G14 (VCCIO6), U3.K3 (VCCIO2), U3.K14 (VCCIO5), U3.M3 (VCCIO2), U3.M14 (VCCIO5), U3.P4 (VCCIO3), U3.P7 (VCCIO3), U3.P10 (VCCIO4), U3.P13 (VCCIO4), U3.T1 (VCCIO3), U3.T16 (VCCIO4), U4.1, U4.3, U4.9, U4.14, U4.27, U4.43, U4.49, U5.8, U6.9, U9.10, U9.11, U9.12, U10.1, U10.4, U11.1, U12.1, U13.1, U14.1, U15.1, U16.1, Y1.1, Y1.4
+5V: C202.1, C232.1, C234.1, C236.1, C238.1, C240.1, C242.1, L1.2, R200.1, R239.2, R240.2, U1.8, U1.9, U1.10, U1.21, U1.32, U1.39, U1.42, U1.48, U1.57, U1.69, U1.71, U1.84, U1.91, U1.97, U2.5, U11.23, U11.24, U12.23, U12.24, U13.23, U13.24, U14.23, U14.24, U15.23, U15.24, U16.23, U16.24
+12V: C200.1, C203.1, C204.1, C220.1, J2.1, R231.1, U7.7, U8.4, U8.5, U8.6
GND: C100.2, C101.2, C102.2, C103.2, C104.2, C105.2, C106.2, C107.2, C108.2, C109.2, C110.2, C111.2, C112.2, C113.2, C114.2, C115.2, C116.2, C117.2, C118.2, C119.2, C120.2, C121.2, C122.2, C123.2, C124.2, C125.2, C126.2, C127.2, C128.2, C129.2, C130.2, C131.2, C132.2, C133.2, C134.2, C135.2, C136.2, C137.2, C138.2, C139.2, C140.2, C141.2, C142.2, C143.2, C144.2, C145.2, C200.2, C202.2, C203.2, C204.2, C206.2, C207.2, C208.2, C209.2, C210.2, C211.2, C212.2, C213.2, C214.2, C215.2, C216.2, C217.2, C218.2, C220.2, C222.2, C223.2, C224.2, C225.2, C226.2, C227.2, C228.2, C229.2, C230.2, C231.2, C232.2, C233.2, C234.2, C235.2, C236.2, C237.2, C238.2, C239.2, C240.2, C241.2, C242.2, D200.2, J1.8, J1.SH, J2.2, J3.2, J3.10, J4.2, J5.1, R201.2, R202.2, R205.2, R207.2, R211.2, R212.2, R213.2, R219.2, R221.2, R229.2, R230.2, R232.2, R233.2, R234.2, R235.2, R236.2, R237.2, R238.2, U1.2, U1.5, U1.11, U1.12, U1.13, U1.14, U1.22, U1.35, U1.41, U1.49, U1.50, U1.63, U1.67, U1.68, U1.77, U1.78, U1.85, U1.98, U2.1, U2.3, U3.B2 (GND), U3.B15 (GND), U3.C5 (GND), U3.C12 (GND), U3.D7 (GND), U3.D10 (GND), U3.E2 (GND), U3.E4 (GND), U3.E5 (GNDA3), U3.E12 (GNDA2), U3.E13 (GND), U3.F6 (GND), U3.F10 (GND), U3.G4 (GND), U3.G11 (GND), U3.G13 (GND), U3.H7 (GND), U3.H8 (GND), U3.H9 (GND), U3.H10 (GND), U3.H15 (GND), U3.H16 (GND), U3.J3 (nCE), U3.J7 (GND), U3.J8 (GND), U3.J9 (GND), U3.J10 (GND), U3.J11 (GND), U3.K4 (GND), U3.K6 (GND), U3.K8 (GND), U3.K12 (GND), U3.K13 (GND), U3.L9 (GND), U3.L10 (GND), U3.L11 (GND), U3.M4 (GND), U3.M5 (GNDA1), U3.M12 (GNDA4), U3.M13 (GND), U3.N7 (GND), U3.N10 (GND), U3.P5 (GND), U3.P12 (GND), U3.R2 (GND), U3.R15 (GND), U4.6, U4.12, U4.28, U4.41, U4.46, U4.52, U4.54, U5.4, U6.25, U7.6, U7.9, U8.2, U8.3, U8.15, U9.6, U9.15, U9.16, U9.17, U10.2, U11.11, U11.12, U11.13, U12.11, U12.12, U12.13, U13.2, U13.11, U13.12, U13.13, U14.2, U14.11, U14.12, U14.13, U14.14, U15.2, U15.11, U15.12, U15.13, U16.2, U16.11, U16.12, U16.13, Y1.2, Y2.2, Y2.4
VCCA_PLL: C111.1, C112.1, C131.1, C132.1, C218.1, C219.1, L4.2, R210.1, R220.2, U3.F5 (VCCA3), U3.F12 (VCCA2), U3.L5 (VCCA1), U3.L12 (VCCA4)
VCCD_PLL: C106.1, C107.1, C138.1, C139.1, FB1.2, U3.D4 (VCCD_PLL3), U3.D13 (VCCD_PLL2), U3.N4 (VCCD_PLL1), U3.N13 (VCCD_PLL4)
VCCINT: C110.1, C113.1, C114.1, C117.1, C118.1, C119.1, C120.1, C121.1, C122.1, C123.1, C124.1, C125.1, C126.1, C129.1, C130.1, C133.1, C134.1, C137.1, C215.1, C216.1, FB1.1, L3.2, R206.1, R208.1, U3.F7 (VCCINT), U3.F11 (VCCINT), U3.G6 (VCCINT), U3.G7 (VCCINT), U3.G8 (VCCINT), U3.G9 (VCCINT), U3.G10 (VCCINT), U3.H6 (VCCINT), U3.H11 (VCCINT), U3.J6 (VCCINT), U3.J12 (VCCINT), U3.K7 (VCCINT), U3.K9 (VCCINT), U3.K10 (VCCINT), U3.K11 (VCCINT), U3.L6 (VCCINT), U3.M9 (VCCINT), U3.M11 (VCCINT), U9.14
clk25: U3.T8 (CLK14), Y1.3
cpu_a[1]: U1.18, U16.19
cpu_a[2]: U1.51, U15.21
cpu_a[3]: U1.52, U15.20
cpu_a[4]: U1.53, U15.19
cpu_a[5]: U1.54, U15.18
cpu_a[6]: U1.55, U15.17
cpu_a[7]: U1.56, U15.16
cpu_a[8]: U1.58, U15.15
cpu_a[9]: U1.59, U15.14
cpu_a[10]: U1.60, U13.21
cpu_a[11]: U1.61, U13.20
cpu_a[12]: U1.62, U13.19
cpu_a[13]: U1.64, U13.18
cpu_a[14]: U1.65, U13.17
cpu_a[15]: U1.66, U13.16
cpu_a[16]: U1.70, U13.15
cpu_a[17]: U1.72, U13.14
cpu_a[18]: U1.73, U14.20
cpu_a[19]: U1.74, U14.19
cpu_a[20]: U1.75, U14.18
cpu_a[21]: U1.76, U14.15
cpu_a[22]: U1.79, U14.16
cpu_a[23]: U1.80, U14.17
cpu_ads_n: R239.1, U1.16, U16.21
cpu_bhe_n: U1.19, U16.18
cpu_ble_n: U1.17, U16.20
cpu_clk2: U1.15, U2.4
cpu_d[0]: U1.1, U12.21
cpu_d[1]: U1.100, U12.20
cpu_d[2]: U1.99, U12.19
cpu_d[3]: U1.96, U12.18
cpu_d[4]: U1.95, U12.17
cpu_d[5]: U1.94, U12.16
cpu_d[6]: U1.93, U12.15
cpu_d[7]: U1.92, U12.14
cpu_d[8]: U1.90, U11.21
cpu_d[9]: U1.89, U11.20
cpu_d[10]: U1.88, U11.19
cpu_d[11]: U1.87, U11.18
cpu_d[12]: U1.86, U11.17
cpu_d[13]: U1.83, U11.16
cpu_d[14]: U1.82, U11.15
cpu_d[15]: U1.81, U11.14
cpu_dc_n: U1.24, U16.16
cpu_hlda: U1.3, U14.21
cpu_hold: R235.1, U1.4, U3.E8 (IO)
cpu_intr: R236.1, U1.40, U3.D6 (IO)
cpu_lock_n: R240.1, U1.26, U16.14
cpu_mio_n: U1.23, U16.17
cpu_na_n: R234.1, U1.6, U3.C8 (IO)
cpu_nmi: R237.1, U1.38, U3.G1 (IO)
cpu_pwr_en: R230.1, U3.G16 (IO), U7.5
cpu_ready_n: R233.1, U1.7, U3.A7 (IO)
cpu_reset: R238.1, U1.33, U3.B7 (IO)
cpu_wr_n: U1.25, U16.15
eth_mdc: U3.N15 (IO), U6.13
eth_mdi_rxn: J1.6, R217.1, U6.22
eth_mdi_rxp: J1.3, R216.1, U6.23
eth_mdi_txn: J1.2, R215.1, U6.20
eth_mdi_txp: J1.1, R214.1, U6.21
eth_mdio: U3.N16 (IO), U6.12
eth_nintsel: R213.1, U6.2
eth_rbias: R212.1, U6.24
eth_ref_clk: U3.E16 (CLK5), U6.14
eth_rmii_crs_dv: U3.L13 (IO), U6.11
eth_rmii_rx_er: U3.L14 (IO), U6.10
eth_rmii_rxd[0]: U3.L15 (IO), U6.8
eth_rmii_rxd[1]: U3.L16 (IO), U6.7
eth_rmii_tx_en: U3.P16 (IO), U6.16
eth_rmii_txd[0]: U3.P15 (IO), U6.17
eth_rmii_txd[1]: U3.R16 (IO), U6.18
eth_rst_n: U3.N14 (IO), U6.15
eth_vdda: C221.2, C222.1, C223.1, C224.1, C228.1, J1.4, J1.5, R214.2, R215.2, R216.2, R217.2, U6.1, U6.19
eth_vddcr: C226.1, C227.1, U6.6
eth_xtal1: C229.1, U6.5, Y2.1
eth_xtal2: C230.1, R218.1, Y2.3
eth_xtal2_drv: R218.2, U6.4
fpga_a[1]: U3.D5 (IO), U16.5
fpga_a[2]: U3.F1 (IO), U15.3
fpga_a[3]: U3.E1 (CLK1), U15.4
fpga_a[4]: U3.D1 (IO), U15.5
fpga_a[5]: U3.G2 (IO), U15.6
fpga_a[6]: U3.B1 (IO), U15.7
fpga_a[7]: U3.C2 (IO), U15.8
fpga_a[8]: U3.A2 (IO), U15.9
fpga_a[9]: U3.K2 (IO), U15.10
fpga_a[10]: U3.B3 (IO), U13.3
fpga_a[11]: U3.B8 (CLK11), U13.4
fpga_a[12]: U3.A8 (CLK10), U13.5
fpga_a[13]: U3.E6 (IO), U13.6
fpga_a[14]: U3.B4 (IO), U13.7
fpga_a[15]: U3.A4 (IO), U13.8
fpga_a[16]: U3.B5 (IO), U13.9
fpga_a[17]: U3.A5 (IO), U13.10
fpga_a[18]: U3.C9 (IO), U14.4
fpga_a[19]: U3.D9 (IO), U14.5
fpga_a[20]: U3.E9 (IO), U14.6
fpga_a[21]: U3.B16 (IO), U14.9
fpga_a[22]: U3.B10 (IO), U14.8
fpga_a[23]: U3.F9 (IO), U14.7
fpga_ads_n: U3.D8 (IO), U16.3
fpga_bhe_n: U3.G5 (IO), U16.6
fpga_ble_n: U3.C6 (IO), U16.4
fpga_clk2: U2.2, U3.F8 (IO)
fpga_conf_done: R224.1, U3.H14 (CONF_DONE)
fpga_d[0]: U3.A10 (IO), U12.3
fpga_d[1]: U3.E10 (IO), U12.4
fpga_d[2]: U3.B11 (IO), U12.5
fpga_d[3]: U3.A11 (IO), U12.6
fpga_d[4]: U3.C11 (IO), U12.7
fpga_d[5]: U3.D11 (IO), U12.8
fpga_d[6]: U3.E11 (IO), U12.9
fpga_d[7]: U3.A12 (IO), U12.10
fpga_d[8]: U3.A14 (IO), U11.3
fpga_d[9]: U3.B12 (IO), U11.4
fpga_d[10]: U3.D12 (IO), U11.5
fpga_d[11]: U3.A13 (IO), U11.6
fpga_d[12]: U3.B13 (IO), U11.7
fpga_d[13]: U3.A15 (IO), U11.8
fpga_d[14]: U3.C14 (IO), U11.9
fpga_d[15]: U3.D14 (IO), U11.10
fpga_dc_n: U3.D3 (IO), U16.8
fpga_hlda: U3.B14 (IO), U14.3
fpga_lock_n: U3.F2 (IO), U16.10
fpga_mio_n: U3.A3 (IO), U16.7
fpga_msel0: R219.1, U3.H13 (MSEL0)
fpga_msel1: R220.1, U3.H12 (MSEL1)
fpga_msel2: R221.1, U3.G12 (MSEL2)
fpga_nconfig: R222.1, U3.H5 (nCONFIG)
fpga_nstatus: R223.1, U3.F4 (nSTATUS)
fpga_wr_n: U3.F3 (IO), U16.9
fpga_xlat_dir: R229.1, U3.C16 (IO), U11.2, U12.2
fpga_xlat_oe_n: R228.1, U3.B6 (IO), U11.22, U12.22, U13.22, U14.22, U15.22, U16.22
jtag_tck: J3.1, U3.H3 (TCK)
jtag_tdi: J3.9, U3.H4 (TDI)
jtag_tdo: J3.3, U3.J4 (TDO)
jtag_tms: J3.5, U3.J5 (TMS)
led_a: D1.2, R241.2
led_n: D1.1, U3.G15 (IO)
sdram_a[0]: U3.N11 (IO), U4.23
sdram_a[1]: U3.R12 (IO), U4.24
sdram_a[2]: U3.T13 (IO), U4.25
sdram_a[3]: U3.T14 (IO), U4.26
sdram_a[4]: U3.T15 (IO), U4.29
sdram_a[5]: U3.P14 (IO), U4.30
sdram_a[6]: U3.R14 (IO), U4.31
sdram_a[7]: U3.R13 (IO), U4.32
sdram_a[8]: U3.N12 (IO), U4.33
sdram_a[9]: U3.T12 (IO), U4.34
sdram_a[10]: U3.R11 (IO), U4.22
sdram_a[11]: U3.P11 (IO), U4.35
sdram_a[12]: U3.M10 (IO), U4.36
sdram_ba[0]: U3.R10 (IO), U4.20
sdram_ba[1]: U3.T11 (IO), U4.21
sdram_cas_n: U3.L7 (IO), U4.17
sdram_cke: U3.T10 (IO), U4.37
sdram_clk: U3.P9 (IO), U4.38
sdram_cs_n: U3.N9 (IO), U4.19
sdram_dq[0]: U3.P3 (IO), U4.2
sdram_dq[1]: U3.T3 (IO), U4.4
sdram_dq[2]: U3.R4 (IO), U4.5
sdram_dq[3]: U3.R5 (IO), U4.7
sdram_dq[4]: U3.T5 (IO), U4.8
sdram_dq[5]: U3.N6 (IO), U4.10
sdram_dq[6]: U3.T6 (IO), U4.11
sdram_dq[7]: U3.R6 (IO), U4.13
sdram_dq[8]: U3.T7 (IO), U4.42
sdram_dq[9]: U3.P6 (IO), U4.44
sdram_dq[10]: U3.M6 (IO), U4.45
sdram_dq[11]: U3.N5 (IO), U4.47
sdram_dq[12]: U3.T4 (IO), U4.48
sdram_dq[13]: U3.R3 (IO), U4.50
sdram_dq[14]: U3.N3 (IO), U4.51
sdram_dq[15]: U3.T2 (IO), U4.53
sdram_dqm[0]: U3.R7 (IO), U4.15
sdram_dqm[1]: U3.N8 (IO), U4.39
sdram_ras_n: U3.P8 (IO), U4.18
sdram_we_n: U3.M7 (IO), U4.16
spi_clk: J4.4, U3.H1 (DCLK), U5.6
spi_cs_n: J4.3, U3.D2 (IO), U5.1
spi_io2: R226.1, U5.3
spi_io3: R227.1, U5.7
spi_miso: J4.5, R225.2, U3.H2 (IO)
spi_miso_flash: R225.1, U5.2
spi_mosi: J4.6, U3.C1 (IO), U5.5
sw_3v3: C205.2, L2.1, U8.11, U8.12
sw_5v0: C201.2, D200.1, L1.1, U7.8
sw_vcca: L4.1, U10.3
sw_vccint: L3.1, U9.1, U9.2, U9.3
u7_boot: C201.1, U7.1
u7_fb: R200.2, R201.1, U7.4
u8_boot: C205.1, U8.13
u8_comp: R203.1, U8.8
u8_compz: C211.1, R203.2
u8_en: R231.2, R232.1, U8.10
u8_fb: R204.2, R205.1, U8.7
u8_rt: R202.1, U8.1
u8_ss: C206.1, U8.9
u9_en: R209.2, U9.13
u9_fb: R206.2, R207.1, U9.5
u9_pg: R208.2, U9.4
u9_ss: C214.1, U9.9
u10_fb: C219.2, R210.2, R211.1, U10.5
uart_rx: J5.2, U3.J1 (IO)
uart_tx: J5.3, U3.J2 (IO)
