alphaonex86/FPGAmotherboard/i386/fpga-gw2ar18/hw/i386sx-gw2ar18.kicad_pcb

## KiCad design i386/fpga-gw2ar18/hw/i386sx-gw2ar18.kicad_pcb (2026-10-29)

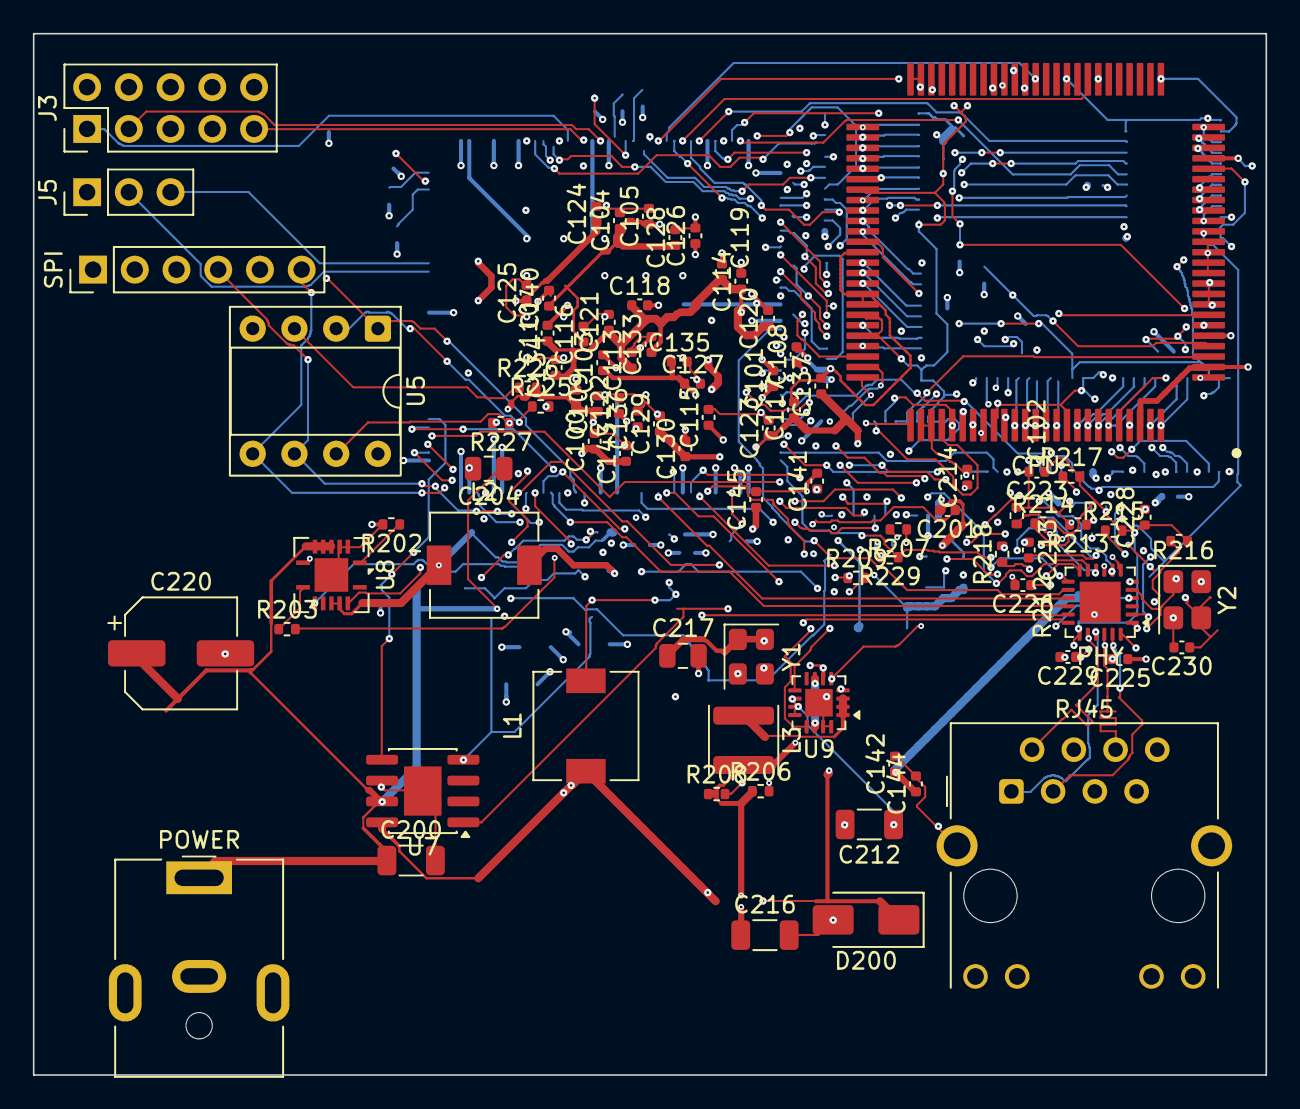
[picture p20: board i386sx-gw2ar18.kicad_pcb from above]

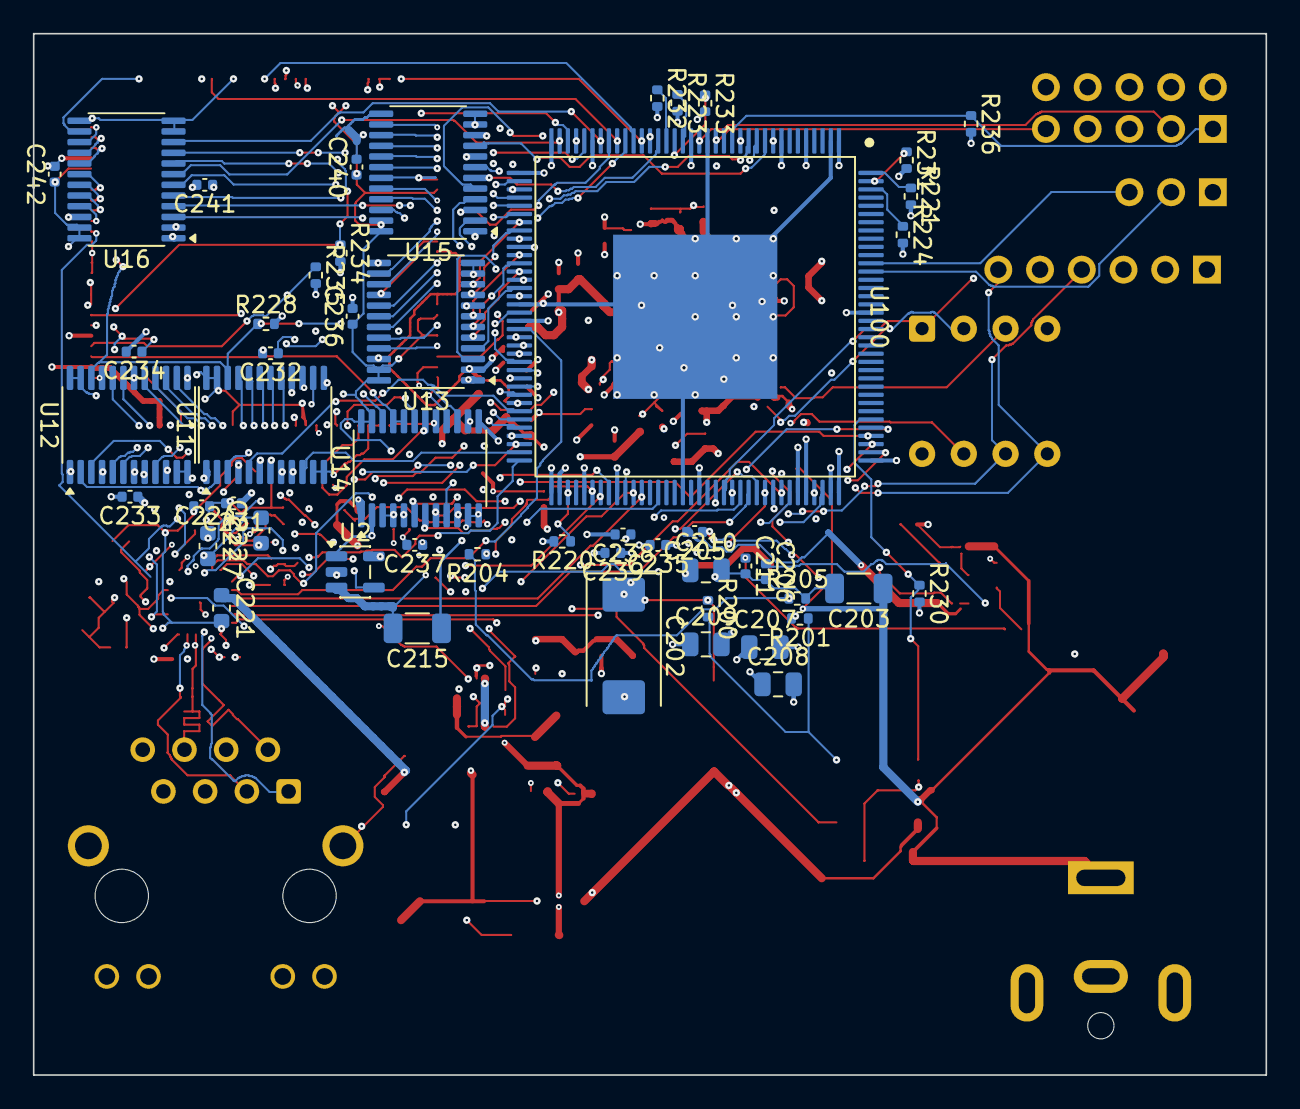
[picture p21: board i386sx-gw2ar18.kicad_pcb from below]

Board: 6 copper layers, 75.0 x 63.4 mm, 137 parts (50 on the bottom side), 168 nets.

Parts:
C100, C101, C102, C103, C104, C105, C108, C109, C110, C113, C114, C115, C116, C117, C118, C119, C120, C121, C122, C123, C124, C125, C126, C127, C128, C129, C130, C133, C134, C135, C136, C137, C140, C141, C142, C143, C144, C145: 100nF; C_0402_1005Metric
C200, C203, C212, C215, C216: 22uF 25V X5R; C_1206_3216Metric
C201, C206: 10nF 50V X7R; C_0402_1005Metric
C202: 220uF 10V ESR<=40mR; CP_EIA-7343-31_Kemet-D
C204: 4.7uF 25V X7R; C_0805_2012Metric
C205, C213, C223, C224, C225, C228, C231, C232, C233, C234, C235, C236, C237, C238, C239, C240, C241, C242: 100nF 16V X7R; C_0402_1005Metric
C207, C208, C209, C210: 47uF 6.3V X5R; C_0805_2012Metric
C211: 8.2nF 50V X7R; C_0402_1005Metric
C214: 3.3nF 50V X7R; C_0402_1005Metric
C217: 10uF 16V X5R; C_0805_2012Metric
C220: 100uF 25V; CP_Elec_6.3x7.7
C221: 600R@100MHz bead; L_0603_1608Metric
C222: 10uF 10V X5R; C_0603_1608Metric
C226: 470pF 50V C0G; C_0402_1005Metric
C227: 1uF 16V X7R; C_0603_1608Metric
C229, C230: 15pF 50V C0G; C_0402_1005Metric
D200: B340A 40V 3A; D_SMA
J1: HR911105A; RJ45_Hanrun_HR911105A_Horizontal
J2: PJ-063AH 12V; BarrelJack_CUI_PJ-063AH_Horizontal
J3: JTAG; PinHeader_2x05_P2.54mm_Vertical
J4: SPI ISP; PinHeader_1x06_P2.54mm_Vertical
J5: UART; PinHeader_1x03_P2.54mm_Vertical
L1: 10uH ETQP4M100YFN; L_6.3x6.3_H3
L2: 2.2uH SRN6045TA-2R2Y; L_6.3x6.3_H3
L3: 2.2uH SLW4020P2R2MST; L_APV_ANR4020
R200: 30.9k 1%; R_0402_1005Metric
R201, R205, R207, R213, R220, R223, R226, R227, R228, R229: 10k 1%; R_0402_1005Metric
R202, R208, R209: 100k 1%; R_0402_1005Metric
R203: 1.69k 1%; R_0402_1005Metric
R204: 31.6k 1%; R_0402_1005Metric
R206: 2.49k 1%; R_0402_1005Metric
R212: 12.1k 1%; R_0402_1005Metric
R214, R215, R216, R217: 49.9 1%; R_0402_1005Metric
R218: 500R 1%; R_0402_1005Metric
R221, R224, R230, R231, R234, R235: 1k 1%; R_0402_1005Metric
R225: 24.9R 1%; R_0402_1005Metric
R232, R233, R236: 4.7k 1%; R_0402_1005Metric
U1: NG80386SX-20; Intel_PQFP-100_19.05x19.05mm_P0.635mm
U2: SN74AHCT1G125DBVR; SOT-23-5
U5: W25Q64FVDAIG (DIP-8, socketed); DIP-8_W7.62mm_Socket
U6: LAN8720A-CP-TR; QFN-24-1EP_4x4mm_P0.5mm_EP2.5x2.5mm
U7: TPS5430DDAR 12->5V; SOIC-8-1EP_3.9x4.9mm_P1.27mm_EP2.29x3mm
U8: TPS54620RGYR 12->3V3; Texas_S-PVQFN-N14
U9: TPS62130RGTR VCCINT; VQFN-16-1EP_3x3mm_P0.5mm_EP1.68x1.68mm
U11, U12, U13, U14, U15, U16: SN74LVC8T245PWR; TSSOP-24_4.4x7.8mm_P0.65mm
U100: GW2AR-LV18EQ144C8/I7; GW2AR-LV18EQ144C8_I7
Y1: 25MHz XO; Oscillator_SMD_Abracon_ASE-4Pin_3.2x2.5mm
Y2: 25MHz; Crystal_SMD_3225-4Pin_3.2x2.5mm

Connections:
+3V3: C100.1, C101.1, C102.1, C103.1, C104.1, C105.1, C108.1, C109.1, C115.1, C116.1, C127.1, C128.1, C135.1, C136.1, C140.1, C141.1, C142.1, C143.1, C144.1, C145.1, C207.1, C208.1, C209.1, C210.1, C217.1, C221.1, C225.1, C231.1, C233.1, C235.1, C237.1, C239.1, C241.1, J3.4, J4.1, L2.2, R204.1, R223.2, R226.2, R227.2, R228.2, R232.2, R233.2, U5.8, U6.9, U11.1, U12.1, U13.1, U14.1, U15.1, U16.1, U100.5, U100.19, U100.31, U100.37, U100.55, U100.77, U100.91, U100.103, U100.109, U100.127, Y1.1, Y1.4
+5V: C202.1, C212.1, C213.1, C232.1, C234.1, C236.1, C238.1, C240.1, C242.1, L1.2, R200.1, R209.1, U1.8, U1.9, U1.10, U1.21, U1.32, U1.39, U1.42, U1.48, U1.57, U1.69, U1.71, U1.84, U1.91, U1.97, U2.5, U9.10, U9.11, U9.12, U11.23, U11.24, U12.23, U12.24, U13.23, U13.24, U14.23, U14.24, U15.23, U15.24, U16.23, U16.24
+12V: C200.1, C203.1, C204.1, C220.1, J2.1, U7.7, U8.4, U8.5, U8.6
GND: C100.2, C101.2, C102.2, C103.2, C104.2, C105.2, C108.2, C109.2, C110.2, C113.2, C114.2, C115.2, C116.2, C117.2, C118.2, C119.2, C120.2, C121.2, C122.2, C123.2, C124.2, C125.2, C126.2, C127.2, C128.2, C129.2, C130.2, C133.2, C134.2, C135.2, C136.2, C137.2, C140.2, C141.2, C142.2, C143.2, C144.2, C145.2, C200.2, C202.2, C203.2, C204.2, C206.2, C207.2, C208.2, C209.2, C210.2, C211.2, C212.2, C213.2, C214.2, C215.2, C216.2, C217.2, C220.2, C222.2, C223.2, C224.2, C225.2, C226.2, C227.2, C228.2, C229.2, C230.2, C231.2, C232.2, C233.2, C234.2, C235.2, C236.2, C237.2, C238.2, C239.2, C240.2, C241.2, C242.2, D200.2, J1.8, J1.SH, J2.2, J3.2, J3.10, J4.2, J5.1, R201.2, R202.2, R205.2, R207.2, R212.2, R213.2, R220.2, R221.2, R224.2, R229.2, R230.2, R231.2, R234.2, R235.2, R236.2, U1.2, U1.5, U1.11, U1.12, U1.13, U1.14, U1.22, U1.35, U1.41, U1.49, U1.50, U1.63, U1.67, U1.68, U1.77, U1.78, U1.85, U1.98, U2.1, U2.3, U5.4, U6.25, U7.6, U7.9, U8.2, U8.3, U8.15, U9.6, U9.15, U9.16, U9.17, U11.11, U11.12, U11.13, U12.11, U12.12, U12.13, U13.2, U13.11, U13.12, U13.13, U14.2, U14.11, U14.12, U14.13, U15.2, U15.11, U15.12, U15.13, U16.2, U16.11, U16.12, U16.13, U100.2, U100.17, U100.53, U100.74, U100.89, U100.107, U100.145, Y1.2, Y2.2, Y2.4
VCCINT: C110.1, C113.1, C114.1, C117.1, C118.1, C119.1, C120.1, C121.1, C122.1, C123.1, C124.1, C125.1, C126.1, C129.1, C130.1, C133.1, C134.1, C137.1, C215.1, C216.1, L3.2, R206.1, R208.1, U9.7, U9.14, U100.1, U100.8, U100.36, U100.73, U100.81, U100.104, U100.108
clk25: U100.98, Y1.3
cpu_a[1]: U1.18, U16.19
cpu_a[2]: U1.51, U15.14
cpu_a[3]: U1.52, U15.15
cpu_a[4]: U1.53, U15.16
cpu_a[5]: U1.54, U15.17
cpu_a[6]: U1.55, U15.18
cpu_a[7]: U1.56, U15.19
cpu_a[8]: U1.58, U15.20
cpu_a[9]: U1.59, U15.21
cpu_a[10]: U1.60, U13.14
cpu_a[11]: U1.61, U13.15
cpu_a[12]: U1.62, U13.16
cpu_a[13]: U1.64, U13.17
cpu_a[14]: U1.65, U13.18
cpu_a[15]: U1.66, U13.19
cpu_a[16]: U1.70, U13.20
cpu_a[17]: U1.72, U13.21
cpu_a[18]: U1.73, U14.14
cpu_a[19]: U1.74, U14.15
cpu_a[20]: U1.75, U14.16
cpu_a[21]: U1.76, U14.17
cpu_a[22]: U1.79, U14.18
cpu_a[23]: U1.80, U14.19
cpu_ads_n: U1.16, U16.21
cpu_bhe_n: U1.19, U16.18
cpu_ble_n: U1.17, U16.20
cpu_clk2: U1.15, U2.4
cpu_d[0]: U1.1, U12.21
cpu_d[1]: U1.100, U12.20
cpu_d[2]: U1.99, U12.19
cpu_d[3]: U1.96, U12.18
cpu_d[4]: U1.95, U12.17
cpu_d[5]: U1.94, U12.16
cpu_d[6]: U1.93, U12.15
cpu_d[7]: U1.92, U12.14
cpu_d[8]: U1.90, U11.21
cpu_d[9]: U1.89, U11.20
cpu_d[10]: U1.88, U11.19
cpu_d[11]: U1.87, U11.18
cpu_d[12]: U1.86, U11.17
cpu_d[13]: U1.83, U11.16
cpu_d[14]: U1.82, U11.15
cpu_d[15]: U1.81, U11.14
cpu_dc_n: U1.24, U16.16
cpu_hlda: U1.3, U14.20, U14.21
cpu_hold: R235.1, U1.4, U100.39
cpu_intr: U1.40, U100.25
cpu_lock_n: U1.26, U16.14
cpu_mio_n: U1.23, U16.17
cpu_na_n: R234.1, U1.6, U100.34
cpu_nmi: U1.38, U100.26
cpu_pwr_en: R230.1, U7.5, U100.114
cpu_ready_n: U1.7, U100.46
cpu_reset: U1.33, U100.28
cpu_wr_n: U1.25, U16.15
eth_mdc: U6.13, U100.83
eth_mdi_rxn: J1.6, R217.1, U6.22
eth_mdi_rxp: J1.3, R216.1, U6.23
eth_mdi_txn: J1.2, R215.1, U6.20
eth_mdi_txp: J1.1, R214.1, U6.21
eth_mdio: U6.12, U100.82
eth_nintsel: R213.1, U6.2
eth_rbias: R212.1, U6.24
eth_ref_clk: U6.14, U100.56
eth_rmii_crs_dv: U6.11, U100.80
eth_rmii_rx_er: U6.10, U100.79
eth_rmii_rxd[0]: U6.8, U100.78
eth_rmii_rxd[1]: U6.7, U100.86
eth_rmii_tx_en: U6.16, U100.97
eth_rmii_txd[0]: U6.17, U100.99
eth_rmii_txd[1]: U6.18, U100.101
eth_rst_n: U6.15, U100.84
eth_vdda: C221.2, C222.1, C223.1, C224.1, C228.1, J1.4, J1.5, R214.2, R215.2, R216.2, R217.2, U6.1, U6.19
eth_vddcr: C226.1, C227.1, U6.6
eth_xtal1: C229.1, U6.5, Y2.1
eth_xtal2: C230.1, R218.1, Y2.3
eth_xtal2_drv: R218.2, U6.4
fpga_a[1]: U16.5, U100.40
fpga_a[2]: U15.10, U100.9
fpga_a[3]: U15.9, U100.10
fpga_a[4]: U15.8, U100.11
fpga_a[5]: U15.7, U100.12
fpga_a[6]: U15.6, U100.23
fpga_a[7]: U15.5, U100.24
fpga_a[8]: U15.4, U100.27
fpga_a[9]: U15.3, U100.29
fpga_a[10]: U13.10, U100.43
fpga_a[11]: U13.9, U100.44
fpga_a[12]: U13.8, U100.45
fpga_a[13]: U13.7, U100.47
fpga_a[14]: U13.6, U100.48
fpga_a[15]: U13.5, U100.49
fpga_a[16]: U13.4, U100.51
fpga_a[17]: U13.3, U100.52
fpga_a[18]: U14.10, U100.113
fpga_a[19]: U14.9, U100.112
fpga_a[20]: U14.8, U100.111
fpga_a[21]: U14.7, U100.110
fpga_a[22]: U14.6, U100.105
fpga_a[23]: U14.5, U100.102
fpga_ads_n: U16.3, U100.42
fpga_bhe_n: U16.6, U100.38
fpga_ble_n: U16.4, U100.41
fpga_clk2: U2.2, U100.106
fpga_d[0]: U12.3, U100.54
fpga_d[1]: U12.4, U100.57
fpga_d[2]: U12.5, U100.58
fpga_d[3]: U12.6, U100.59
fpga_d[4]: U12.7, U100.60
fpga_d[5]: U12.8, U100.61
fpga_d[6]: U12.9, U100.62
fpga_d[7]: U12.10, U100.63
fpga_d[8]: U11.3, U100.64
fpga_d[9]: U11.4, U100.65
fpga_d[10]: U11.5, U100.66
fpga_d[11]: U11.6, U100.67
fpga_d[12]: U11.7, U100.68
fpga_d[13]: U11.8, U100.69
fpga_d[14]: U11.9, U100.70
fpga_d[15]: U11.10, U100.71
fpga_dc_n: U16.8, U100.33
fpga_done: R233.1, U100.21
fpga_extr: R220.1, U100.75
fpga_hlda: U14.3, U14.4, U100.100
fpga_lock_n: U16.10, U100.30
fpga_mio_n: U16.7, U100.35
fpga_mode0: R221.1, U100.144
fpga_mode1: R224.1, U100.142
fpga_mode2: R231.1, U100.143
fpga_ready: R232.1, U100.22
fpga_reconfig_n: R223.1, U100.20
fpga_wr_n: U16.9, U100.32
fpga_xlat_dir: R229.1, U11.2, U12.2, U100.72
fpga_xlat_oe_n: R228.1, U11.22, U12.22, U13.22, U14.22, U15.22, U16.22, U100.50
jtag_tck: J3.1, R236.1, U100.14
jtag_tdi: J3.9, U100.16
jtag_tdo: J3.3, U100.18
jtag_tms: J3.5, U100.13
spi_clk: J4.4, U5.6, U100.93
spi_cs_n: J4.3, U5.1, U100.94
spi_io2: R226.1, U5.3
spi_io3: R227.1, U5.7
spi_miso: J4.5, R225.2, U100.96
spi_miso_flash: R225.1, U5.2
spi_mosi: J4.6, U5.5, U100.95
sw_3v3: C205.2, L2.1, U8.11, U8.12
sw_5v0: C201.2, D200.1, L1.1, U7.8
sw_vccint: L3.1, U9.1, U9.2, U9.3
u7_boot: C201.1, U7.1
u7_fb: R200.2, R201.1, U7.4
u8_boot: C205.1, U8.13
u8_comp: R203.1, U8.8
u8_compz: C211.1, R203.2
u8_fb: R204.2, R205.1, U8.7
u8_rt: R202.1, U8.1
u8_ss: C206.1, U8.9
u9_en: R209.2, U9.13
u9_fb: R206.2, R207.1, U9.5
u9_pg: R208.2, U9.4
u9_ss: C214.1, U9.9
uart_rx: J5.2, U100.132
uart_tx: J5.3, U100.133
