alphaonex86/FPGAmotherboard/socket7/fpga-ti180/routed/socket7-ti180.kicad_pcb

## KiCad design socket7/fpga-ti180/routed/socket7-ti180.kicad_pcb (2026-10-18)

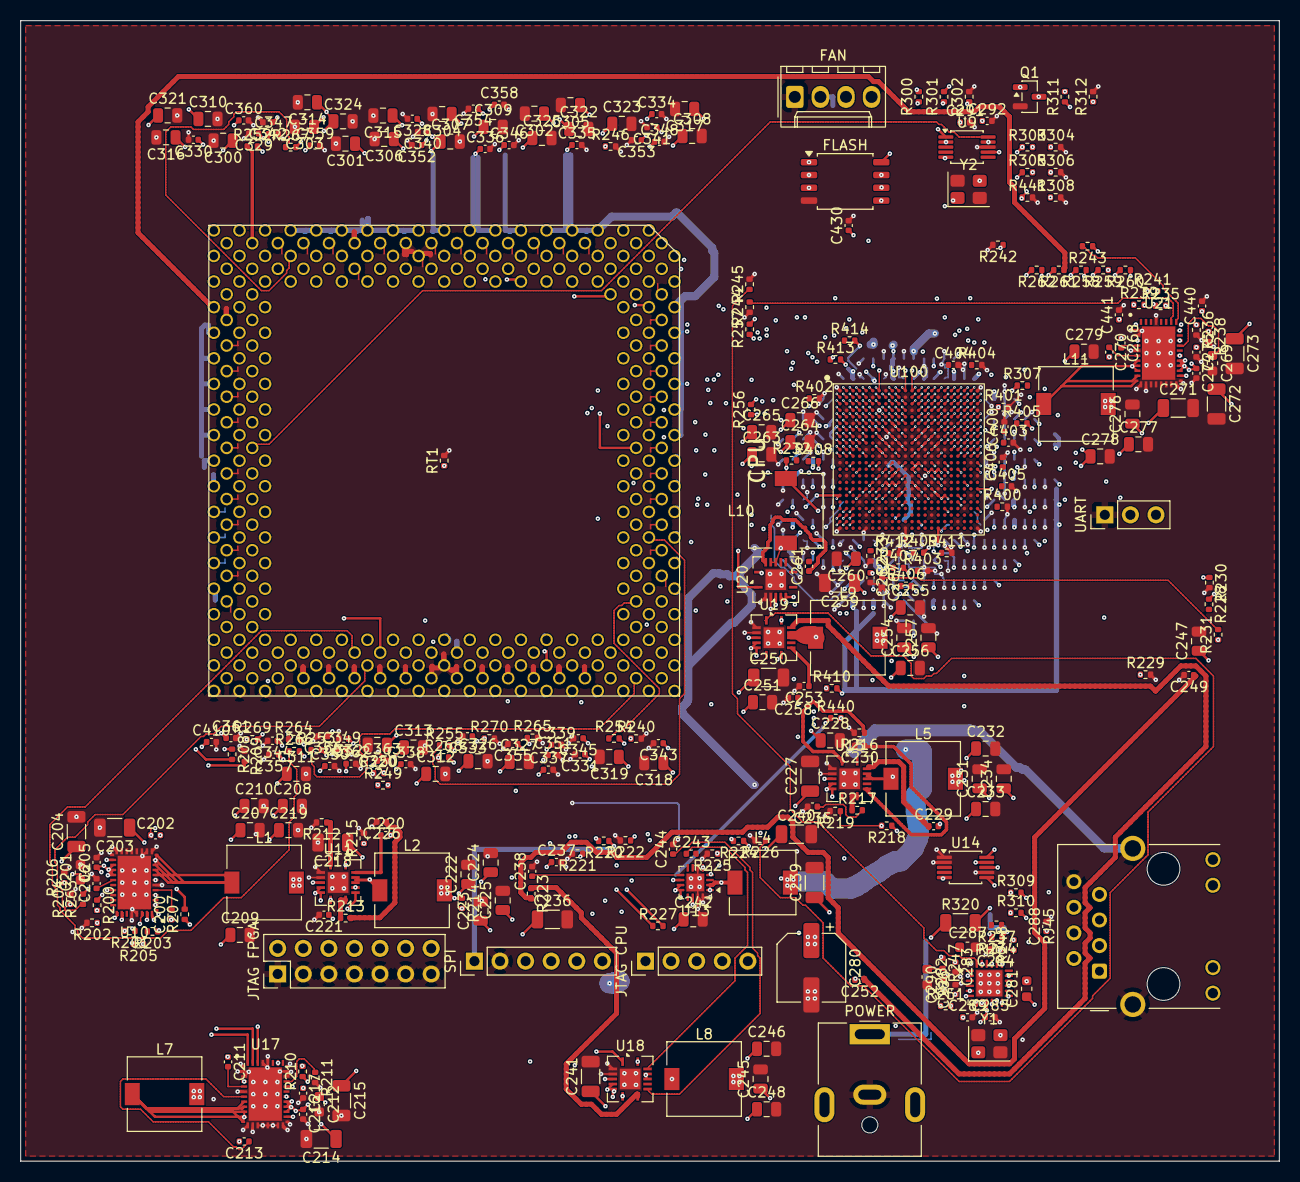
[picture p22: board socket7-ti180.kicad_pcb from above]

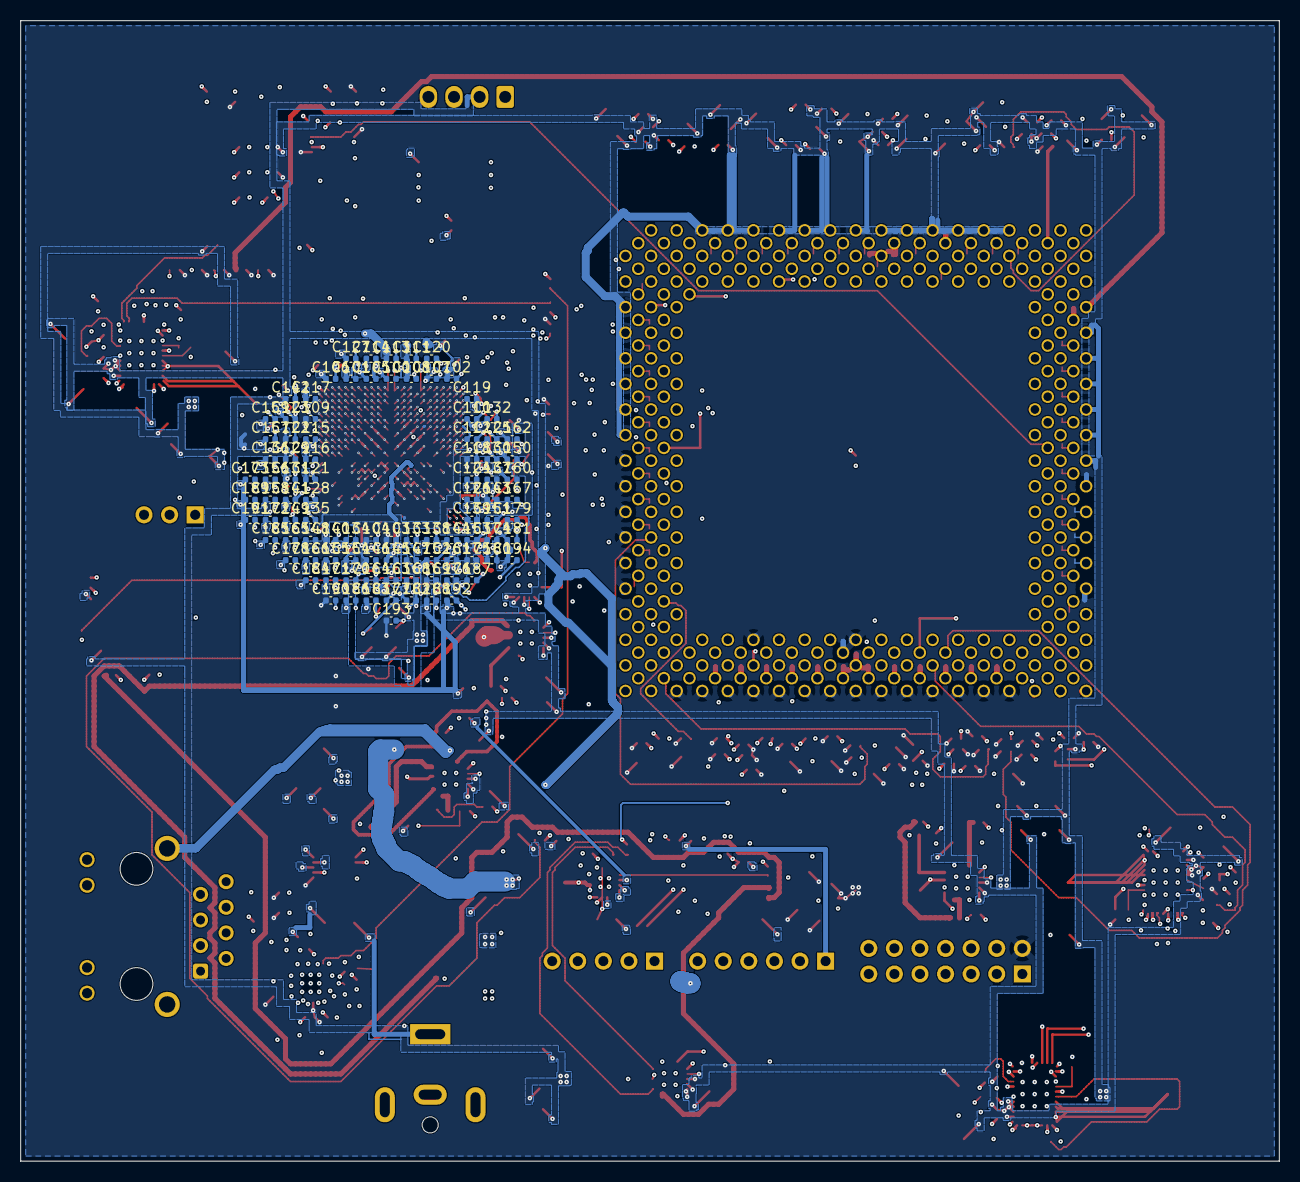
[picture p23: board socket7-ti180.kicad_pcb from below]

Board: 6 copper layers, 124.9 x 113.2 mm, 398 parts (95 on the bottom side), 290 nets.

Parts:
C100, C101, C102, C103, C104, C105, C106, C107, C108, C109, C110, C111, C112, C113, C114, C115, C116, C117, C118, C119, C120, C121, C122, C123, C124, C125, C126, C127, C128, C129, C130, C131, C132, C133, C134, C135, C136, C137, C138, C139, C140, C141, C142, C143, C144, C145, C146, C147, C148, C149, C150, C151, C152, C153, C154, C155, C156, C157, C158, C159, C160, C161, C162, C163, C164, C165, C166, C167, C168, C169, C170, C171, C172, C173, C174, C175, C176, C177, C178, C179, C180, C181, C182, C183, C184, C185, C186, C187, C188, C189, C190, C191, C192, C193, C194: 470nF; C_0402_1005Metric
C200, C211, C268: 1uF 16V X6S; C_0402_1005Metric
C201, C212, C269: 4.7uF 16V X5R; C_0603_1608Metric
C202, C213, C270: 100nF 16V X5R; C_0402_1005Metric
C203, C204, C214, C215, C218, C227, C236, C239, C240, C241, C250, C259, C271, C272, C273: 22uF 25V X5R; C_1206_3216Metric
C205, C216, C221, C230, C244, C253, C262, C274, C403, C404, C405, C406: 10nF 50V X7R; C_0402_1005Metric
C206, C217, C275: 1uF 25V X5R; C_0402_1005Metric
C207, C208, C209, C210, C222, C223, C224, C225, C245, C246, C247, C248, C254, C255, C256, C257, C263, C264, C265, C266, C276, C277, C278, C279: 47uF 6.3V X5R; C_0805_2012Metric
C219, C228, C242, C251, C260: 4.7uF 25V X7R; C_0805_2012Metric
C220, C229, C237, C243, C252, C261, C283, C284, C285, C288, C410, C430: 100nF 16V X7R; C_0402_1005Metric
C226, C235, C249, C258, C267: 8.2nF 50V X7R; C_0402_1005Metric
C231, C232, C233, C234: 47uF 10V X5R; C_0805_2012Metric
C238: 3.3nF 50V X7R; C_0402_1005Metric
C280: 100uF 25V; CP_Elec_6.3x7.7
C281: 600R@100MHz bead; L_0603_1608Metric
C282: 10uF 10V X5R; C_0603_1608Metric
C286: 470pF 50V C0G; C_0402_1005Metric
C287: 1uF 16V X7R; C_0603_1608Metric
C289, C290: 15pF 50V C0G; C_0402_1005Metric
C291, C292: 4pF 50V C0G; C_0402_1005Metric
C300, C301, C302, C303, C304, C305, C306, C307, C308, C309, C310, C311, C312, C313, C314, C315, C316, C317, C318, C319, C320, C321, C322, C323, C324, C325, C326, C327: 22uF; C_0805_2012Metric
C328, C329, C330, C331, C332, C333, C334, C335, C336, C337, C338, C339, C340, C341, C342, C343, C344, C345, C346, C347, C348, C349, C350, C351, C352, C353, C354, C355, C356, C357, C358, C359, C360, C361, C362, C363: 100nF; C_0402_1005Metric
C400: 1nF 50V C0G; C_0402_1005Metric
C440: 22nF 50V X7R; C_0402_1005Metric
C441: 1uF 16V X7R; C_0402_1005Metric
J1: HR911105A; RJ45_Hanrun_HR911105A_Horizontal
J2: SPI ISP; PinHeader_1x06_P2.54mm_Vertical
J3: PJ-063AH 12V; BarrelJack_CUI_PJ-063AH_Horizontal
J4: UART; PinHeader_1x03_P2.54mm_Vertical
J5: FPGA JTAG; PinHeader_2x07_P2.54mm_Vertical
J6: CPU JTAG; PinHeader_1x05_P2.54mm_Vertical
J7: fan 4-pin 1GND 2+12V 3TACH 4PWM; Molex_KK-254_AE-6410-04A_1x04_P2.54mm_Vertical
L1: VCC2 out; L_7.3x7.3_H4.5
L2: 3V3 out; L_7.3x7.3_H4.5
L4: 1V8 out; L_6.3x6.3_H3
L5: 5V out; L_7.3x7.3_H4.5
L7: VCC2 ph2 out; L_7.3x7.3_H4.5
L8: 0V95 out; L_7.3x7.3_H4.5
L9: 0V85 out; L_7.3x7.3_H4.5
L10: 1V1 out; L_7.3x7.3_H4.5
L11: 0V6 out; L_7.3x7.3_H4.5
Q1: BSS138; SOT-23
R200, R210, R234: 10R 1%; R_0402_1005Metric
R201, R202, R205, R239, R240: 21.5k 1%; R_0402_1005Metric
R203: 110k 1%; R_0402_1005Metric
R204: 56.2k 1%; R_0402_1005Metric
R206, R214, R235: 31.6k 1%; R_0402_1005Metric
R207, R215, R219, R221, R225, R229, R233, R246, R265, R270, R301, R302, R303, R305, R309, R310, R311, R400, R401, R402, R403, R404, R406, R407, R408, R409, R410, R411, R412, R413, R414, R440: 10k 1%; R_0402_1005Metric
R208, R209, R243, R244: 0R; R_0402_1005Metric
R211: 17.8k 1%; R_0402_1005Metric
R212, R216, R222, R226, R230: 100k 1%; R_0402_1005Metric
R213, R217, R223, R227, R231, R300: 1.69k 1%; R_0402_1005Metric
R218: 52.3k 1%; R_0402_1005Metric
R220: 12.4k 1%; R_0402_1005Metric
R224: 1.87k 1%; R_0402_1005Metric
R228: 619R 1%; R_0402_1005Metric
R232: 3.74k 1%; R_0402_1005Metric
R236: 6.81k 1%; R_0402_1005Metric
R237: 90.9k 1%; R_0402_1005Metric
R238: 46.4k 1%; R_0402_1005Metric
R241: 1.54k 1%; R_0402_1005Metric
R242: 5.62k 1%; R_0402_1005Metric
R245: 12.1k 1%; R_0402_1005Metric
R247, R248, R249, R250: 49.9 1%; R_0402_1005Metric
R251: 500R 1%; R_0402_1005Metric
R252, R261, R262, R264, R269: 8.2k 1%; R_0402_1005Metric
R253, R254, R255, R256, R257, R258, R259, R260, R263, R266, R267, R268: 4.7k 1%; R_0402_1005Metric
R304, R306, R312: 4.02k 1%; R_0402_1005Metric
R307: 30.9k 1%; R_0402_1005Metric
R308: 2.49k 1%; R_0402_1005Metric
R320: 10mR 1% 1W; R_1206_3216Metric
R405: 240R 1%; R_0402_1005Metric
R441: 22k 1%; R_0402_1005Metric
RT1: 10k NTC 1% B3380; R_0402_1005Metric
U7: LAN8720A-CP-TR; QFN-24-1EP_4x4mm_P0.5mm_EP2.6x2.6mm
U8: W25Q128JWSIQ; SOIC-8_5.3x5.3mm_P1.27mm
U9: SI5351A-B-GTR; MSOP-10_3x3mm_P0.5mm
U10: TPS546B24ARVFR VCC2; Texas_RVF0040A_LQFN-CLIP-40_5x7mm_P0.5mm
U11: TPS54620RGYR 3V3; Texas_S-PVQFN-N14
U13: TPS62130RGTR 1V8; QFN-16-1EP_3x3mm_P0.5mm_EP1.75x1.75mm
U14: INA226AIDGSR; MSOP-10_3x3mm_P0.5mm
U15: TPS54620RGYR 5V; Texas_S-PVQFN-N14
U17: TPS546B24ARVFR VCC2 ph2; Texas_RVF0040A_LQFN-CLIP-40_5x7mm_P0.5mm
U18: TPS54620RGYR 0V95; Texas_S-PVQFN-N14
U19: TPS54620RGYR 0V85; Texas_S-PVQFN-N14
U20: TPS54620RGYR 1V1; Texas_S-PVQFN-N14
U21: TPS546B24ARVFR 0V6; Texas_RVF0040A_LQFN-CLIP-40_5x7mm_P0.5mm
U100: Ti180J484D1C4
XU1: Socket 7 ZIF 321p; Socket7_P55C_296
Y1, Y2: 25MHz; Crystal_SMD_3225-4Pin_3.2x2.5mm

Connections:
0v62_gsense: R244.2, U21.34
0v62_sense: R243.2, U21.33
+0V62: C153.1, C155.1, C156.1, C157.1, C161.1, C163.1, C164.1, C168.1, C172.1, C178.1, C184.1, C185.1, C186.1, C276.1, C277.1, C278.1, C279.1, L11.2, R243.1, R405.2, U100.N8, U100.N10, U100.N14, U100.N15, U100.N16, U100.P9, U100.P11, U100.P13, U100.R16, U100.T15, U100.U14, U100.U16, U100.U17
+0V85: C139.1, C140.1, C141.1, C145.1, C146.1, C147.1, C148.1, C152.1, C154.1, C162.1, C166.1, C254.1, C255.1, C256.1, C257.1, L9.2, R228.1, U100.L10, U100.L12, U100.L14, U100.M9, U100.M11, U100.M12, U100.M13, U100.M15, U100.N9, U100.N12, U100.P16
+0V95: C114.1, C115.1, C116.1, C119.1, C120.1, C121.1, C122.1, C124.1, C125.1, C126.1, C127.1, C128.1, C129.1, C132.1, C133.1, C134.1, C135.1, C137.1, C138.1, C142.1, C144.1, C151.1, C158.1, C180.1, C245.1, C246.1, C247.1, C248.1, L8.2, R224.1, U100.G8, U100.G12, U100.G14, U100.G17, U100.H7, U100.H9, U100.H11, U100.H13, U100.H15, U100.J8, U100.J10, U100.J12, U100.J14, U100.J16, U100.K7, U100.K9, U100.K11, U100.K13, U100.K15, U100.L8, U100.L16, U100.M7, U100.N17, U100.T7
+1V1: C165.1, C167.1, C169.1, C170.1, C171.1, C174.1, C175.1, C176.1, C177.1, C182.1, C263.1, C264.1, C265.1, C266.1, L10.2, R232.1, U100.P7, U100.P15, U100.R8, U100.R9, U100.R10, U100.R12, U100.R14, U100.T11, U100.T13, U100.U10
+1V8: C100.1, C101.1, C102.1, C105.1, C106.1, C107.1, C108.1, C110.1, C111.1, C112.1, C113.1, C117.1, C123.1, C130.1, C131.1, C136.1, C143.1, C149.1, C150.1, C159.1, C160.1, C173.1, C179.1, C181.1, C183.1, C188.1, C189.1, C191.1, C192.1, C194.1, C239.1, C240.1, C430.1, J2.1, L4.2, R220.1, R406.2, R407.2, R408.2, R409.2, R410.2, R413.2, R414.2, U8.8, U13.14, U100.A3, U100.A13, U100.A19, U100.C4, U100.C9, U100.C14, U100.C19, U100.E5, U100.F9, U100.G1, U100.G10, U100.G21, U100.H17, U100.J2, U100.J22, U100.K20, U100.L3, U100.M6, U100.M17, U100.N4, U100.N19, U100.R20, U100.T3, U100.U1, U100.U7, U100.U12, U100.V19, U100.W6, U100.W22, U100.Y2
+3V3: C103.1, C104.1, C109.1, C118.1, C190.1, C193.1, C222.1, C223.1, C224.1, C225.1, C281.1, C285.1, C311.1, C312.1, C313.1, C318.1, C319.1, C320.1, C326.1, C327.1, C331.1, C332.1, C333.1, C337.1, C338.1, C339.1, C343.1, C344.1, C345.1, C349.1, C350.1, C351.1, C355.1, C356.1, C357.1, C361.1, C362.1, C363.1, C410.1, J5.2, L2.2, R207.1, R214.1, R252.2, R253.2, R254.2, R255.2, R256.2, R257.2, R258.2, R259.2, R260.2, R261.2, R262.2, R263.2, R264.2, R266.2, R267.2, R268.2, R269.2, R301.2, R305.1, R309.2, R310.2, R311.1, U7.9, U9.1, U9.7, U14.6, U100.AA13, U100.AB16, U100.E20, U100.G7, U100.W17, U100.Y10, XU1.A19 (VCC3), XU1.A21 (VCC3), XU1.A23 (VCC3), XU1.A25 (VCC3), XU1.A27 (VCC3), XU1.A29 (VCC3), XU1.AA37 (VCC3), XU1.AC37 (VCC3), XU1.AE37 (VCC3), XU1.AG37 (VCC3), XU1.AN21 (VCC3), XU1.AN23 (VCC3), XU1.AN25 (VCC3), XU1.AN27 (VCC3), XU1.AN29 (VCC3), XU1.E37 (VCC3), XU1.G37 (VCC3), XU1.J37 (VCC3), XU1.L33 (VCC3), XU1.L37 (VCC3), XU1.N37 (VCC3), XU1.Q37 (VCC3), XU1.S37 (VCC3), XU1.T34 (VCC3), XU1.U33 (VCC3), XU1.U37 (VCC3), XU1.W37 (VCC3), XU1.Y37 (VCC3)
+5V: C231.1, C232.1, C233.1, C234.1, C236.1, C237.1, L5.2, R218.1, R440.1, U13.10, U13.11, U13.12
+12V: C203.1, C204.1, C205.1, C214.1, C215.1, C216.1, C218.1, C219.1, C227.1, C228.1, C241.1, C242.1, C250.1, C251.1, C259.1, C260.1, C271.1, C272.1, C273.1, C274.1, C280.1, J7.2, R200.1, R210.1, R234.1, R307.1, R320.2, U10.22, U10.23, U10.24, U10.25, U11.4, U11.5, U11.6, U14.8, U14.9, U15.4, U15.5, U15.6, U17.22, U17.23, U17.24, U17.25, U18.4, U18.5, U18.6, U19.4, U19.5, U19.6, U20.4, U20.5, U20.6, U21.22, U21.23, U21.24, U21.25
+12V_IN: J3.1, R320.1, U14.10
GND: C100.2, C101.2, C102.2, C103.2, C104.2, C105.2, C106.2, C107.2, C108.2, C109.2, C110.2, C111.2, C112.2, C113.2, C114.2, C115.2, C116.2, C117.2, C118.2, C119.2, C120.2, C121.2, C122.2, C123.2, C124.2, C125.2, C126.2, C127.2, C128.2, C129.2, C130.2, C131.2, C132.2, C133.2, C134.2, C135.2, C136.2, C137.2, C138.2, C139.2, C140.2, C141.2, C142.2, C143.2, C144.2, C145.2, C146.2, C147.2, C148.2, C149.2, C150.2, C151.2, C152.2, C153.2, C154.2, C155.2, C156.2, C157.2, C158.2, C159.2, C160.2, C161.2, C162.2, C163.2, C164.2, C165.2, C166.2, C167.2, C168.2, C169.2, C170.2, C171.2, C172.2, C173.2, C174.2, C175.2, C176.2, C177.2, C178.2, C179.2, C180.2, C181.2, C182.2, C183.2, C184.2, C185.2, C186.2, C187.1, C187.2, C188.2, C189.2, C190.2, C191.2, C192.2, C193.2, C194.2, C201.2, C203.2, C204.2, C205.2, C206.2, C207.2, C208.2, C209.2, C210.2, C212.2, C214.2, C215.2, C216.2, C217.2, C218.2, C219.2, C221.2, C222.2, C223.2, C224.2, C225.2, C226.2, C227.2, C228.2, C230.2, C231.2, C232.2, C233.2, C234.2, C235.2, C236.2, C237.2, C238.2, C239.2, C240.2, C241.2, C242.2, C244.2, C245.2, C246.2, C247.2, C248.2, C249.2, C250.2, C251.2, C253.2, C254.2, C255.2, C256.2, C257.2, C258.2, C259.2, C260.2, C262.2, C263.2, C264.2, C265.2, C266.2, C267.2, C269.2, C271.2, C272.2, C273.2, C274.2, C275.2, C276.2, C277.2, C278.2, C279.2, C280.2, C282.2, C283.2, C284.2, C285.2, C286.2, C287.2, C288.2, C289.2, C290.2, C291.2, C292.2, C300.2, C301.2, C302.2, C303.2, C304.2, C305.2, C306.2, C307.2, C308.2, C309.2, C310.2, C311.2, C312.2, C313.2, C314.2, C315.2, C316.2, C317.2, C318.2, C319.2, C320.2, C321.2, C322.2, C323.2, C324.2, C325.2, C326.2, C327.2, C328.2, C329.2, C330.2, C331.2, C332.2, C333.2, C334.2, C335.2, C336.2, C337.2, C338.2, C339.2, C340.2, C341.2, C342.2, C343.2, C344.2, C345.2, C346.2, C347.2, C348.2, C349.2, C350.2, C351.2, C352.2, C353.2, C354.2, C355.2, C356.2, C357.2, C358.2, C359.2, C360.2, C361.2, C362.2, C363.2, C400.2, C403.2, C404.2, C405.2, C406.2, C410.2, C430.2, C440.2, C441.2, J1.8, J1.SH, J2.2, J3.2, J4.1, J5.1, J5.3, J5.5, J5.7, J5.9, J5.11, J5.13, J7.1, Q1.2, R202.2, R204.2, R206.2, R209.1, R211.2, R212.2, R215.2, R216.2, R219.2, R221.2, R222.2, R225.2, R226.2, R229.2, R230.2, R233.2, R236.2, R238.2, R240.2, R242.2, R244.1, R245.2, R246.2, R265.2, R270.2, R302.2, R304.2, R306.2, R308.2, R312.2, R400.2, R401.2, R402.2, R403.2, R404.2, R411.2, R412.2, R441.2, RT1.2, U7.25, U8.4, U9.8, U10.6, U10.13, U10.14, U10.15, U10.16, U10.17, U10.18, U10.19, U10.20, U10.21, U10.36, U10.37, U10.41, U11.2, U11.3, U11.15, U13.6, U13.15, U13.16, U13.17, U14.1, U14.2, U14.7, U15.2, U15.3, U15.15, U17.1, U17.2, U17.3, U17.6, U17.13, U17.14, U17.15, U17.16, U17.17, U17.18, U17.19, U17.20, U17.21, U17.30, U17.31, U17.32, U17.36, U17.37, U17.41, U18.2, U18.3, U18.15, U19.2, U19.3, U19.15, U20.2, U20.3, U20.15, U21.2, U21.3, U21.6, U21.13, U21.14, U21.15, U21.16, U21.17, U21.18, U21.19, U21.20, U21.21, U21.37, U21.41, U100.A1, U100.A8, U100.A22, U100.AA8, U100.AA19, U100.AB1, U100.AB5, U100.AB11, U100.AB22, U100.B6, U100.B11, U100.B16, U100.D2, U100.D7, U100.D12, U100.D17, U100.D22, U100.E15, U100.F3, U100.F18, U100.G9, U100.G11, U100.G13, U100.G15, U100.H4, U100.H8, U100.H10, U100.H12, U100.H14, U100.H16, U100.H19, U100.J7, U100.J9, U100.J11, U100.J13, U100.J15, U100.K5, U100.K8, U100.K10, U100.K12, U100.K14, U100.K16, U100.K17, U100.L7, U100.L9, U100.L11, U100.L13, U100.L15, U100.M1, U100.M8, U100.M10, U100.M14, U100.M16, U100.M21, U100.N7, U100.N11, U100.N13, U100.P2, U100.P8, U100.P10, U100.P12, U100.P14, U100.P22, U100.R7, U100.R11, U100.R13, U100.R15, U100.R17, U100.T8, U100.T10, U100.T12, U100.T14, U100.T16, U100.U5, U100.U13, U100.U15, U100.U21, U100.V4, U100.V9, U100.W7, U100.W20, U100.Y5, U100.Y15, XU1.AB02 (VSS), XU1.AB04 (HOLD), XU1.AB36 (VSS), XU1.AD02 (VSS), XU1.AD36 (VSS), XU1.AF02 (VSS), XU1.AF36 (VSS), XU1.AH02 (VSS), XU1.AJ37 (VSS), XU1.AL37 (VSS), XU1.AM08 (VSS), XU1.AM10 (VSS), XU1.AM12 (VSS), XU1.AM14 (VSS), XU1.AM16 (VSS), XU1.AM18 (VSS), XU1.AM20 (VSS), XU1.AM22 (VSS), XU1.AM24 (VSS), XU1.AM26 (VSS), XU1.AM28 (VSS), XU1.AM30 (VSS), XU1.AN37 (VSS), XU1.B06 (VSS), XU1.B08 (VSS), XU1.B10 (VSS), XU1.B12 (VSS), XU1.B14 (VSS), XU1.B16 (VSS), XU1.B18 (VSS), XU1.B20 (VSS), XU1.B22 (VSS), XU1.B24 (VSS), XU1.B26 (VSS), XU1.B28 (VSS), XU1.H02 (VSS), XU1.H36 (VSS), XU1.K02 (VSS), XU1.K36 (VSS), XU1.M02 (VSS), XU1.M36 (VSS), XU1.P02 (VSS), XU1.P36 (VSS), XU1.R02 (VSS), XU1.R36 (VSS), XU1.T02 (VSS), XU1.T36 (VSS), XU1.U35 (VSS), XU1.V02 (VSS), XU1.V36 (VSS), XU1.W03 (EWBE#), XU1.X02 (VSS), XU1.X36 (VSS), XU1.Z02 (VSS), XU1.Z36 (VSS), Y1.2, Y1.4, Y2.2, Y2.4
VCC2: C207.1, C208.1, C209.1, C210.1, C300.1, C301.1, C302.1, C303.1, C304.1, C305.1, C306.1, C307.1, C308.1, C309.1, C310.1, C314.1, C315.1, C316.1, C317.1, C321.1, C322.1, C323.1, C324.1, C325.1, C328.1, C329.1, C330.1, C334.1, C335.1, C336.1, C340.1, C341.1, C342.1, C346.1, C347.1, C348.1, C352.1, C353.1, C354.1, C358.1, C359.1, C360.1, L1.2, L7.2, R208.1, R303.1, XU1.A07 (VCC2), XU1.A09 (VCC2), XU1.A11 (VCC2), XU1.A13 (VCC2), XU1.A15 (VCC2), XU1.A17 (VCC2), XU1.AA01 (VCC2), XU1.AC01 (VCC2), XU1.AE01 (VCC2), XU1.AG01 (VCC2), XU1.AN09 (VCC2), XU1.AN11 (VCC2), XU1.AN13 (VCC2), XU1.AN15 (VCC2), XU1.AN17 (VCC2), XU1.AN19 (VCC2), XU1.G01 (VCC2), XU1.J01 (VCC2), XU1.L01 (VCC2), XU1.N01 (VCC2), XU1.Q01 (VCC2), XU1.S01 (VCC2), XU1.U01 (VCC2), XU1.W01 (VCC2), XU1.Y01 (VCC2)
cbsel0: R411.1, U100.R6
cbsel1: R412.1, U100.T6
cck: J2.4, U8.6, U100.AA3
cdi0: J2.6, U8.5, U100.W2
cdi1: J2.5, U8.2, U100.W3
cdi2: R413.1, U8.3, U100.AA1
cdi3: R414.1, U8.7, U100.Y1
cdone: R407.1, U100.U8
cpu_a20m_n: U100.E3, XU1.AK08 (A20M#)
cpu_a[3]: U100.J4, XU1.AL35 (A3)
cpu_a[4]: U100.H5, XU1.AM34 (A4)
cpu_a[5]: U100.K1, XU1.AK32 (A5)
cpu_a[6]: U100.C18, XU1.AN33 (A6)
cpu_a[7]: U100.J3, XU1.AL33 (A7)
cpu_a[8]: U100.B15, XU1.AM32 (A8)
cpu_a[9]: U100.E9, XU1.AK30 (A9)
cpu_a[10]: U100.J1, XU1.AN31 (A10)
cpu_a[11]: U100.G4, XU1.AL31 (A11)
cpu_a[12]: U100.G6, XU1.AL29 (A12)
cpu_a[13]: U100.E11, XU1.AK28 (A13)
cpu_a[14]: U100.E7, XU1.AL27 (A14)
cpu_a[15]: U100.H1, XU1.AK26 (A15)
cpu_a[16]: U100.D13, XU1.AL25 (A16)
cpu_a[17]: U100.G3, XU1.AK24 (A17)
cpu_a[18]: U100.F6, XU1.AL23 (A18)
cpu_a[19]: U100.F7, XU1.AK22 (A19)
cpu_a[20]: U100.F1, XU1.AL21 (A20)
cpu_a[21]: U100.D19, XU1.AF34 (A21)
cpu_a[22]: U100.D16, XU1.AH36 (A22)
cpu_a[23]: U100.J5, XU1.AE33 (A23)
cpu_a[24]: U100.F10, XU1.AG35 (A24)
cpu_a[25]: U100.K3, XU1.AJ35 (A25)
cpu_a[26]: U100.F11, XU1.AH34 (A26)
cpu_a[27]: U100.F13, XU1.AG33 (A27)
cpu_a[28]: U100.D15, XU1.AK36 (A28)
cpu_a[29]: U100.K2, XU1.AK34 (A29)
cpu_a[30]: U100.L1, XU1.AM36 (A30)
cpu_a[31]: U100.F12, XU1.AJ33 (A31)
cpu_ads_n: U100.E2, XU1.AJ05 (ADS#)
cpu_ahold: U100.C5, XU1.V04 (AHOLD)
cpu_ap: R252.1, XU1.AK02 (AP)
cpu_be[0]: U100.C3, XU1.AL09 (BE0#)
cpu_be[1]: U100.D3, XU1.AK10 (BE1#)
cpu_be[2]: U100.E8, XU1.AL11 (BE2#)
cpu_be[3]: U100.D5, XU1.AK12 (BE3#)
cpu_be[4]: U100.F4, XU1.AL13 (BE4#)
cpu_be[5]: U100.D11, XU1.AK14 (BE5#)
cpu_be[6]: U100.F2, XU1.AL15 (BE6#)
cpu_be[7]: U100.D10, XU1.AK16 (BE7#)
cpu_bf[0]: U100.G2, XU1.Y33 ([BF0])
cpu_bf[1]: U100.C16, XU1.X34 ([BF1])
cpu_boff_n: U100.B2, XU1.Z04 (BOFF#)
cpu_brdy_n: U100.B9, XU1.X04 (BRDY#)
cpu_cache_n: U100.B5, XU1.U03 (CACHE#)
cpu_clk: U9.10, XU1.AK18 (CLK)
cpu_d[0]: U100.C17, XU1.K34 (D0)
cpu_d[1]: U100.K18, XU1.G35 (D1)
cpu_d[2]: U100.D18, XU1.J35 (D2)
cpu_d[3]: U100.C20, XU1.G33 (D3)
cpu_d[4]: U100.L19, XU1.F36 (D4)
cpu_d[5]: U100.J19, XU1.F34 (D5)
cpu_d[6]: U100.H18, XU1.E35 (D6)
cpu_d[7]: U100.C21, XU1.E33 (D7)
cpu_d[8]: U100.K19, XU1.D34 (D8)
cpu_d[9]: U100.N22, XU1.C37 (D9)
cpu_d[10]: U100.K21, XU1.C35 (D10)
cpu_d[11]: U100.J18, XU1.B36 (D11)
cpu_d[12]: U100.E18, XU1.D32 (D12)
cpu_d[13]: U100.T22, XU1.B34 (D13)
cpu_d[14]: U100.H20, XU1.C33 (D14)
cpu_d[15]: U100.L20, XU1.A35 (D15)
cpu_d[16]: U100.G19, XU1.B32 (D16)
cpu_d[17]: U100.F14, XU1.C31 (D17)
cpu_d[18]: U100.G18, XU1.A33 (D18)
cpu_d[19]: U100.G16, XU1.D28 (D19)
cpu_d[20]: U100.F17, XU1.B30 (D20)
cpu_d[21]: U100.B17, XU1.C29 (D21)
cpu_d[22]: U100.F19, XU1.A31 (D22)
cpu_d[23]: U100.B18, XU1.D26 (D23)
cpu_d[24]: U100.E16, XU1.C27 (D24)
cpu_d[25]: U100.L5, XU1.C23 (D25)
cpu_d[26]: U100.E13, XU1.D24 (D26)
cpu_d[27]: U100.E14, XU1.C21 (D27)
cpu_d[28]: U100.B21, XU1.D22 (D28)
cpu_d[29]: U100.L2, XU1.C19 (D29)
cpu_d[30]: U100.D8, XU1.D20 (D30)
cpu_d[31]: U100.D9, XU1.C17 (D31)
cpu_d[32]: U100.H3, XU1.C15 (D32)
cpu_d[33]: U100.F8, XU1.D16 (D33)
cpu_d[34]: U100.E6, XU1.C13 (D34)
cpu_d[35]: U100.M3, XU1.D14 (D35)
cpu_d[36]: U100.H2, XU1.C11 (D36)
cpu_d[37]: U100.D14, XU1.D12 (D37)
cpu_d[38]: U100.C11, XU1.C09 (D38)
cpu_d[39]: U100.C10, XU1.D10 (D39)
cpu_d[40]: U100.D6, XU1.D08 (D40)
cpu_d[41]: U100.B10, XU1.A05 (D41)
cpu_d[42]: U100.F5, XU1.E09 (D42)
cpu_d[43]: U100.A18, XU1.B04 (D43)
cpu_d[44]: U100.C12, XU1.D06 (D44)
cpu_d[45]: U100.C7, XU1.C05 (D45)
cpu_d[46]: U100.D4, XU1.E07 (D46)
cpu_d[47]: U100.B19, XU1.C03 (D47)
cpu_d[48]: U100.B4, XU1.D04 (D48)
cpu_d[49]: U100.C6, XU1.E05 (D49)
cpu_d[50]: U100.A20, XU1.D02 (D50)
cpu_d[51]: U100.B13, XU1.F04 (D51)
cpu_d[52]: U100.A7, XU1.E03 (D52)
cpu_d[53]: U100.B7, XU1.G05 (D53)
cpu_d[54]: U100.A5, XU1.E01 (D54)
cpu_d[55]: U100.A14, XU1.G03 (D55)
cpu_d[56]: U100.B8, XU1.H04 (D56)
cpu_d[57]: U100.A12, XU1.J03 (D57)
cpu_d[58]: U100.B22, XU1.J05 (D58)
cpu_d[59]: U100.B12, XU1.K04 (D59)
cpu_d[60]: U100.C13, XU1.L05 (D60)
cpu_d[61]: U100.A17, XU1.L03 (D61)
cpu_d[62]: U100.A16, XU1.M04 (D62)
cpu_d[63]: U100.B14, XU1.N03 (D63)
cpu_dc_n: U100.C1, XU1.AK04 (D/C#)
cpu_dp[0]: R253.1, XU1.D36 (DP0)
cpu_dp[1]: R254.1, XU1.D30 (DP1)
cpu_dp[2]: R255.1, XU1.C25 (DP2)
cpu_dp[3]: R256.1, XU1.D18 (DP3)
cpu_dp[4]: R257.1, XU1.C07 (DP4)
cpu_dp[5]: R258.1, XU1.F06 (DP5)
cpu_dp[6]: R259.1, XU1.F02 (DP6)
cpu_dp[7]: R260.1, XU1.N05 (DP7)
cpu_eads_n: U100.E4, XU1.AM04 (EADS#)
cpu_flush_n: R261.1, XU1.AN07 (FLUSH#)
cpu_frcmc_n: R262.1, XU1.Y35 (FRCMC#1)
cpu_hitm_n: U100.D1, XU1.AL05 (HITM#)
cpu_ignne_n: R263.1, XU1.AA35 (IGNNE#)
cpu_init: U100.E10, XU1.AA33 (INIT)
cpu_intr: U100.C15, XU1.AD34 (INTR/LINT0)
cpu_ken_inv_n: U100.A4, XU1.U05 (INV), XU1.W05 (KEN#)
cpu_lock_n: U100.C2, XU1.AH04 (LOCK#)
cpu_mio_n: U100.A2, XU1.T04 (M/IO#)
cpu_na_n: U100.B3, XU1.Y05 (NA#)
cpu_nmi: U100.K4, XU1.AC33 (NMI/LINT1)
cpu_pen_n: R264.1, XU1.Z34 (PEN#)
cpu_picd1: R265.1, XU1.L35 (PICD1)
cpu_reset: R269.1, U100.A15, XU1.AK20 (RESET)
cpu_smi_n: R266.1, XU1.AB34 (SMI#)
cpu_smiact_n: R267.1, XU1.AG03 (SMIACT#)
cpu_stpclk_n: R268.1, XU1.V34 (STPCLK#)
cpu_tck: J6.1, XU1.M34 (TCK)
cpu_tdi: J6.3, XU1.N35 (TDI)
cpu_tdo: J6.4, XU1.N33 (TDO)
cpu_tms: J6.2, XU1.P34 (TMS)
cpu_trst_n: J6.5, R270.1, XU1.Q33 (TRST#)
cpu_wbwt_n: U100.B1, XU1.AA05 (WB/WT#)
cpu_wr_n: U100.E1, XU1.AM06 (W/R#)
creset_n: C441.1, R406.1, U11.14, U13.4, U20.14, U21.1, U100.T9
csi: R408.1, U100.AA2
en_grp2: C440.1, R440.2, R441.1, U11.10, U13.13, U18.14, U19.14, U20.10, U21.27
en_vcc2: U10.27, U17.27, U100.A6
eth_mdc: U7.13, U100.F21
eth_mdi_rxn: J1.6, R250.1, U7.22
eth_mdi_rxp: J1.3, R249.1, U7.23
eth_mdi_txn: J1.2, R248.1, U7.20
eth_mdi_txp: J1.1, R247.1, U7.21
eth_mdio: U7.12, U100.F20
eth_nintsel: R246.1, U7.2
eth_rbias: R245.1, U7.24
eth_ref_clk: U7.14, U100.F22
eth_rmii_crs_dv: U7.11, U100.G22
eth_rmii_rx_er: U7.10, U100.H22
eth_rmii_rxd[0]: U7.8, U100.H21
eth_rmii_rxd[1]: U7.7, U100.J21
eth_rmii_tx_en: U7.16, U100.E22
eth_rmii_txd[0]: U7.17, U100.D20
eth_rmii_txd[1]: U7.18, U100.D21
eth_rst_n: U7.15, U100.E21
eth_vdda: C281.2, C282.1, C283.1, C284.1, C288.1, J1.4, J1.5, R247.2, R248.2, R249.2, R250.2, U7.1, U7.19
eth_vddcr: C286.1, C287.1, U7.6
eth_xtal1: C289.1, U7.5, Y1.1
eth_xtal2: C290.1, R251.1, Y1.3
eth_xtal2_drv: R251.2, U7.4
fan_pwm: J7.4, Q1.3
fan_pwm_g: Q1.1, R302.1, U100.M22
fan_tach: J7.3, R300.1, R301.1
fan_tach_f: C400.1, R300.2, U100.C22
fpga_refclk: U9.9, U100.A11
i2c_scl: R309.1, U9.4, U10.3, U14.5, U100.A10
i2c_sda: R310.1, U9.5, U10.2, U14.4, U100.A9
jtag_tck: J5.6, U100.F15
jtag_tdi: J5.10, U100.F16
jtag_tdo: J5.8, U100.E17
jtag_tms: J5.4, U100.B20
ref_res_2a: R400.1, U100.U19
ref_res_2c: R401.1, U100.J17
ref_res_3a: R404.1, U100.E19
ref_res_4a: R402.1, U100.G5
ref_res_4c: R403.1, U100.U4
ssl_n: J2.3, R410.1, U8.1, U100.Y3
sw_0v62: C270.2, L11.1, U21.8, U21.9, U21.10, U21.11, U21.12
sw_0v85: C252.2, L9.1, U19.11, U19.12
sw_0v95: C243.2, L8.1, U18.11, U18.12
sw_1v1: C261.2, L10.1, U20.11, U20.12
sw_1v8: L4.1, U13.1, U13.2, U13.3
sw_3v3: C220.2, L2.1, U11.11, U11.12
sw_5v: C229.2, L5.1, U15.11, U15.12
sw_vcc2: C202.2, L1.1, U10.8, U10.9, U10.10, U10.11, U10.12
sw_vcc2_b: C213.2, L7.1, U17.8, U17.9, U17.10, U17.11, U17.12
test_n: R409.1, U100.T5
tsen_socket: C406.1, R311.2, R312.1, RT1.1, U100.L21
u9_xa: C291.1, U9.2, Y2.1
u9_xb: C292.1, U9.3, Y2.3
u10_avin: C206.1, R200.2, U10.26
u10_boot: C202.1, U10.7
u10_bp1v5: C200.1, R201.1, R203.1, R205.1, U10.4
u10_drtn: C200.2, U10.5
u10_msel1: R201.2, R202.1, U10.32
u10_msel2: R203.2, R204.1, U10.29
u10_pgood: R207.2, U10.1
u10_vdd5: C201.1, U10.28
u10_vsel: R205.2, R206.1, U10.30
u11_boot: C220.1, U11.13
u11_comp: R213.1, U11.8
u11_compz: C226.1, R213.2
u11_fb: R214.2, R215.1, U11.7
u11_rt: R212.1, U11.1
u11_ss: C221.1, U11.9
u13_fb: R220.2, R221.1, U13.5
u13_ss: C238.1, U13.9
u15_boot: C229.1, U15.13
u15_comp: R217.1, U15.8
u15_compz: C235.1, R217.2
u15_fb: R218.2, R219.1, U15.7
u15_rt: R216.1, U15.1
u15_ss: C230.1, U15.9
u17_avin: C217.1, R210.2, U17.26
u17_boot: C213.1, U17.7
u17_bp1v5: C211.1, U17.4, U17.34
u17_drtn: C211.2, U17.5
u17_msel2: R211.1, U17.29
u17_vdd5: C212.1, U17.28
u18_boot: C243.1, U18.13
u18_comp: R223.1, U18.8
u18_compz: C249.1, R223.2
u18_fb: R224.2, R225.1, U18.7
u18_rt: R222.1, U18.1
u18_ss: C244.1, U18.9
u19_boot: C252.1, U19.13
u19_comp: R227.1, U19.8
u19_compz: C258.1, R227.2
u19_fb: R228.2, R229.1, U19.7
u19_rt: R226.1, U19.1
u19_ss: C253.1, U19.9
u20_boot: C261.1, U20.13
u20_comp: R231.1, U20.8
u20_compz: C267.1, R231.2
u20_fb: R232.2, R233.1, U20.7
u20_rt: R230.1, U20.1
u20_ss: C262.1, U20.9
u21_adrsel: R241.2, R242.1, U21.31
u21_avin: C275.1, R234.2, U21.26
u21_boot: C270.1, U21.7
u21_bp1v5: C268.1, R235.1, R237.1, R239.1, R241.1, U21.4
u21_drtn: C268.2, U21.5
u21_msel1: R239.2, R240.1, U21.32
u21_msel2: R237.2, R238.1, U21.29
u21_vdd5: C269.1, U21.28
u21_vsel: R235.2, R236.1, U21.30
uart_rx: J4.2, U100.G20
uart_tx: J4.3, U100.J20
vcc2_bcx_clk: U10.39, U17.39
vcc2_bcx_dat: U10.40, U17.40
vcc2_gsense: R209.2, U10.34
vcc2_sense: R208.2, U10.33
vcc2_sync: U10.38, U17.38
vcc2_vshare: U10.35, U17.35
vsen_3v3: C404.1, R305.2, R306.1, U100.A21
vsen_12v: C405.1, R307.2, R308.1, U100.L22
vsen_vcc2: C403.1, R303.2, R304.1, U100.K22
zq: R405.1, U100.V11
