alphaonex86/FPGAmotherboard/(commit log)

2026-10-18 Publish the motherboards' KiCad files
    From socket3@c0f6464 socket7@9205469 socket370@524f5b1 i386@daf47f8
    [Efinix_Ti180_J484_15x15mm.step, Intel_PQFP-100_19.05x19.05mm_P0.635mm.step, L_6.3x6.3_H3.step, L_7.3x7.3_H4.5.step, Oscillator_SMD_Abracon_ASE-4Pin_3.2x2.5mm.step, PGA370_Socket_ZIF.step, RJ45_Hanrun_HR911105A_Horizontal.step, Socket3_Am5x86_237.step]
2026-10-28 Publish the motherboards' KiCad files
    From socket3@c0f6464 socket7@9205469 socket370@524f5b1 i386@bea926c
    [i386sx-motherboard-cpu-1-3.kicad_sch, i386sx-motherboard-cpu-2-3.kicad_sch, i386sx-motherboard-cpu-3-3.kicad_sch, i386sx-motherboard-ethernet.kicad_sch, i386sx-motherboard-fpga-1-12.kicad_sch, i386sx-motherboard-fpga-10-12.kicad_sch, i386sx-motherboard-fpga-11-12.kicad_sch, i386sx-motherboard-fpga-12-12.kicad_sch]
2026-10-29 Publish the motherboards' KiCad files
    From socket3@df617bd socket7@87d0072 socket370@615c2da i386@dcffc60
    [L_6.3x6.3_H3.step, L_7.3x7.3_H4.5.step, RJ45_Hanrun_HR911105A_Horizontal.step, Socket3_Am5x86_237.step, Texas_RVF0040A_LQFN-CLIP-40_5x7mm_P0.5mm.step, i386sx-gw2ar18.kicad_pcb, i386sx-motherboard.kicad_pcb, socket3-csg324.kicad_pcb]
