alphaonex86/FPGAmotherboard/(notices)

Notices in the files:
socket3/fpga-xc7a50t-csg324/hw/3dmodels/RJ45_Hanrun_HR911105A_Horizontal.step:
source: https://github.com/LanguidSmartass/altium-libs/blob/master/libs/00_Connectors/RJ-Telephone%20connectors/3D%20Models/Magjacks/HR911105A.STEP; licence: repo LICENSE is MIT (c) 2019 Ivan Novoselov; repo README states the 3D models were grabbed from other open sources, so the model''s own upstre
